SWORT-Aerospace/sem-motor-controller/hardware/interfaces/README.md

# Interfaces

* `pin_allocation_STM32G474VBCETx.csv` (LQFP100, proposed), `..._MBCETx.csv` (LQFP80), `..._RBCETx.csv` (LQFP64): candidate pin maps produced by `tools/pin_allocation.py` from ST's open pin database (BSD-3, commit 7d1f151). Status: CANDIDATE — AF numbers and timing not verified.
* Electrical I/O list: `docs/INTERFACE_CONTROL.md` §3.
* CAN: `docs/generated/can_messages.md`.
