SWORT-Aerospace/sem-motor-controller/hardware/timing/timing_budget.md

# MCU timing allocation and current-sampling budget (generated)

> Generated by `tools/timing_budget.py`. Tags: [C] project config (synthetic), [R] recalled from ST/TI documentation and **not verified** here, [A] assumption to be measured at bench stage 3/4, [D] design value in the schematic draft. Nothing here is a hardware measurement.

## Inputs

| constant | value | tag | note |
|---|---|---|---|
| f_sysclk_Hz | 170000000.0 | [R] | STM32G474 max SYSCLK (boost mode) |
| f_pwm_Hz | 20000.0 | [C] | inverter.pwm_frequency_Hz |
| t_dead_s | 2e-07 | [C] | inverter.deadtime_s |
| duty_max | 0.98 | [C] | inverter.duty_max |
| f_adc_Hz | 42500000.0 | [R] | ADC clock = HCLK/4 synchronous (one legal choice; max ADC clock to verify) |
| adc_sample_cycles | 6.5 | [D] | sampling time setting for the CSA channels (2.5..640.5 selectable [R]) |
| adc_conv_cycles | 12.5 | [R] | 12-bit successive-approximation conversion |
| c_sh_F | 5e-12 | [R] | ADC sample-and-hold capacitance (order of magnitude) |
| r_filter_ohm | 100.0 | [D] | CSA output series R (current_sense sheet) |
| c_filter_F | 4.7e-10 | [D] | CSA output shunt C (current_sense sheet) |
| t_ring_s | 5e-07 | [A] | switch-node ringing settle after the low-side turns on |
| t_csa_settle_s | 1e-06 | [A] | CSA output settling to 0.1 % after the step (SLVSDY6x value NOT read) |
| voltage_limit_fraction | 0.95 | [C] | inverter.voltage_limit_fraction (FOC uses this x Vbus/sqrt(3)) |
| t_dts_div | 1 | [D] | TIM1 CKD = 1 -> t_DTS = 1/f_tim |
| brk_filter_samples | 4 | [D] | TIM1 BKF digital filter length (N samples at f_DTS) |
| fast_isr_cycles_est | TBD | [A] | FOC fast-step cycles: MEASURE with DWT->CYCCNT at stage 2 |

## PWM (TIM1, centre-aligned, complementary, 6-PWM to the gate driver)

* Period 50.0 us; ARR = f_tim / (2 f_pwm) = 4250 (duty resolution 0.024 %).
* Dead time 200 ns -> BDTR.DTG = 0x22 -> 200.0 ns achieved (t_DTS = 5.88 ns). The gate driver may add its own dead time; the effective dead time is the larger of the two and must be measured at the gate (stage 3).

## Phase-current sampling on three ADCs (PROPOSED, not substantiated)

* **Proposed, not yet substantiated:** it holds only once the trigger configuration, the ADC synchronisation, the acquisition windows and a bench measurement (stage 4) confirm it.
* Phase A on ADC1, phase B on ADC2 (dual simultaneous injected mode), phase C on ADC3, injected, with the same external trigger TIM1_TRGO2 [R]. The three sample-and-hold instants would coincide to within ADC clock synchronisation (< 1 ADC clock); in v0.1 phase C sat behind phase A in ADC1 by 447 ns.
* Pins (generated, `hardware/interfaces/pin_allocation_STM32G474VBCETx.csv`): PA0 ADC1_IN1, PA1 ADC2_IN2, PE7 ADC3_IN4, all IN1..IN5 "fast" channels [R].
* Sampling time 6.5 cycles = 153 ns; with conversion 447 ns. External RC tau = 47 ns; settling to 1 LSB (12 bit) = 391 ns. Charge kick-back from C_SH: 1.05 % of the step between successive samples on the same input, absorbed by the 470 pF reservoir (re-check with the real C_SH).

## Sampling window (low-side shunts, sample at the PWM valley)

* Time needed between low-side turn-on and the sample: dead time + ringing + max(CSA settle, RC settle) = 1.70 us ([A] ringing 500 ns, [A] CSA settle 1.0 us).
* Largest sampleable duty: **0.932** (configured duty_max 0.98).
* Over all SVPWM angles at the configured voltage limit (0.95 x Vbus/sqrt(3)), the minimum number of phases with a valid window is **2**. Firmware rule: a phase is valid only when its duty is <= 0.932. With one invalid phase, the controller reconstructs it from the other two (`mc_currents_resolve`; reconstructed phase flagged, KCL residual unavailable). With two or more invalid phases, it would need to reduce duty_max; not reached at these values.

### Largest safe voltage-limit fraction (validator rule 39)

Rule 39: 0.5 + (sqrt(3)/4) m <= 1 - 2 (t_dead + t_settle) f_pwm, where t_settle = `inverter.current_sample_settle_s` is measured at stage 4. The second-highest min-max SVPWM duty peaks at 60 deg; satisfying the rule leaves two sampleable phases at every angle.

| f_pwm kHz | settle 0.5us | settle 1.0us | settle 1.5us | settle 2.0us | settle 3.0us |
|---|---|---|---|---|---|
| 10 | 1.000 | 1.000 | 1.000 | 1.000 | 1.000 |
| 16 | 1.000 | 1.000 | 1.000 | 0.992 | 0.918 |
| 20 | 1.000 | 1.000 | 0.998 | 0.951 | 0.859 |
| 25 | 1.000 | 1.000 | 0.958 | 0.901 | 0.785 |

With the configured limit 0.95 at 20 kHz, the rule holds while the measured settle stays at or below 2.02 us. Above that, the validator rejects the calibration until the limit or the PWM frequency is lowered (synthetic value 1.5 us).

## Break (hardware shutdown) routing

| source | path | polarity | action |
|---|---|---|---|
| Gate-driver nFAULT (VDS over-current, UVLO, thermal, ...) [R] | PE15 TIM1_BKIN | active low, open drain + 10 k pull-up | MOE cleared asynchronously; outputs to idle state |
| Bus over-voltage comparator (TLV7041) | PC3 TIM1_BKIN2 | active low, open drain | as above |
| (option) MCU COMPx on CSA outputs | internal to TIM1_BKIN2 [R] | configurable | phase over-current without a pin; not used in the draft |

* Idle state: OSSI = 1, OISx = OISxN = 0, so every INHx/INLx is driven low and the driver holds all gates off. AOE = 0: MOE is never re-set automatically; only firmware does it, after a fault reset.
* BKF digital filter: 4 samples -> 24 ns added latency [D]. Measure the total input-to-gate-off latency at stage 3.

## Startup pin states (reset until firmware configures the pins)

| signal | state during/after reset | why it is safe |
|---|---|---|
| MCU GPIOs | analog / high impedance [R] (debug pins PA13/PA14/PB3 excepted) | nothing below depends on an MCU pin being driven |
| DRV ENABLE | low: MCU_DRV_EN pulled down 100 k and ANDed with HW_PERMIT (74LVC1G08); output pulled down 100 k | gate driver disabled, all gates off [R] |
| INHx / INLx | low: driver internal pull-downs [R]; DNP 100 k pads | no switching command |
| Precharge bypass | off: PRECHG_EN pulled down 100 k | DC link charges only through the precharge resistor |
| CAN TXD | recessive: transceiver TXD pull-up [R] | no bus disturbance during reset |
| BOOT0 (PB8) | low: 10 k pull-down | boots from flash |

## Interrupt and task timing allocation

| priority | source | rate | budget | content |
|---|---|---|---|---|
| 0 (highest) | TIM1 BRK / BRK2 | event | < 2 us | latch fault flag; hardware has already stopped the outputs |
| 1 | ADC JEOC (injected end of conversion) | 20 kHz | <= 40 % of 50 us = 20 us | `mc_core_fast_step`: hall, currents, FOC, duty update (preloaded) |
| 2 | FDCAN RX FIFO | <= 2 kHz | <= 5 us | copy the frame to a queue; decoding runs in the slow task |
| 3 | SysTick / slow task | 1 kHz | <= 300 us | `mc_core_slow_step`, CAN RX decoding, TX polling, watchdog kick |
| background | idle | - | - | logging over UART (bench only) |

The fast-step cycle count is **not measured**. The host build shows no double-precision calls in `mc_core_fast_step` (objdump, MinSizeRel). It uses `sinf`/`cosf` from newlib. Measure DWT->CYCCNT around the ISR at stage 2 and replace `fast_isr_cycles_est`. If it exceeds the budget, use a table-based sin/cos, or run the FOC every second PWM period with ADC sampling every period.
