SWORT-Aerospace/sem-motor-controller/hardware/kicad/CONNECTIVITY_CHECK.md

# Schematic connectivity check (generated)

kicad-cli 7.0.11 exported the netlist of the draft; every intended net was compared with KiCad's computed connectivity (same node set).

* intended nets: 135
* KiCad nets: 173 (of which no-connect singletons: 38)
* problems: 0

No mismatches: KiCad connectivity equals the intended connectivity.

This checks connectivity only. It is not an electrical rules check (KiCad 7 has no CLI ERC) and not a design review.
