SWORT-Aerospace/sem-motor-controller/docs/BUDGET.md

# Budget decision: priced draft design (provisional)

> Generated by `tools/price_bom.py` from the schematic-derived BOM (`hardware/bom/BOM_draft.csv`) and the pricing evidence in `hardware/bom/pricing.yaml`. **Nothing has been purchased.**

> **Price quality.** Distributor sites could not be opened from this environment. Prices come from web-search snapshots of distributor pages (undated caches, retrieved 2026-10-15), from **representative** candidates for the rating-dependent parts (not selections), or from stated **allowances**. Every number is a range. Re-quote on live pages before deciding anything.

## 1. One board's parts by evidence class

| evidence | BOM lines | parts cost per board |
|---|---|---|
| allowance | 84 | $24.07 – $123.80 |
| representative | 11 | $40.91 – $77.56 |
| snippet | 5 | $24.20 – $29.66 |
| **total** | 100 | **$89.18 – $231.02** |

The rating-dependent lines (MOSFETs, shunts, bulk capacitors, fuse, TVS, P-FET, connectors) are priced as representatives. Their real cost moves with the motor and battery ratings.

## 2. Scenarios (low – high)

| scenario | A. controller only | B. A + vehicle integration | C. B + bring-up equipment if not owned | $500 − B (low / high end) | $1,000 − C (low / high end) |
|---|---|---|---|---|---|
| S1 one functional prototype | $246 – $650 | $311 – $825 | $415 – $1,189 | $189 / −$325 | $585 / −$189 |
| S1R one prototype + one revision | $337 – $898 | $402 – $1,073 | $506 – $1,437 | $98 / −$573 | $494 / −$437 |
| S2 two assembled boards | $353 – $953 | $428 – $1,158 | $532 – $1,522 | $72 / −$658 | $468 / −$522 |
| S2R two boards + one revision | $443 – $1,201 | $518 – $1,406 | $622 – $1,770 | −$18 / −$906 | $378 / −$770 |

A = board parts, spares, PCB, shipping, stencil, consumables, heatsink, tax/shipping on parts, and the revision allowance where named. B adds connectors, harness, enclosure and bench load. C adds the bring-up tools the team may not own; an oscilloscope and a differential probe are NOT included and must be borrowed. A negative remainder means over budget at that end of the range.

Contingency = budget minus the HIGH end of the range. The vs-$500 column assumes the team already owns the bring-up equipment; the vs-$1,000 column assumes it buys the listed items (an oscilloscope and a differential probe are NOT included: they must be borrowed).

## 3. Line items of scenario S1 (one prototype)

* Parts for one board: $89 – $231; spares (6 MOSFETs, gate driver, 2 shunts, TVS, 2 fuses, CAN transceiver, MCU): $58 – $93; tax and shipping on parts: $12 – $77.
* PCB fabrication, 5 boards, 4-layer, 2 oz outer copper, ~100x120 mm: $40 – $120 (allowance)
* PCB shipping (express): $20 – $45 (allowance)
* Stencil (frameless) for hand assembly: $8 – $25 (allowance)
* Assembly consumables (paste, flux, wick): $10 – $25 (allowance)
* Thermal interface + heatsink plate + fasteners: $10 – $35 (allowance)
* [integration] Battery and motor mating connectors (XT90 pair, MR60/bullets): $5 – $15 (snippet)
* [integration] Signal connectors + crimp terminals (driver controls, hall, CAN, temp): $10 – $30 (allowance)
* [integration] Wire (10-12 AWG silicone, signal multicore, CAN twisted pair), heat-shrink, sleeving: $25 – $60 (allowance)
* [integration] Enclosure / mounting (printed or folded aluminium): $10 – $30 (allowance)
* [integration] Bench dummy load / power resistors + bench harness: $15 – $40 (allowance)
* [equipment, only if not owned] SWD programmer (STLINK-V3MINIE): $14 – $44 (snippet: Cytech ref $14.04; Farnell IE EUR 12.51 incl. VAT; Waveshare GBP 37.58 (snapshots))
* [equipment, only if not owned] USB-CAN adapter (CANable-class, candleLight firmware): $30 – $60 (allowance: not quoted)
* [equipment, only if not owned] Current-limited bench supply (>= 60 V or series-able, CC mode): $60 – $200 (allowance: not quoted)
* [equipment, only if not owned] Oscilloscope >= 100 MHz, 4 ch (+ differential probe for the switch node): $0 – $0 (allowance: assumed borrowed from the lab: NOT in the budget; a differential probe can cost more than this whole budget)
* [equipment, only if not owned] Bench DMM x2, clamp/current probe: $0 – $60 (allowance: assumed owned; clamp meter if not)

## 4. Decision statement (computed, not asserted)

* One prototype, controller only (A): STRADDLES $500 ($246 – $650): within only if prices land in the lower part of the range.
* One prototype with vehicle integration, equipment owned (B): STRADDLES $500 ($311 – $825): within only if prices land in the lower part of the range.
* One prototype + one revision + integration, equipment owned (B): STRADDLES $500 ($402 – $1,073): within only if prices land in the lower part of the range.
* Two boards + integration, equipment owned (B): STRADDLES $1,000 ($428 – $1,158): within only if prices land in the lower part of the range.
* Two boards + one revision + integration + equipment (C): STRADDLES $1,000 ($622 – $1,770): within only if prices land in the lower part of the range.

Largest contributors to the low–high spread (scenario S1): board parts (allowance + representative + snippet) ($142); PCB fabrication, 5 boards, 4-layer, 2 oz outer copper, ~100x120 mm ($80); tax and shipping on parts ($65); Wire (10-12 AWG silicone, signal multicore, CAN twisted pair), heat-shrink, sleeving ($35); spares ($35).

**Conclusion: the budget is not shown to be feasible.** At least one range reaches past its limit, so feasibility cannot be claimed until the spread is closed. Closing the spread takes: a live PCB quote for the actual board size and copper weight; live distributor quotes for the snippet lines; the motor and battery ratings (they fix the representative power-stage lines and the heatsink); and an inventory check of the passives and equipment the team already owns. Each of these narrows the range, and `tools/price_bom.py` recomputes the statement.

Conditions behind all the ranges:
  1. rating-dependent parts stay in the representative class (100 V D2PAK MOSFETs, 2512 shunts, ~220 µF bulk); ≥ 80 A peak or a battery above ~60 V changes the power stage, heatsink and copper weight;
  2. stock gaps seen in the snapshots are resolved (INA228 in the US, DRV8353SRTAR at Digi-Key, the 1 mΩ Kelvin shunt at 38 weeks);
  3. hand assembly by the vehicle team with the stencil (no PCBA service);
  4. an oscilloscope, a differential probe, a rework station and a reflow method are available.
