SWORT-Aerospace/sem-motor-controller/docs/generated/control_contract_before_after.md

# Control contract: before / after (SYNTHETIC)

> **What is checked, and what is not.** These rows check **command-ceiling compliance** (the accepted torque command against the hard ceiling) and **supervisory envelope ramp compliance** (against the permitted ramp: output above the envelope must fall at no less than slew_down_fast = 100 N*m/s, i.e. by slew_down_fast x dt on every update, so the worst-case deadline is max_motor_torque / slew_down_fast = 2 / 100 = 20 ms, which validator rule 38 bounds by supervision.timeout_s = 100 ms; SYNTHETIC values). They do **not** show the physical phase-current response (current-loop tracking on a real motor) or the battery-input current; those need bench measurements (`hardware/bringup/`).

> Host harness `firmware/platform/host/contract_report_main.c` on the synthetic configuration. Before = arbiter/core of commit `c0df363`; after = this tree. The hard ceiling and envelope columns are computed by an **independent oracle in the harness** from the contract (not read back from the arbiter). Every update is checked, not only the rows shown. Not hardware evidence. Generated by `tools/control_contract_report.py`.

## Contract checks over every update

| scenario | updates | hard-ceiling (command) violations before -> after (max excess N*m) | envelope-ramp violations before -> after (max excess N*m; permitted ramp >= 100 N*m/s, deadline 20 ms) | envelope settle ms before -> after |
|---|---|---|---|---|
| A1_hard_ceiling_thermal_step | 1107 | 9 (0.900) -> **0** (0.000) | 0 (0.000) -> **0** (0.000) | - -> - |
| A2_hard_ceiling_independent_of_slew | 1507 | 500 (0.999) -> **0** (0.000) | 0 (0.000) -> **0** (0.000) | - -> - |
| A3_battery_ceiling_rising_speed | 908 | 0 (0.000) -> **0** (0.000) | 0 (0.000) -> **0** (0.000) | - -> - |
| A4_envelope_torque_reduction | 1159 | 0 (0.000) -> **0** (0.000) | 149 (1.490) -> **0** (0.000) | 150 -> 15 |
| A5_envelope_power_speed_step | 1109 | 0 (0.000) -> **0** (0.000) | 87 (0.865) -> **0** (0.000) | 88 -> 9 |
| A6_brake_deadman_reengage | 934 | 0 (0.000) -> **0** (0.000) | 0 (0.000) -> **0** (0.000) | - -> - |
| B1_lower_limits_before_matching_request | 1470 | 0 (0.000) -> **0** (0.000) | 189 (1.300) -> **0** (0.000) | 190 -> 13 |
| B2_delayed_request_old_limits_ref | 1630 | 0 (0.000) -> **0** (0.000) | 349 (1.290) -> **0** (0.000) | 130 -> 13 |
| B3_reordered_request_ignored | 1221 | 0 (0.000) -> **0** (0.000) | 0 (0.000) -> **0** (0.000) | - -> - |
| B4_busoff_stale_reengage | 2007 | 0 (0.000) -> **0** (0.000) | 0 (0.000) -> **0** (0.000) | - -> - |

Envelope violation = output above the envelope and not falling by at least `slew_down_fast*dt` (the bounded ramp the contract permits). Settle = time from the first update with the output above the envelope until it is at or below it.

## A1_hard_ceiling_thermal_step

Manual, 2.0 N*m; FET temperature step puts the thermal-derate ceiling at 1.0 N*m.

| t ms | event | state | requested | accepted before | accepted after | iq_ref A before | iq_ref A after | hard ceiling (after) | envelope (after) | reasons before | reasons after |
|---|---|---|---|---|---|---|---|---|---|---|---|
| 1007.0 | steady_full_torque | MANUAL | 2.0000 | 2.0000 | **2.0000** | 33.333 | 33.333 | 2.0000 | - | `-` | `-` |
| 1008.0 | +1ms_after_ceiling_drop | DERATED | 2.0000 | 1.9000 | **1.0000** | 31.667 | 16.667 | 1.0000 | - | `CLAMP_DERATE|SLEW` | `CLAMP_DERATE` |
| 1012.0 | +5ms | DERATED | 2.0000 | 1.5000 | **1.0000** | 25.000 | 16.667 | 1.0000 | - | `CLAMP_DERATE|SLEW` | `CLAMP_DERATE` |
| 1017.0 | +10ms | DERATED | 2.0000 | 1.0000 | **1.0000** | 16.667 | 16.667 | 1.0000 | - | `CLAMP_DERATE` | `CLAMP_DERATE` |
| 1107.0 | +100ms | DERATED | 2.0000 | 1.0000 | **1.0000** | 16.667 | 16.667 | 1.0000 | - | `CLAMP_DERATE` | `CLAMP_DERATE` |

## A2_hard_ceiling_independent_of_slew

As A1 with both down-slews set to 1 N*m/s: the clamp must not depend on slew settings.

| t ms | event | state | requested | accepted before | accepted after | iq_ref A before | iq_ref A after | hard ceiling (after) | envelope (after) | reasons before | reasons after |
|---|---|---|---|---|---|---|---|---|---|---|---|
| 1007.0 | steady_full_torque | MANUAL | 2.0000 | 2.0000 | **2.0000** | 33.333 | 33.333 | 2.0000 | - | `-` | `-` |
| 1008.0 | +1ms_after_ceiling_drop | DERATED | 2.0000 | 1.9990 | **1.0000** | 33.317 | 16.667 | 1.0000 | - | `CLAMP_DERATE|SLEW` | `CLAMP_DERATE` |
| 1107.0 | +100ms | DERATED | 2.0000 | 1.9000 | **1.0000** | 31.667 | 16.667 | 1.0000 | - | `CLAMP_DERATE|SLEW` | `CLAMP_DERATE` |
| 1507.0 | +500ms | DERATED | 2.0000 | 1.5000 | **1.0000** | 25.000 | 16.667 | 1.0000 | - | `CLAMP_DERATE|SLEW` | `CLAMP_DERATE` |

## A3_battery_ceiling_rising_speed

Manual, full throttle; speed rises 150->449 rad/s, then a 1000 rad/s estimate step.

| t ms | event | state | requested | accepted before | accepted after | iq_ref A before | iq_ref A after | hard ceiling (after) | envelope (after) | reasons before | reasons after |
|---|---|---|---|---|---|---|---|---|---|---|---|
| 607.0 | w=150rad/s | MANUAL | 2.0000 | 2.0000 | **2.0000** | 33.333 | 33.333 | 2.0000 | - | `-` | `-` |
| 758.0 | w=300rad/s | MANUAL | 2.0000 | 2.0000 | **2.0000** | 33.333 | 33.333 | 2.0000 | - | `-` | `-` |
| 907.0 | w=449rad/s | MANUAL | 2.0000 | 0.0400 | **0.0400** | 0.667 | 0.667 | 0.0400 | - | `CLAMP_SPEED` | `CLAMP_SPEED` |
| 908.0 | speed_step_to_1000rad/s | MANUAL | 2.0000 | 0.0000 | **0.0000** | 0.000 | 0.000 | 0.0000 | - | `CLAMP_BATTERY|CLAMP_SPEED` | `CLAMP_BATTERY|CLAMP_SPEED` |

## A4_envelope_torque_reduction

ECO at 2.0 N*m; supervisor torque envelope drops to 0.5 N*m.

| t ms | event | state | requested | accepted before | accepted after | iq_ref A before | iq_ref A after | hard ceiling (after) | envelope (after) | reasons before | reasons after |
|---|---|---|---|---|---|---|---|---|---|---|---|
| 1009.0 | steady_2Nm | ECO_ASSIST | 2.0000 | 2.0000 | **2.0000** | 33.333 | 33.333 | 2.0000 | 2.0000 | `-` | `-` |
| 1010.0 | +1ms_after_envelope_drop | ECO_ASSIST | 2.0000 | 1.9900 | **1.9000** | 33.167 | 31.667 | 2.0000 | 0.5000 | `SLEW|SUP_BOUND` | `SLEW|SUP_BOUND` |
| 1019.0 | +10ms | ECO_ASSIST | 2.0000 | 1.9000 | **1.0000** | 31.667 | 16.667 | 2.0000 | 0.5000 | `SLEW|SUP_BOUND` | `SLEW|SUP_BOUND` |
| 1029.0 | +20ms | ECO_ASSIST | 2.0000 | 1.8000 | **0.5000** | 30.000 | 8.333 | 2.0000 | 0.5000 | `SLEW|SUP_BOUND` | `SUP_BOUND` |
| 1159.0 | +150ms | ECO_ASSIST | 2.0000 | 0.5000 | **0.5000** | 8.333 | 8.333 | 2.0000 | 0.5000 | `SLEW|SUP_BOUND` | `SUP_BOUND` |

## A5_envelope_power_speed_step

ECO with a 150 W power envelope; speed estimate steps 60->120 rad/s (envelope halves).

| t ms | event | state | requested | accepted before | accepted after | iq_ref A before | iq_ref A after | hard ceiling (after) | envelope (after) | reasons before | reasons after |
|---|---|---|---|---|---|---|---|---|---|---|---|
| 1009.0 | w=60rad/s | ECO_ASSIST | 2.0000 | 1.7500 | **1.7500** | 29.167 | 29.167 | 2.0000 | 1.7500 | `SUP_BOUND` | `SUP_BOUND` |
| 1010.0 | +1ms_w=120rad/s | ECO_ASSIST | 2.0000 | 1.7400 | **1.6500** | 29.000 | 27.500 | 2.0000 | 0.8750 | `SLEW|SUP_BOUND` | `SLEW|SUP_BOUND` |
| 1019.0 | +10ms | ECO_ASSIST | 2.0000 | 1.6500 | **0.8750** | 27.500 | 14.583 | 2.0000 | 0.8750 | `SLEW|SUP_BOUND` | `SUP_BOUND` |
| 1109.0 | +100ms | ECO_ASSIST | 2.0000 | 0.8750 | **0.8750** | 14.583 | 14.583 | 2.0000 | 0.8750 | `SUP_BOUND` | `SUP_BOUND` |

## A6_brake_deadman_reengage

ECO 1.5 N*m; brake; release (no new edge); new eco edge; dead-man released.

| t ms | event | state | requested | accepted before | accepted after | iq_ref A before | iq_ref A after | hard ceiling (after) | envelope (after) | reasons before | reasons after |
|---|---|---|---|---|---|---|---|---|---|---|---|
| 609.0 | eco_1.5Nm | ECO_ASSIST | 1.5000 | 1.5000 | **1.5000** | 25.000 | 25.000 | 2.0000 | 2.0000 | `-` | `-` |
| 610.0 | +1ms_brake | READY | 0.0000 | 0.0000 | **0.0000** | 0.000 | 0.000 | 2.0000 | - | `THROTTLE_LATCH` | `THROTTLE_LATCH` |
| 630.0 | brake_released_no_new_edge | READY | 0.0000 | 0.0000 | **0.0000** | 0.000 | 0.000 | 2.0000 | - | `-` | `-` |
| 634.0 | eco_reengaged_+1ms | ECO_ASSIST | 1.5000 | 0.0150 | **0.0150** | 0.250 | 0.250 | 2.0000 | 2.0000 | `SLEW` | `SLEW` |
| 933.0 | eco_reengaged_+300ms | ECO_ASSIST | 1.5000 | 1.5000 | **1.5000** | 25.000 | 25.000 | 2.0000 | 2.0000 | `-` | `-` |
| 934.0 | +1ms_deadman_released | READY | 0.0000 | 0.0000 | **0.0000** | 0.000 | 0.000 | 2.0000 | - | `THROTTLE_LATCH` | `THROTTLE_LATCH` |

## B1_lower_limits_before_matching_request

CAN: set 7 (2.0 N*m) in force at 1.8 N*m; set 8 (0.5 N*m) committed; requests keep referencing 7 for 60 ms.

| t ms | event | state | requested | accepted before | accepted after | iq_ref A before | iq_ref A after | hard ceiling (after) | envelope (after) | reasons before | reasons after |
|---|---|---|---|---|---|---|---|---|---|---|---|
| 1210.0 | eco_ref7_bound2.0 | ECO_ASSIST | 1.8000 | 1.8000 | **1.8000** | 30.000 | 30.000 | 2.0000 | 2.0000 | `-` | `-` |
| 1211.0 | +1ms_limits8_0.5_committed | ECO_ASSIST | 1.8000 | 1.8000 | **1.7000** | 30.000 | 28.333 | 2.0000 | 0.5000 | `-` | `SLEW|SUP_BOUND` |
| 1230.0 | +20ms_requests_still_ref7 | ECO_ASSIST | 1.8000 | 1.8000 | **0.5000** | 30.000 | 8.333 | 2.0000 | 0.5000 | `-` | `SUP_BOUND` |
| 1270.0 | +60ms_requests_still_ref7 | ECO_ASSIST | 1.8000 | 1.8000 | **0.5000** | 30.000 | 8.333 | 2.0000 | 0.5000 | `-` | `SUP_BOUND` |
| 1470.0 | requests_ref8 | ECO_ASSIST | 1.8000 | 0.5000 | **0.5000** | 8.333 | 8.333 | 2.0000 | 0.5000 | `SUP_BOUND` | `SUP_BOUND` |

## B2_delayed_request_old_limits_ref

CAN: set 8 (0.5) in force; a delayed request (new seq) referencing set 7 (2.0) arrives, then a stream of them.

| t ms | event | state | requested | accepted before | accepted after | iq_ref A before | iq_ref A after | hard ceiling (after) | envelope (after) | reasons before | reasons after |
|---|---|---|---|---|---|---|---|---|---|---|---|
| 1410.0 | eco_ref8_bound0.5 | ECO_ASSIST | 1.8000 | 0.5000 | **0.5000** | 8.333 | 8.333 | 2.0000 | 0.5000 | `SUP_BOUND` | `SUP_BOUND` |
| 1411.0 | +1ms_delayed_req_ref7 | ECO_ASSIST | 1.8000 | 0.5050 | **0.5000** | 8.417 | 8.333 | 2.0000 | 0.5000 | `SLEW` | `SUP_BOUND` |
| 1430.0 | +20ms | ECO_ASSIST | 1.8000 | 0.6000 | **0.5000** | 10.000 | 8.333 | 2.0000 | 0.5000 | `SLEW` | `SUP_BOUND` |
| 1630.0 | +220ms_stream_ref7 | ECO_ASSIST | 1.8000 | 1.6000 | **0.5000** | 26.667 | 8.333 | 2.0000 | 0.5000 | `SLEW` | `SUP_BOUND` |

## B3_reordered_request_ignored

CAN: a reordered request (old sequence number, 2.0 N*m) arrives during 0.8 N*m.

| t ms | event | state | requested | accepted before | accepted after | iq_ref A before | iq_ref A after | hard ceiling (after) | envelope (after) | reasons before | reasons after |
|---|---|---|---|---|---|---|---|---|---|---|---|
| 1210.0 | eco_0.8Nm | ECO_ASSIST | 0.8000 | 0.8000 | **0.8000** | 13.333 | 13.333 | 2.0000 | 2.0000 | `-` | `-` |
| 1211.0 | +1ms_reordered_frame | ECO_ASSIST | 0.8000 | 0.8000 | **0.8000** | 13.333 | 13.333 | 2.0000 | 2.0000 | `-` | `-` |
| 1221.0 | +11ms | ECO_ASSIST | 0.8000 | 0.8000 | **0.8000** | 13.333 | 13.333 | 2.0000 | 2.0000 | `-` | `-` |

## B4_busoff_stale_reengage

CAN: bus-off at 1.2 N*m; re-handshake with set 9 (0.6); driver edge; then the supervisor stops sending.

| t ms | event | state | requested | accepted before | accepted after | iq_ref A before | iq_ref A after | hard ceiling (after) | envelope (after) | reasons before | reasons after |
|---|---|---|---|---|---|---|---|---|---|---|---|
| 1210.0 | eco_bound1.2 | ECO_ASSIST | 1.5000 | 1.2000 | **1.2000** | 20.000 | 20.000 | 2.0000 | 1.2000 | `SUP_BOUND` | `SUP_BOUND` |
| 1211.0 | +1ms_bus_off | READY | 0.0000 | 0.0000 | **0.0000** | 0.000 | 0.000 | 2.0000 | - | `SUP_INVALID|THROTTLE_LATCH` | `SUP_INVALID|THROTTLE_LATCH` |
| 1466.0 | session_restored_no_driver_edge | READY | 0.0000 | 0.0000 | **0.0000** | 0.000 | 0.000 | 2.0000 | - | `-` | `-` |
| 1506.0 | driver_edge_+20ms | ECO_ASSIST | 1.5000 | 0.1000 | **0.1000** | 1.667 | 1.667 | 2.0000 | 0.6000 | `SLEW|SUP_BOUND` | `SLEW|SUP_BOUND` |
| 1906.0 | driver_edge_+420ms | ECO_ASSIST | 1.5000 | 0.6000 | **0.6000** | 10.000 | 10.000 | 2.0000 | 0.6000 | `SUP_BOUND` | `SUP_BOUND` |
| 2005.0 | 99ms_after_last_new_request | ECO_ASSIST | 1.5000 | 0.6000 | **0.6000** | 10.000 | 10.000 | 2.0000 | 0.6000 | `SUP_BOUND` | `SUP_BOUND` |
| 2007.0 | 101ms_after_last_new_request | READY | 0.0000 | 0.0000 | **0.0000** | 0.000 | 0.000 | 2.0000 | - | `SUP_INVALID|THROTTLE_LATCH` | `SUP_INVALID|THROTTLE_LATCH` |
