SWORT-Aerospace/sem-motor-controller/docs/generated/csia_comparison_synthetic.md

# CSIA vehicle adapter vs baselines - SYNTHETIC

> Synthetic sensors and faults (`host/csia_adapter/synthetic.py`). Shadow mode only. Generated by `tools/run_csia_study.py`. Not evidence about real sensors.

> **DEVELOPMENT SET (tuning data).** The adapter was designed and tuned on exactly these scenarios, so these numbers say nothing about generalisation. For held-out results, see `docs/csia/EVALUATION_RESULTS.md`.

## Nominal run (normal events only)

Normal events: standing-start traction slip, freewheel decoupling while coasting, three corners, +/-1 % grade, GNSS degradation 60-80 s, low-speed wheel-pulse quantisation, slow current-offset drift.

| monitor | ticks with any alarm (of 1199) |
|---|---|
| CSIA adapter (suspect or ambiguous) | 0 |
| B1 simple freshness/range checks | 0 |
| B2 fixed-threshold residuals (no regime gating) | 935 |

B2 nuisance alarms by residual: {'power': 2, 'rotor_vs_wheel_drive': 933, 'gnss_vs_wheel_l': 62, 'gnss_vs_wheel_drive': 66}

## Injected faults: first CORRECT attribution (s after injection)

| fault | true node | CSIA first | CSIA wrong attributions | CSIA ambiguous ticks in window | B1 first | B2 first (cannot attribute) |
|---|---|---|---|---|---|---|
| wheel_l_dropout (40-60 s) | wheel_l | 0.1 | none | 0 | not detected | 0.3 |
| rotor_stuck (40-70 s) | rotor | 8.7 | none | 37 | not detected | 0.0 |
| gnss_offset (30-50 s) | gnss | 0.1 | none | 0 | not detected | 0.3 |
| imu_bias (30-50 s) | imu | 3.9 | none | 25 | not detected | not detected |
| current_bias (30-50 s) | phase_current | 0.1 | none | 0 | not detected | 0.3 |
| dc_gain (40-70 s) | dc_meter | 11.2 | none | 30 | not detected | 8.4 |

Notes:
- Rotor-speed and power-balance relationships exist only while the motor drives through the freewheel; in this scenario the car coasts ~18 s between pulses, so detection of those faults waits for the next pulse (latency is regime-bound, reported, not hidden).
- B2 'first' times are NOT meaningful where B2 was already alarming on the fault-free run (e.g. rotor_vs_wheel_drive alarms during freewheel coasting): its detection is confounded by its nuisance rate.
- B2 raises an alarm on a residual but cannot say which sensor is wrong; B1 only sees stale/NaN/out-of-range values, so stuck-in-range, bias and gain faults pass it.
- Ambiguous ticks are periods where the evidence supports disagreement only; the adapter reports them instead of guessing.

Adapter + CSIA TrustCore tick time on this host (x86-64, CPython, HOST BENCHMARK - not a target measurement): mean 0.19 ms, max 1.40 ms at 10 Hz.
