SWORT-Aerospace/sem-motor-controller/docs/generated/optimization_synthetic.md

# Optimisation study v0.2 - SYNTHETIC

> **SYNTHETIC.** Vehicle, motor, inverter, battery and track are invented placeholders. These numbers demonstrate the method; they say nothing about the real vehicle. Generated by `tools/run_optimization.py`. **All v0.1 savings figures are superseded** (section 7).

Actuators are separate: **coast** (gates off), **propulsion** (controller torque) and **driver braking** (friction brake; issued as guidance, never a controller command). Every strategy below runs on one forward simulator. The route, start (rest at 0 m) and terminal condition (finish line; final speed free, no credit for remaining kinetic energy) are identical for all of them, and so are the finish target (1000 s limit − 30 s reserve), the torque limit, slews, the acceleration bound, the auxiliary load and the driver model (reaction 1.0 s, release 0.7 s). Nothing brakes automatically. Overspeed above a corner limit, or a missed stop, makes a run INVALID.

## 1. Battery-terminal energy accounting (see `docs/ENERGY_ACCOUNTING.md`)

| v m/s | T N*m | shaft W | motor friction W | Cu+Fe W | inverter W | aux W | battery W | wheel W | drivetrain loss W |
|---|---|---|---|---|---|---|---|---|---|
| 4.0 | 0.5 | 83.78 | 0.84 | 14.96 | 1.19 | 3.00 | 103.77 | 79.59 | 4.19 |
| 6.0 | 1.0 | 251.33 | 1.26 | 50.05 | 3.13 | 3.00 | 308.77 | 238.76 | 12.57 |
| 8.0 | 2.0 | 670.21 | 1.68 | 179.77 | 10.03 | 3.00 | 864.68 | 636.70 | 33.51 |

v0.1 charged `T·ω` and omitted the motor's own friction power `T_f·ω` (the 'motor friction' column) while driving. v0.2 charges the electromagnetic power `(T+T_f)·ω`.

## 2. Acceleration-clipping audit

v0.1 clipped the *acceleration* (`a = min(a, a_max)`) but charged the energy of the *full* torque. The fix limits the torque itself, so the force, torque, power and energy belong to the same operating point. Test: constant 2 N·m launch, 20 s.

| a_max | method | steps limited | battery J | tractive work J | ΔKE J | resistive J | residual J |
|---|---|---|---|---|---|---|---|
| synthetic_a_max_1.5 | v0.1_clip | 0 | 16461.6 | 11939.5 | 11177.0 | 762.5 | **-0.0** |
| synthetic_a_max_1.5 | v0.2_torque_limit | 0 | 16461.6 | 11939.5 | 11177.0 | 762.5 | **-0.0** |
| tight_a_max_0.3 | v0.1_clip | 400 | 8713.5 | 4775.2 | 1825.3 | 187.7 | **2762.3** |
| tight_a_max_0.3 | v0.2_torque_limit | 400 | 2897.9 | 2013.0 | 1825.3 | 187.7 | **0.0** |

With the synthetic `a_max` = 1.5 m/s² the limit never binds (2 N·m produces < 0.8 m/s²), so the v0.1 numbers were **not** distorted by clipping. With a binding limit, the v0.1 clip creates work that appears in neither kinetic energy nor losses (non-zero residual). The v0.2 limit has none.

## 3. DP grid convergence (track A, propulsion + coast + driver braking)

| ds m | dv m/s | DP battery J | DP brake J | DP time s | executed battery J | executed time s | valid | solve s |
|---|---|---|---|---|---|---|---|---|
| 20 | 0.40 | 44227 | 8084 | 964.5 | 44172 | 967.7 | True | 6.3 |
| 10 | 0.20 | 43742 | 8084 | 968.5 | 43733 | 976.4 | True | 14.0 |
| 5 | 0.10 | 41181 | 6063 | 969.2 | 41199 | 978.3 | True | 29.7 |
| 2.5 | 0.05 | 41125 | 6063 | 969.9 | 41169 | 980.7 | True | 67.4 |

Relative change in DP energy between the two finest grids: 0.13 %. Comparisons below use the second-finest grid; read their differences against this discretisation error, and treat optimality as holding only within the discretised model.

## 4a. Matched-time comparison, track A_synthetic (grid 5.0 m / 0.1 m/s)

| strategy | battery J | time s | friction-brake J | aux J | final v m/s | overspeed events (max m/s) | brake applications | accel events | energy residual J | parameters |
|---|---|---|---|---|---|---|---|---|---|---|
| dp_propulsion_coast_brake | 42684 | 967.7 | 7324 | 2903 | 3.90 | 0 (0.00) | 8 | 30 | 0.00 | `{"ds_m": 5.0, "dv_mps": 0.1, "policy": "propulsion_coast_brake", "plan_margin_mps": 0.3, "plan_internal_target_s": 961.5}` |
| constant_speed_driver_brake | 54541 | 970.0 | 12484 | 2910 | 6.06 | 0 (0.00) | 12 | 13 | -0.00 | `{"v_set_mps": 6.057}` |
| pulse_and_coast_driver_brake | 52473 | 969.5 | 12356 | 2909 | 6.15 | 0 (0.00) | 15 | 104 | 0.00 | `{"band_center_mps": 6.063, "band_width_mps": 0.5, "pulse_torque_Nm": 1.0}` |
| dp_torque_only | — | **infeasible** | | | | | | | | no feasible path for this actuator set; coasting alone cannot meet the downstream corner limit from s = 700 m (gravity/descent accelerates the vehicle above the limit even from rest) |
| constant_speed_torque_only | — | **infeasible** | | | | | | | | no coast envelope exists (see DP torque-only) |
| pulse_and_coast_torque_only | — | **infeasible** | | | | | | | | no coast envelope exists (see DP torque-only) |

**Torque-only on track A is physically infeasible.** Coasting from rest at 700 m (top of the 1 % descent) reaches 5.99 m/s at the R = 20 m corner, where the limit is 5.48 m/s. No torque schedule can fix that. Meeting that corner needs braking: the driver's friction brake in the first vehicle version, or regeneration later (deferred, ADR-0007). The DP reports this; it does not brake silently.

## 4b. Matched-time comparison, track B_synthetic_flat (grid 5.0 m / 0.1 m/s)

| strategy | battery J | time s | friction-brake J | aux J | final v m/s | overspeed events (max m/s) | brake applications | accel events | energy residual J | parameters |
|---|---|---|---|---|---|---|---|---|---|---|
| dp_propulsion_coast_brake | 33876 | 968.4 | 0 | 2905 | 3.79 | 0 (0.00) | 0 | 40 | 0.00 | `{"ds_m": 5.0, "dv_mps": 0.1, "policy": "propulsion_coast_brake", "plan_margin_mps": 0.3, "plan_internal_target_s": 966.4}` |
| dp_torque_only | 33872 | 970.5 | 0 | 2912 | 3.83 | 0 (0.00) | 0 | 45 | 0.00 | `{"ds_m": 5.0, "dv_mps": 0.1, "policy": "propulsion_coast", "plan_margin_mps": 0.3, "plan_internal_target_s": 968.4}` |
| constant_speed_driver_brake | 50398 | 970.0 | 6724 | 2910 | 6.30 | 0 (0.00) | 8 | 9 | -0.00 | `{"v_set_mps": 6.296}` |
| constant_speed_torque_only | 42905 | 970.0 | 0 | 2910 | 6.35 | 0 (0.00) | 0 | 1 | 0.00 | `{"v_set_mps": 6.348}` |
| pulse_and_coast_driver_brake | 44985 | 970.0 | 6344 | 2910 | 6.44 | 0 (0.00) | 14 | 93 | -0.00 | `{"band_center_mps": 6.309, "band_width_mps": 0.5, "pulse_torque_Nm": 1.0}` |
| pulse_and_coast_torque_only | 37132 | 970.0 | 0 | 2910 | 6.50 | 0 (0.00) | 0 | 100 | -0.00 | `{"band_center_mps": 6.382, "band_width_mps": 0.5, "pulse_torque_Nm": 1.0}` |

## 5. Driver-guidance robustness (track A braking plan)

The plan is issued with an assumed 1.0 s reaction. The rows vary the driver's actual reaction and achieved deceleration, with and without a planning margin below the corner limits.

| case | battery J | time s | friction-brake J | aux J | final v | overspeed events (max m/s) | brake applications | accel events | residual J |
|---|---|---|---|---|---|---|---|---|---|
| margin 0.0 m/s, reaction 0.5 s, decel x0.8 | 39902 | 930.3 **INVALID** | 3626 | 2791 | 4.36 | 7 (0.74) | 7 | 23 | -0.00 |
| margin 0.0 m/s, reaction 0.5 s, decel x1.0 | 39924 | 940.0 **INVALID** | 3998 | 2820 | 4.19 | 9 (0.59) | 7 | 23 | 0.00 |
| margin 0.0 m/s, reaction 0.5 s, decel x1.2 | 39984 | 947.0 **INVALID** | 4292 | 2841 | 4.09 | 10 (0.45) | 7 | 23 | 0.00 |
| margin 0.0 m/s, reaction 1.0 s, decel x0.8 | 40028 | 959.5 **INVALID** | 4708 | 2879 | 3.95 | 7 (0.14) | 7 | 23 | -0.00 |
| margin 0.0 m/s, reaction 1.0 s, decel x1.0 | 40121 | 977.4 | 5280 | 2932 | 3.68 | 0 (0.00) | 7 | 23 | -0.00 |
| margin 0.0 m/s, reaction 1.0 s, decel x1.2 | 40222 | 993.6 | 5744 | 2981 | 3.45 | 0 (0.00) | 4 | 23 | -0.00 |
| margin 0.0 m/s, reaction 1.5 s, decel x0.8 | 40175 | 981.6 | 5417 | 2945 | 3.71 | 0 (0.00) | 5 | 23 | -0.00 |
| margin 0.0 m/s, reaction 1.5 s, decel x1.0 | 40293 | 1011.7 **OVER LIMIT** | 6165 | 3035 | 3.23 | 0 (0.00) | 4 | 23 | 0.00 |
| margin 0.0 m/s, reaction 1.5 s, decel x1.2 | 40528 | 1049.4 **OVER LIMIT** | 6964 | 3148 | 2.63 | 0 (0.00) | 4 | 23 | -0.00 |
| margin 0.3 m/s, reaction 0.5 s, decel x0.8 | 40999 | 945.5 **INVALID** | 5212 | 2837 | 4.32 | 5 (0.16) | 7 | 29 | -0.00 |
| margin 0.3 m/s, reaction 0.5 s, decel x1.0 | 41047 | 952.2 **INVALID** | 5452 | 2857 | 4.22 | 1 (0.07) | 7 | 29 | 0.00 |
| margin 0.3 m/s, reaction 0.5 s, decel x1.2 | 41096 | 960.3 | 5714 | 2881 | 4.10 | 0 (0.00) | 7 | 29 | -0.00 |
| margin 0.3 m/s, reaction 1.0 s, decel x0.8 | 41120 | 965.0 | 5874 | 2895 | 4.03 | 0 (0.00) | 6 | 29 | -0.00 |
| margin 0.3 m/s, reaction 1.0 s, decel x1.0 | 41199 | 978.3 | 6270 | 2935 | 3.85 | 0 (0.00) | 6 | 29 | -0.00 |
| margin 0.3 m/s, reaction 1.0 s, decel x1.2 | 41276 | 991.7 | 6612 | 2975 | 3.67 | 0 (0.00) | 5 | 29 | -0.00 |
| margin 0.3 m/s, reaction 1.5 s, decel x0.8 | 41242 | 986.6 | 6509 | 2960 | 3.69 | 0 (0.00) | 4 | 29 | -0.00 |
| margin 0.3 m/s, reaction 1.5 s, decel x1.0 | 41368 | 1004.2 **OVER LIMIT** | 6952 | 3013 | 3.45 | 0 (0.00) | 5 | 29 | 0.00 |
| margin 0.3 m/s, reaction 1.5 s, decel x1.2 | 41460 | 1027.0 **OVER LIMIT** | 7388 | 3081 | 3.20 | 0 (0.00) | 5 | 29 | -0.00 |

## 6. Robustness of the fixed braking plan to model error

| case | DP no pace E / T / valid | DP + bounded pace E / T / valid |
|---|---|---|
| nominal | 42684 J / 967.7 s / valid | 47061 J / 958.5 s / valid |
| crr+20% | 42978 J / 1034.3 s / **OVER LIMIT** | 52192 J / 958.6 s / valid |
| cda+20% | 42744 J / 989.8 s / valid | 48335 J / 958.5 s / valid |
| mass+5% | 42805 J / 1003.1 s / **OVER LIMIT** | 49391 J / 958.4 s / valid |
| crr-20% | 42440 J / 919.4 s / valid | 41999 J / 957.5 s / valid |
| headwind 2 m/s | 43017 J / 1052.5 s / **OVER LIMIT** | 53116 J / 958.8 s / valid |

## 7. Superseded v0.1 figures

The v0.1 study (39.7 kJ DP, 46.2 kJ pulse-and-coast, 55.1 kJ constant speed, i.e. 28 % and 14 % 'savings') is **withdrawn**. Its DP exported braking segments as coast. Its simulator braked every strategy automatically to an envelope. Its power map omitted the motor friction power. Use only the v0.2 tables above, and only as a demonstration of method on synthetic models.
