SWORT-Aerospace/sem-motor-controller/docs/generated/electrical_calcs_synthetic.md

# Electrical calculations and sensitivity - SYNTHETIC

> **SYNTHETIC operating points; MOSFET data are UNVERIFIED search-snippet values** (ti.com / infineon.com unreachable). `qgs2`, plateau voltage, Qrr and gate-drive settings are assumptions for the method. Nothing here selects or approves a component. Generated by `tools/run_electrical_calcs.py`.

## 1. Design bus voltage

V_design = V_max_charged x (1 + margin) + measured ringing. With the synthetic 12S pack (50.4 V) and a 25 % placeholder margin: **63.0 V** before ringing. The margin must be replaced by measured switching overshoot (double-pulse test) and any back-EMF/regen pumping. A device's absolute-maximum rating is not a continuous operating rating, and a 100 V-rated driver pin does not make a 100 V bus safe (the DRV8353 snippet data show VM 9-75 V operating, 80 V abs. max, VDRAIN 102 V abs. max - UNVERIFIED).

## 2. Inverter loss by operating point (W, whole bridge, Tj solved iteratively, 20 kHz, 200 ns dead time)

| candidate | cruise 6 m/s (light load) | pulse/accel 6 m/s | standing start peak | coast, zero-current control | run-weighted W |
|---|---|---|---|---|---|
| CSD19536KTT (D2PAK) [snippet] | 0.84 (Tj 51) | 3.70 (Tj 55) | 10.46 (Tj 65) | 0.69 (Tj 51) | 1.65 |
| CSD19535KTT (D2PAK) [snippet] | 0.57 (Tj 51) | 3.82 (Tj 56) | 12.67 (Tj 69) | 0.45 (Tj 51) | 1.48 |
| CSD19532Q5B (SON5x6) [snippet] | 0.40 (Tj 51) | 4.56 (Tj 57) | 17.22 (Tj 77) | 0.29 (Tj 50) | 1.49 |
| BSC040N10NS5 (SuperSO8) [snippet] | 0.34 (Tj 50) | 4.02 (Tj 56) | 14.47 (Tj 73) | 0.22 (Tj 50) | 1.33 |

Time weights per operating point are synthetic (from the shape of the DP plan: mostly coasting, short pulses). **Finding:** at the light-load points that dominate an eco-marathon run, gate-charge, Coss and switching terms dominate and the lowest-RDS(on) device is not the most efficient; at the standing-start peak, conduction dominates. The ranking therefore depends on the real drive-cycle current distribution, which is unmeasured.

## 3. Parallel devices per switch (BSC040N10NS5 snippet values)

| devices per switch | run-weighted W | peak-point W |
|---|---|---|
| 1 | 1.33 | 14.90 |
| 2 | 1.43 | 10.40 |
| 3 | 1.72 | 10.16 |

More parallel devices lower peak-current conduction loss but raise gate-drive and Coss losses at light load; with these synthetic weights they do not improve run energy.

## 4. Switching frequency (hypothesis H1)

| f_sw kHz | run-weighted inverter + ripple-copper W | ripple copper W |
|---|---|---|
| 5 | 6.54 | 5.88 |
| 8 | 3.02 | 2.30 |
| 10 | 2.23 | 1.47 |
| 15 | 1.51 | 0.65 |
| 20 | 1.33 | 0.37 |
| 30 | 1.33 | 0.16 |
| 40 | 1.46 | 0.09 |

With L = 150 uH (synthetic) the minimum is near **30 kHz**. Ripple-induced iron loss is not modelled. The optimum moves with the real motor inductance and the light-load fraction - both unknown. Coasting with gates off removes the switching term entirely when back-EMF < Vbus.

## 5. Dead time (hypothesis H2)

| dead time ns | run-weighted W |
|---|---|
| 50 | 1.312 |
| 100 | 1.318 |
| 200 | 1.330 |
| 400 | 1.354 |

Body-diode conduction grows linearly with dead time; the lower bound is set by measured switching transitions (shoot-through margin), not by this model. Voltage distortion is not modelled.

## 6. Phase-current shunt: dissipation vs resolution vs offset

Amplifier gains 5/10/20/40 V/V and ~+/-3 mV input offset are DRV8353 CSA snippet values (UNVERIFIED). 12-bit ADC, 3.3 V reference, 40 A peak.

| shunt mOhm | gain | full scale A | LSB mA | shunt W @40 A pk | offset A @3 mV | offset vs 2 A cruise |
|---|---|---|---|---|---|---|
| 0.5 | 10 | 330 | 161 | 0.20 | 6.00 | 300 % |
| 0.5 | 20 | 165 | 81 | 0.20 | 6.00 | 300 % |
| 0.5 | 40 | 82 | 40 | 0.20 | 6.00 | 300 % |
| 1.0 | 5 | 330 | 161 | 0.40 | 3.00 | 150 % |
| 1.0 | 10 | 165 | 81 | 0.40 | 3.00 | 150 % |
| 1.0 | 20 | 82 | 40 | 0.40 | 3.00 | 150 % |
| 2.0 | 5 | 165 | 81 | 0.80 | 1.50 | 75 % |
| 2.0 | 10 | 82 | 40 | 0.80 | 1.50 | 75 % |
| 5.0 | 5 | 66 | 32 | 2.00 | 0.60 | 30 % |

**Finding:** an uncalibrated 3 mV offset on a 1 mOhm shunt is a 3 A error, larger than the ~2 A cruise current. Per-board zero-current offset calibration (stored in the calibration blob, `inverter.current_offset_counts`), temperature-drift measurement and a separate high-resolution DC-bus energy monitor (INA228-class: ~1 uV offset snippet value) are required; phase-shunt data must not be used for energy accounting.

## 7. DC-link capacitor ripple and precharge

Ripple RMS (Kolar-Round form, verified numerically in tests/simulation/test_models.py) at 40 A peak phase current: worst case **17.3 A rms** at M ~ 0.65. Continuous ripple rating should use the real drive-cycle RMS (unknown); peak events are short.

- C = 470 uF, R_pre = 47 Ohm: tau 22 ms, 95 % in 66 ms, resistor pulse energy 0.60 J, initial peak 54 W; switching ripple bound 1.06 V pp at 40 A.
- C = 1000 uF, R_pre = 47 Ohm: tau 47 ms, 95 % in 141 ms, resistor pulse energy 1.27 J, initial peak 54 W; switching ripple bound 0.50 V pp at 40 A.
- C = 2200 uF, R_pre = 22 Ohm: tau 48 ms, 95 % in 145 ms, resistor pulse energy 2.79 J, initial peak 115 W; switching ripple bound 0.23 V pp at 40 A.

Under the (unverified) SEM rule that the e-stop physically isolates the battery with normally-open contacts, the controller sees a hard connect on every enable: precharge sizing and contactor/relay inrush rating are mandatory review items. Discharge of the DC link after isolation must be provided (bleeder or active) and its time constant documented.

## 8. Thermal, conductors, fuse, auxiliary energy

- Hottest device at standing-start peak (continuous assumption), 50 degC enclosure, Rth_cs 0.5 + Rth_sa 4 K/W: **Tj 62 degC**. Real peaks are short: transient thermal impedance must be used with measured profiles.
- Battery cable 2 x 1 m, 4 mm2, at 15 A rms: 1.93 W; at the 2 A cruise current 34.4 mW.
- Fuse example (rating 40 A, 4 mm2 ampacity assumed 32 A): {'carries_continuous': True, 'protects_wire': False, 'breaking_capacity_ok': False, 'peak_note': 'peak 60.0 A for 10.0 s must lie below the fuse curve (not checked)'} - the example deliberately fails two checks: wire and breaking capacity must be chosen together with the battery short-circuit current (unknown).

- Auxiliary energy per 1000 s run (SYNTHETIC power figures): controller logic + gate driver 0.80 kJ, INA228 + CAN transceiver 0.10 kJ, companion computer (Pi-class) 4.00 kJ, cellular modem (average) 1.50 kJ, GNSS 0.15 kJ; **total 6.5 kJ** versus ~40 kJ synthetic propulsion energy. If, as the (unverified) rules indicate, a battery-electric car has no accessory battery and the joulemeter measures everything after the battery, telemetry/compute power is a first-order efficiency term (hypothesis H6).

## 9. Sensitivity of run-weighted inverter loss (tornado)

Baseline 1.33 W (BSC040N10NS5 snippet values, synthetic weights).

| input varied | low W | high W | swing W |
|---|---|---|---|
| drive-cycle phase current x0.5 / x2 (UNMEASURED) | 0.82 | 3.19 | 2.38 |
| RDS(on) x0.5 / x2 | 1.05 | 1.89 | 0.84 |
| f_sw 10 / 40 kHz | 2.23 | 1.46 | 0.77 |
| Qgd+Qgs2 x0.5 / x2 | 1.25 | 1.49 | 0.24 |
| Tj 40 / 120 degC | 1.27 | 1.50 | 0.22 |
| Qoss x0.5 / x2 | 1.28 | 1.43 | 0.16 |
| Qg x0.5 / x2 | 1.30 | 1.40 | 0.10 |
| dead time 100 / 400 ns | 1.32 | 1.35 | 0.04 |

### Which missing measurements dominate component selection

| selection decision | dominated by (missing measurement) | why |
|---|---|---|
| MOSFET V_DS rating | max charged pack voltage; measured switching overshoot; back-EMF at max speed | sets V_design (section 1) |
| MOSFET RDS(on) vs Qg trade | drive-cycle phase-current distribution (time at light load vs peak) | ranking flips between light load and peak (section 2) |
| parallel count | peak phase current and its duration; thermal path | conduction vs gate/Coss trade (section 3) |
| PWM frequency | motor phase inductance; light-load fraction | ripple copper vs switching (section 4) |
| shunt value / CSA gain | peak phase current; amplifier offset & drift; cruise current | full scale vs offset error (section 6) |
| DC-link C and ripple rating | drive-cycle RMS phase current; modulation index range; battery/cable inductance | section 7 |
| precharge resistor | DC-link C; isolation-relay topology (rule-dependent) | pulse energy, inrush |
| fuse / conductors | BMS limits; battery short-circuit current; harness length | section 8 |
| heatsink / enclosure | loss profile over a run; enclosure ambient; airflow | section 8 |
