SWORT-Aerospace/sem-motor-controller/docs/figures/dp_plan_synthetic.png

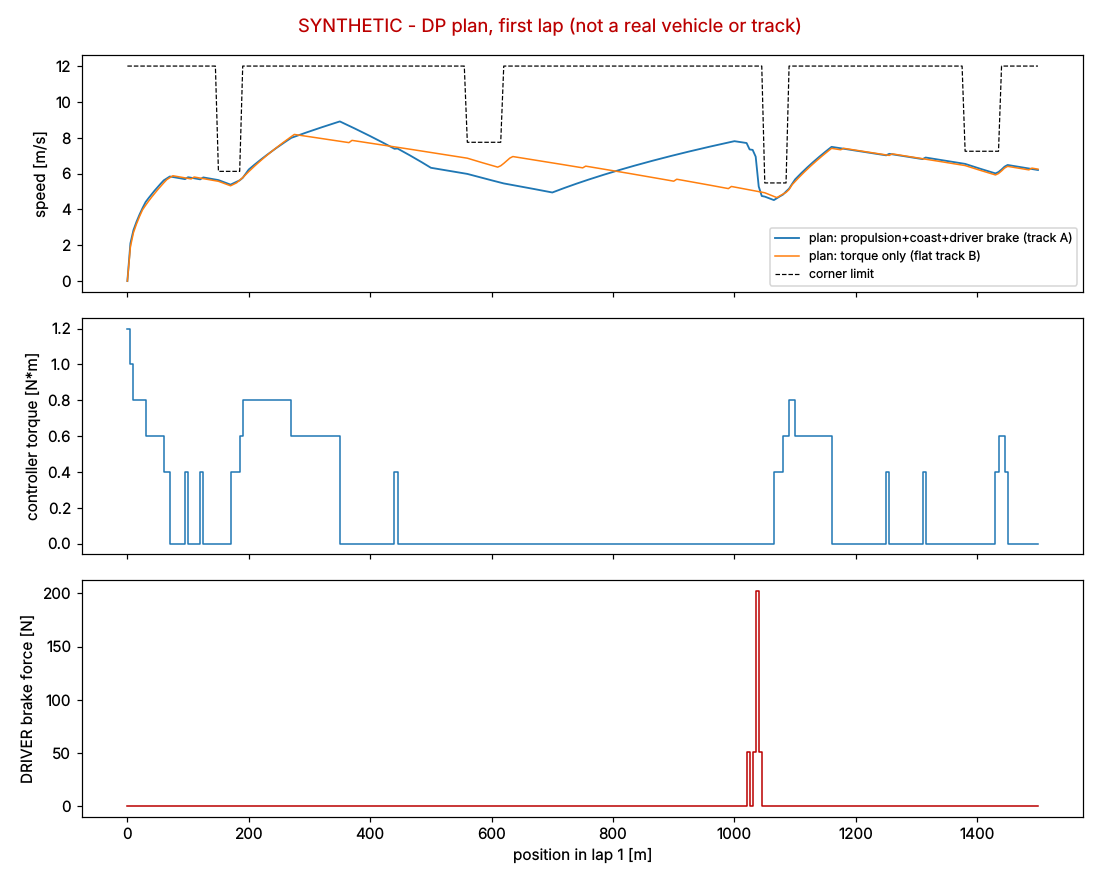
docs/figures/dp_plan_synthetic.png
