SWORT-Aerospace/sem-motor-controller/docs/figures/electrical_sensitivity_synthetic.png

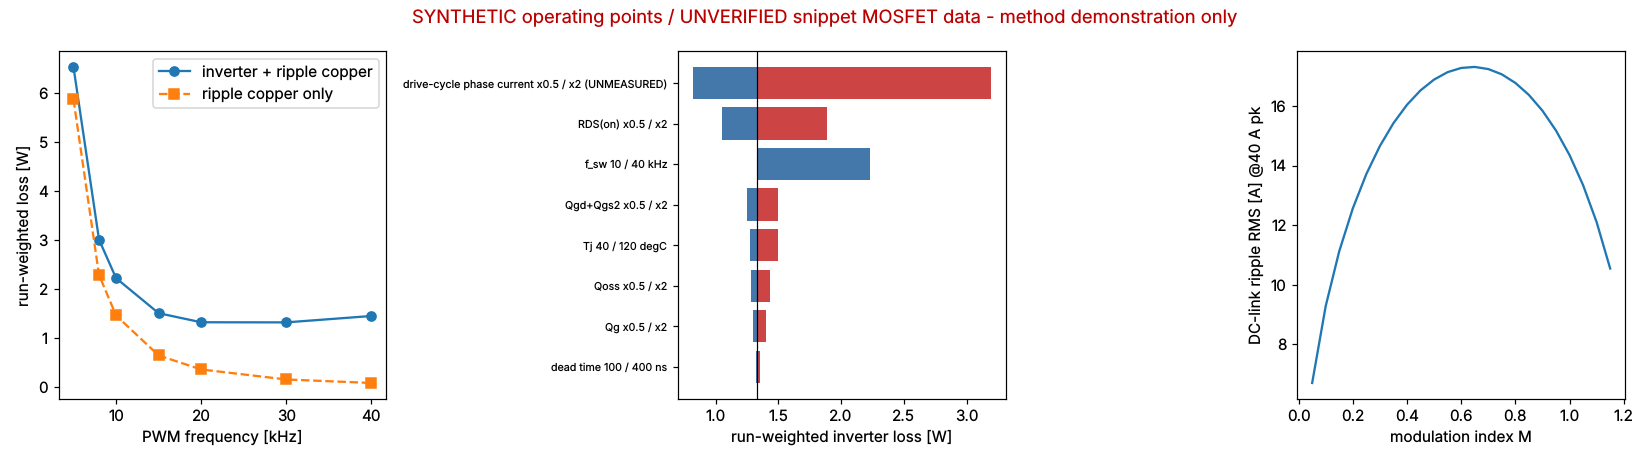
docs/figures/electrical_sensitivity_synthetic.png
