SWORT-Aerospace/sem-motor-controller/hardware/bom/BOM_priced.csv

line | refs | qty_per_board | mpn | value | package | footprint | rating_basis | supplier | unit_low | unit_high | price_date | ext_low | ext_high | availability | alternate | selection_status | evidence | source | pin_check
1 | C101 | 1 | UNRESOLVED >=100 V X7R MLCC (1206/1210) | UNRESOLVED 100V MLCC | 1206/1210 | UNASSIGNED (draft) | >= 1.25 x V_bat,max | - | 0.2 | 0.8 | - | 0.2 | 0.8 | unknown |  | UNRESOLVED | allowance | not quoted
2 | C1103 | 1 | generic 0603 (1 % R / X7R C) | 4.7nF | 0603 | UNASSIGNED (draft) | split termination | - | 0.01 | 0.1 | - | 0.1 | 1.0 | n/a |  | design value | allowance | not quoted (cut-tape strips of 10-25)
3 | C1201 C1202 | 2 | UNRESOLVED >=100 V X7R MLCC (1206/1210) | UNRESOLVED 2.2uF 100V | 1206/1210 | UNASSIGNED (draft) | >= 1.25 x V_bat,max | - | 0.2 | 0.8 | - | 0.4 | 1.6 | unknown |  | UNRESOLVED | allowance | not quoted
4 | C1203 | 1 | generic 0603 (1 % R / X7R C) | 2.2nF (verify) | 0603 | UNASSIGNED (draft) |  | - | 0.01 | 0.1 | - | 0.1 | 1.0 | n/a |  | TYPICAL - verify vs DS | allowance | not quoted (cut-tape strips of 10-25)
5 | C1204 C1205 | 2 | generic 0603 (1 % R / X7R C) | 22uF | 0603 | UNASSIGNED (draft) |  | - | 0.01 | 0.1 | - | 0.1 | 1.0 | n/a |  | design value | allowance | not quoted (cut-tape strips of 10-25)
6 | C201 C202 C203 | 3 | UNRESOLVED (representative: 220 uF 100 V low-ESR radial) | UNRESOLVED bulk | radial (UNRESOLVED) | UNASSIGNED (draft) | ripple current (Kolar-Round at I_ph,max), V_rated >= 1.25 x V_bat,max, ESR, temperature | various | 0.83 | 4.82 | 2026-10-15 | 2.49 | 14.46 | listed |  | UNRESOLVED | representative | Panasonic EEU-FS2A221B ~$0.83 (third party); Mouser 220 uF/100 V low-ESR ~$4.82@1 (snapshot)
7 | C204 C205 C206 | 3 | UNRESOLVED >=100 V X7R MLCC (1206/1210) | UNRESOLVED MLCC (per half-bridge) | 1206/1210 | UNASSIGNED (draft) | >= 100 V X7R, DC-bias derated | - | 0.2 | 0.8 | - | 0.6 | 2.4 | unknown |  | UNRESOLVED | allowance | not quoted
8 | C1003 C1004 C1005 C1006 C1007 C1008 C207 C808 | 8 | generic 0603 (1 % R / X7R C) | 10nF | 0603 | UNASSIGNED (draft) |  | - | 0.01 | 0.1 | - | 0.1 | 1.0 | n/a |  | design value | allowance | not quoted (cut-tape strips of 10-25)
9 | C401 | 1 | generic 0603 (1 % R / X7R C) | 47nF (verify) | 0603 | UNASSIGNED (draft) | >= V_bat,max + 16 V | - | 0.01 | 0.1 | - | 0.1 | 1.0 | n/a |  | TYPICAL - verify vs DS | allowance | not quoted (cut-tape strips of 10-25)
10 | C402 C403 C404 | 3 | generic 0603 (1 % R / X7R C) | 1uF (verify) | 0603 | UNASSIGNED (draft) |  | - | 0.01 | 0.1 | - | 0.1 | 1.0 | n/a |  | TYPICAL - verify vs DS | allowance | not quoted (cut-tape strips of 10-25)
11 | C405 | 1 | UNRESOLVED >=100 V X7R MLCC (1206/1210) | UNRESOLVED 100nF 100V | 1206/1210 | UNASSIGNED (draft) | VM decoupling at the driver | - | 0.2 | 0.8 | - | 0.2 | 0.8 | unknown |  | UNRESOLVED | allowance | not quoted
12 | C501 C503 C505 | 0 | generic 0603 (1 % R / X7R C) | DNP (diff. filter option) | 0603 | UNASSIGNED (draft) |  | - | 0.01 | 0.1 | - | 0.0 | 0.0 | n/a |  | DNP option | allowance | not quoted (cut-tape strips of 10-25)
13 | C502 C504 C506 | 3 | generic 0603 (1 % R / X7R C) | 470pF | 0603 | UNASSIGNED (draft) | >> ADC S/H capacitance (charge kick-back) | - | 0.01 | 0.1 | - | 0.1 | 1.0 | n/a |  | design value | allowance | not quoted (cut-tape strips of 10-25)
14 | C1001 C1002 C1101 C1102 C601 C602 C701 C702 C801 C802 C803 C804 C805 C810 | 14 | generic 0603 (1 % R / X7R C) | 100nF | 0603 | UNASSIGNED (draft) |  | - | 0.01 | 0.1 | - | 0.14 | 1.4 | n/a |  | TYPICAL - verify | allowance | not quoted (cut-tape strips of 10-25)
15 | C806 | 1 | generic 0603 (1 % R / X7R C) | 4.7uF | 0603 | UNASSIGNED (draft) |  | - | 0.01 | 0.1 | - | 0.1 | 1.0 | n/a |  | design value | allowance | not quoted (cut-tape strips of 10-25)
16 | C1206 C1207 C807 C809 | 4 | generic 0603 (1 % R / X7R C) | 1uF | 0603 | UNASSIGNED (draft) |  | - | 0.01 | 0.1 | - | 0.1 | 1.0 | n/a |  | design value | allowance | not quoted (cut-tape strips of 10-25)
17 | C811 C812 | 2 | UNRESOLVED >=100 V X7R MLCC (1206/1210) | UNRESOLVED load | 1206/1210 | UNASSIGNED (draft) | from the selected crystal's C_L and stray | - | 0.2 | 0.8 | - | 0.4 | 1.6 | unknown |  | UNRESOLVED | allowance | not quoted
18 | C1009 C1104 C901 C902 C903 | 5 | generic 0603 (1 % R / X7R C) | 1nF | 0603 | UNASSIGNED (draft) | tau = 1 us | - | 0.01 | 0.1 | - | 0.1 | 1.0 | n/a |  | design value | allowance | not quoted (cut-tape strips of 10-25)
19 | D101 | 1 | UNRESOLVED (V_standoff >= V_bat,max) | UNRESOLVED TVS | SMC class | UNASSIGNED (draft) | V_standoff >= V_bat,max; V_clamp at surge current < V_DS(abs max) of the bridge MOSFETs | - | 0.5 | 2.0 | - | 0.5 | 2.0 | unknown |  | UNRESOLVED | allowance | not quoted
20 | D102 | 1 | generic (0603 LED / 0603 bead / SOD-123 zener / SMD tact) | 12V zener | 0603/SOD-123/SMD | UNASSIGNED (draft) | clamps V_GS of the bypass FET (check V_GS abs max of selected FET) | - | 0.05 | 0.5 | - | 0.05 | 0.5 | unknown |  | design value | allowance | not quoted
21 | D1101 | 1 | NUP2105LT1G | NUP2105L | SOT-23 | UNASSIGNED (draft) |  | - | 0.2 | 0.6 | - | 0.2 | 0.6 | unknown | PESD2CAN | CANDIDATE | allowance | not quoted
22 | D701 | 1 | ESD9B5.0ST5G / ESD9B3.3ST5G | ESD9B3.3ST5G | SOD-923 | UNASSIGNED (draft) |  | - | 0.05 | 0.3 | - | 0.05 | 0.3 | unknown | TPD1E10B06 | CANDIDATE | allowance | not quoted
23 | D801 | 1 | UNRESOLVED buck inductor | green | SMD power inductor | UNASSIGNED (draft) |  | - | 0.3 | 1.5 | - | 0.3 | 1.5 | unknown |  | design value | allowance | not quoted
24 | D802 | 1 | UNRESOLVED buck inductor | red | SMD power inductor | UNASSIGNED (draft) |  | - | 0.3 | 1.5 | - | 0.3 | 1.5 | unknown |  | design value | allowance | not quoted
25 | D803 | 1 | BAT54 | BAT54 | SOT-23 | UNASSIGNED (draft) | watchdog timeout pulls HW_PERMIT low (driver disabled in hardware) | - | 0.05 | 0.3 | - | 0.05 | 0.3 | unknown |  | CANDIDATE | allowance | not quoted
26 | D1001 D1002 D1003 D1004 D1005 D1006 D901 D902 D903 | 9 | ESD9B5.0ST5G / ESD9B3.3ST5G | ESD9B5.0ST5G | SOD-923 | UNASSIGNED (draft) |  | - | 0.05 | 0.3 | - | 0.45 | 2.7 | unknown | TPD1E10B06 | CANDIDATE | allowance | not quoted
27 | F1001 | 1 | PTC resettable fuse (hold current to select) | polyfuse (sensor supply) | 1206/1812 | UNASSIGNED (draft) |  | - | 0.1 | 0.6 | - | 0.1 | 0.6 | unknown |  | CANDIDATE | allowance | not quoted
28 | F101 | 1 | UNRESOLVED (rating from BMS/harness) | UNRESOLVED fuse | UNRESOLVED | UNASSIGNED (draft) | I_batt,max, V_bat,max, breaking capacity >= BMS short-circuit current | - | 2.0 | 8.0 | - | 2.0 | 8.0 | unknown |  | UNRESOLVED | allowance | not quoted (fuse + holder)
29 | F901 | 1 | PTC resettable fuse (hold current to select) | UNRESOLVED polyfuse | 1206/1812 | UNASSIGNED (draft) | hall supply current unknown | - | 0.1 | 0.6 | - | 0.1 | 0.6 | unknown |  | UNRESOLVED | allowance | not quoted
30 | FB801 | 1 | generic (0603 LED / 0603 bead / SOD-123 zener / SMD tact) | 600R@100MHz | 0603/SOD-123/SMD | UNASSIGNED (draft) |  | - | 0.05 | 0.5 | - | 0.05 | 0.5 | unknown |  | design value | allowance | not quoted
31 | J1001 | 1 | UNRESOLVED (harness family: JST-XH / Molex Micro-Fit, to agree with vehicle team) | DRIVER_CONTROLS | UNRESOLVED | UNASSIGNED (draft) | vehicle harness connector unknown | - | 0.5 | 3.0 | - | 0.5 | 3.0 | unknown |  | UNRESOLVED | allowance | not quoted
32 | J101 | 1 | UNRESOLVED (e.g. Amass XT90 PCB or screw terminal; rating pending) | BATTERY_IN | UNRESOLVED | UNASSIGNED (draft) | connector/cable from I_batt,max and V_bat,max (battery/BMS unknown) | hobby/distributor | 2.5 | 6.0 | - | 2.5 | 6.0 | unknown |  | UNRESOLVED | allowance | XT90 2 pairs $4.95 (BuddyRC, valid to 2026-09-10, snapshot)
33 | J1101 | 1 | UNRESOLVED (harness family: JST-XH / Molex Micro-Fit, to agree with vehicle team) | CAN | UNRESOLVED | UNASSIGNED (draft) | vehicle CAN harness connector, pinout and termination UNKNOWN (telematics proposal: CANH, CANL, GND) | - | 0.5 | 3.0 | - | 0.5 | 3.0 | unknown |  | UNRESOLVED | allowance | not quoted
34 | J301 | 1 | UNRESOLVED (e.g. Amass MR60 or 3x 4 mm bullet; rating pending) | MOTOR_PHASES | UNRESOLVED | UNASSIGNED (draft) | I_ph,max; motor connector unknown | hobby/distributor | 3.0 | 8.0 | - | 3.0 | 8.0 | unknown |  | UNRESOLVED | allowance | MR60 set $2.99 (RaceDayQuads snapshot)
35 | J701 | 1 | UNRESOLVED (harness family: JST-XH / Molex Micro-Fit, to agree with vehicle team) | MOTOR_TEMP | UNRESOLVED | UNASSIGNED (draft) | sensor type unknown (NTC/PTC/KTY/PT1000) | - | 0.5 | 3.0 | - | 0.5 | 3.0 | unknown |  | UNRESOLVED | allowance | not quoted
36 | J801 | 1 | 2x5 1.27 mm SMD header (e.g. FTSH-105-01) | SWD | 2x05 1.27mm | UNASSIGNED (draft) |  | - | 1.0 | 4.0 | - | 1.0 | 4.0 | unknown |  | bench only | allowance | not quoted
37 | J802 | 1 | UNRESOLVED (harness family: JST-XH / Molex Micro-Fit, to agree with vehicle team) | UART (bench) | UNRESOLVED | UNASSIGNED (draft) |  | - | 0.5 | 3.0 | - | 0.5 | 3.0 | unknown |  | bench only; not populated for competition | allowance | not quoted
38 | J901 | 1 | UNRESOLVED (harness family: JST-XH / Molex Micro-Fit, to agree with vehicle team) | HALL | UNRESOLVED | UNASSIGNED (draft) | motor hall connector unknown | - | 0.5 | 3.0 | - | 0.5 | 3.0 | unknown |  | UNRESOLVED | allowance | not quoted
39 | JP1101 JP1102 | 2 | solder jumper (copper) | TERM | pad | UNASSIGNED (draft) | close only if this node is a bus end (harness unknown) | n/a | 0.0 | 0.0 | - | 0.0 | 0.0 | n/a |  | UNRESOLVED | allowance | PCB copper
40 | JP901 | 1 | solder jumper (copper) | HALL SUPPLY 5V/3V3 | pad | UNASSIGNED (draft) | hall sensor supply voltage unknown | n/a | 0.0 | 0.0 | - | 0.0 | 0.0 | n/a |  | UNRESOLVED | allowance | PCB copper
41 | L1201 | 1 | UNRESOLVED buck inductor | UNRESOLVED inductor | SMD power inductor | UNASSIGNED (draft) | per DS design procedure for the V_IN range and 5 V load | - | 0.3 | 1.5 | - | 0.3 | 1.5 | unknown |  | UNRESOLVED | allowance | not quoted
42 | NT1201 | 1 | net tie (copper) | PGND-GND star | pad | UNASSIGNED (draft) |  | n/a | 0.0 | 0.0 | - | 0.0 | 0.0 | n/a |  | layout: single point at the shunt ground | allowance | PCB copper
43 | Q101 | 1 | UNRESOLVED P-FET (V_DS >= 1.25 V_bat,max, I_batt,max) | UNRESOLVED bypass P-FET | UNRESOLVED | UNASSIGNED (draft) | V_DS >= 1.25 x V_bat,max; continuous I_batt,max; SOA for closing after precharge | - | 2.0 | 6.0 | - | 2.0 | 6.0 | unknown |  | UNRESOLVED | allowance | not quoted
44 | Q102 | 1 | UNRESOLVED 100 V small-signal N-FET (e.g. BSS123 class) | UNRESOLVED small-signal N-FET | SOT-23 | UNASSIGNED (draft) | V_DS >= 1.25 x V_bat,max (drain sees the battery when off) | - | 0.1 | 0.5 | - | 0.1 | 0.5 | unknown |  | UNRESOLVED | allowance | not quoted
45 | Q301 | 1 | UNRESOLVED (representative: CSD19536KTT 100 V D2PAK) | UNRESOLVED N-MOSFET HS-A | D2PAK class (UNRESOLVED) | UNASSIGNED (draft) | V_DS >= 1.5 x V_bat,max; I_D, R_DS(on), Q_g, R_thJC from I_ph,max (motor unknown) | Mouser / Digi-Key | 5.27 | 7.85 | 2026-10-15 | 5.27 | 7.85 | stocked in snapshots | CSD19535KTT / BSC040N10NS5 (pending motor current) | UNRESOLVED | representative | CSD19536KTT: Mouser $5.27-5.74@1, Digi-Key $5.59-7.85@1 (snapshots)
46 | Q302 | 1 | UNRESOLVED (representative: CSD19536KTT 100 V D2PAK) | UNRESOLVED N-MOSFET LS-A | D2PAK class (UNRESOLVED) | UNASSIGNED (draft) | as HS | Mouser / Digi-Key | 5.27 | 7.85 | 2026-10-15 | 5.27 | 7.85 | stocked in snapshots | CSD19535KTT / BSC040N10NS5 (pending motor current) | UNRESOLVED | representative | CSD19536KTT: Mouser $5.27-5.74@1, Digi-Key $5.59-7.85@1 (snapshots)
47 | Q303 | 1 | UNRESOLVED (representative: CSD19536KTT 100 V D2PAK) | UNRESOLVED N-MOSFET HS-B | D2PAK class (UNRESOLVED) | UNASSIGNED (draft) | V_DS >= 1.5 x V_bat,max; I_D, R_DS(on), Q_g, R_thJC from I_ph,max (motor unknown) | Mouser / Digi-Key | 5.27 | 7.85 | 2026-10-15 | 5.27 | 7.85 | stocked in snapshots | CSD19535KTT / BSC040N10NS5 (pending motor current) | UNRESOLVED | representative | CSD19536KTT: Mouser $5.27-5.74@1, Digi-Key $5.59-7.85@1 (snapshots)
48 | Q304 | 1 | UNRESOLVED (representative: CSD19536KTT 100 V D2PAK) | UNRESOLVED N-MOSFET LS-B | D2PAK class (UNRESOLVED) | UNASSIGNED (draft) | as HS | Mouser / Digi-Key | 5.27 | 7.85 | 2026-10-15 | 5.27 | 7.85 | stocked in snapshots | CSD19535KTT / BSC040N10NS5 (pending motor current) | UNRESOLVED | representative | CSD19536KTT: Mouser $5.27-5.74@1, Digi-Key $5.59-7.85@1 (snapshots)
49 | Q305 | 1 | UNRESOLVED (representative: CSD19536KTT 100 V D2PAK) | UNRESOLVED N-MOSFET HS-C | D2PAK class (UNRESOLVED) | UNASSIGNED (draft) | V_DS >= 1.5 x V_bat,max; I_D, R_DS(on), Q_g, R_thJC from I_ph,max (motor unknown) | Mouser / Digi-Key | 5.27 | 7.85 | 2026-10-15 | 5.27 | 7.85 | stocked in snapshots | CSD19535KTT / BSC040N10NS5 (pending motor current) | UNRESOLVED | representative | CSD19536KTT: Mouser $5.27-5.74@1, Digi-Key $5.59-7.85@1 (snapshots)
50 | Q306 | 1 | UNRESOLVED (representative: CSD19536KTT 100 V D2PAK) | UNRESOLVED N-MOSFET LS-C | D2PAK class (UNRESOLVED) | UNASSIGNED (draft) | as HS | Mouser / Digi-Key | 5.27 | 7.85 | 2026-10-15 | 5.27 | 7.85 | stocked in snapshots | CSD19535KTT / BSC040N10NS5 (pending motor current) | UNRESOLVED | representative | CSD19536KTT: Mouser $5.27-5.74@1, Digi-Key $5.59-7.85@1 (snapshots)
51 | R1002 R1005 | 2 | generic 0603 (1 % R / X7R C) | 18k | 0603 | UNASSIGNED (draft) | 5 V -> 3.21 V | - | 0.01 | 0.1 | - | 0.1 | 1.0 | n/a |  | design value | allowance | not quoted (cut-tape strips of 10-25)
52 | R101 | 1 | UNRESOLVED (representative: WSK2512 1 mOhm 4-terminal) | UNRESOLVED bus shunt | 2512 4-terminal (UNRESOLVED value) | UNASSIGNED (draft) | I_batt,max into INA228 full-scale range; Kelvin sense pads | Digi-Key | 1.7 | 4.0 | 2026-10-15 | 1.7 | 4.0 | LEAD-TIME RISK: 38 weeks for the 1 mOhm Kelvin part (snapshot) | 2-terminal CSS2H-2512R-1L00F ($1.27@1, stocked) with Kelvin pads - accuracy trade-off | UNRESOLVED | representative | WSK2512R0250FEA 4-terminal $1.70@1 (DK snapshot); 1 mOhm WSK25121L000FEA listed without price, 38-week lead time
53 | R1019 | 1 | generic 0603 (1 % R / X7R C) | UNRESOLVED LED series | 0603 | UNASSIGNED (draft) | safety-loop voltage unknown (I_F ~ 5 mA) | - | 0.01 | 0.1 | - | 0.1 | 1.0 | n/a |  | UNRESOLVED | allowance | not quoted (cut-tape strips of 10-25)
54 | R102 | 1 | generic 0603 (1 % R / X7R C) | UNRESOLVED precharge R | 0603 | UNASSIGNED (draft) | C_link, V_bat,max, precharge time; pulse energy 0.5*C*V^2 per attempt | - | 0.01 | 0.1 | - | 0.1 | 1.0 | n/a |  | UNRESOLVED | allowance | not quoted (cut-tape strips of 10-25)
55 | R1003 R1006 R103 R105 R1206 R402 R403 | 7 | generic 0603 (1 % R / X7R C) | 100k | 0603 | UNASSIGNED (draft) | gate-source hold-off | - | 0.01 | 0.1 | - | 0.1 | 1.0 | n/a |  | design value | allowance | not quoted (cut-tape strips of 10-25)
56 | R104 | 1 | generic 0603 (1 % R / X7R C) | 47k | 0603 | UNASSIGNED (draft) | zener current (V_bat,max-12V)/R; power (V_bat,max-12V)^2/R | - | 0.01 | 0.1 | - | 0.1 | 1.0 | n/a |  | design value - verify | allowance | not quoted (cut-tape strips of 10-25)
57 | R1102 R1103 | 2 | generic 0603 (1 % R / X7R C) | 60.4R | 0603 | UNASSIGNED (draft) |  | - | 0.01 | 0.1 | - | 0.1 | 1.0 | n/a |  | design value | allowance | not quoted (cut-tape strips of 10-25)
58 | R1201 | 1 | generic 0603 (1 % R / X7R C) | UNRESOLVED UVLO top | 0603 | UNASSIGNED (draft) | from V_bat,min | - | 0.01 | 0.1 | - | 0.1 | 1.0 | n/a |  | UNRESOLVED | allowance | not quoted (cut-tape strips of 10-25)
59 | R1202 | 1 | generic 0603 (1 % R / X7R C) | UNRESOLVED UVLO bottom | 0603 | UNASSIGNED (draft) |  | - | 0.01 | 0.1 | - | 0.1 | 1.0 | n/a |  | UNRESOLVED | allowance | not quoted (cut-tape strips of 10-25)
60 | R1203 | 1 | generic 0603 (1 % R / X7R C) | UNRESOLVED RON | 0603 | UNASSIGNED (draft) | on-time vs V_IN range (battery unknown) | - | 0.01 | 0.1 | - | 0.1 | 1.0 | n/a |  | UNRESOLVED | allowance | not quoted (cut-tape strips of 10-25)
61 | R1204 | 1 | generic 0603 (1 % R / X7R C) | 31.6k (verify VFB) | 0603 | UNASSIGNED (draft) |  | - | 0.01 | 0.1 | - | 0.1 | 1.0 | n/a |  | TYPICAL - verify | allowance | not quoted (cut-tape strips of 10-25)
62 | R201 | 1 | generic 0603 (1 % R / X7R C) | UNRESOLVED bleeder | 0603 | UNASSIGNED (draft) | discharge time vs power at V_bat,max | - | 0.01 | 0.1 | - | 0.1 | 1.0 | n/a |  | UNRESOLVED | allowance | not quoted (cut-tape strips of 10-25)
63 | R202 | 1 | generic 0603 (1 % R / X7R C) | UNRESOLVED divider top | 0603 | UNASSIGNED (draft) | ratio = 2.495 V / V_OV,trip (rule 37: FS >= 1.05 OV) | - | 0.01 | 0.1 | - | 0.1 | 1.0 | n/a |  | UNRESOLVED | allowance | not quoted (cut-tape strips of 10-25)
64 | R203 | 1 | generic 0603 (1 % R / X7R C) | UNRESOLVED divider bottom | 0603 | UNASSIGNED (draft) | see top | - | 0.01 | 0.1 | - | 0.1 | 1.0 | n/a |  | UNRESOLVED | allowance | not quoted (cut-tape strips of 10-25)
65 | R1008 R1010 R1012 R1014 R1016 R1018 R204 R207 R702 R704 R802 R803 R902 R904 R906 | 15 | generic 0603 (1 % R / X7R C) | 1k | 0603 | UNASSIGNED (draft) | ADC input isolation | - | 0.01 | 0.1 | - | 0.15 | 1.5 | n/a |  | design value | allowance | not quoted (cut-tape strips of 10-25)
66 | R205 | 1 | generic 0603 (1 % R / X7R C) | UNRESOLVED hysteresis | 0603 | UNASSIGNED (draft) |  | - | 0.01 | 0.1 | - | 0.1 | 1.0 | n/a |  | UNRESOLVED | allowance | not quoted (cut-tape strips of 10-25)
67 | R1001 R1004 R1007 R1009 R1011 R1013 R1015 R1017 R1020 R1101 R1205 R206 R401 R404 R605 R701 R801 R804 | 18 | generic 0603 (1 % R / X7R C) | 10k | 0603 | UNASSIGNED (draft) |  | - | 0.01 | 0.1 | - | 0.18 | 1.8 | n/a |  | design value | allowance | not quoted (cut-tape strips of 10-25)
68 | R301 R302 R304 R305 R307 R308 R805 | 7 | generic 0603 (1 % R / X7R C) | 0R | 0603 | UNASSIGNED (draft) | series gate R option; IDRIVE sets slew | - | 0.01 | 0.1 | - | 0.1 | 1.0 | n/a |  | design option | allowance | not quoted (cut-tape strips of 10-25)
69 | R303 | 1 | UNRESOLVED (representative: WSK2512 1 mOhm 4-terminal) | UNRESOLVED phase shunt A | 2512 4-terminal (UNRESOLVED value) | UNASSIGNED (draft) | I_ph,max into CSA linear range; P = I_rms^2 R; Kelvin pads | Digi-Key | 1.7 | 4.0 | 2026-10-15 | 1.7 | 4.0 | LEAD-TIME RISK: 38 weeks for the 1 mOhm Kelvin part (snapshot) | 2-terminal CSS2H-2512R-1L00F ($1.27@1, stocked) with Kelvin pads - accuracy trade-off | UNRESOLVED | representative | WSK2512R0250FEA 4-terminal $1.70@1 (DK snapshot); 1 mOhm WSK25121L000FEA listed without price, 38-week lead time
70 | R306 | 1 | UNRESOLVED (representative: WSK2512 1 mOhm 4-terminal) | UNRESOLVED phase shunt B | 2512 4-terminal (UNRESOLVED value) | UNASSIGNED (draft) | I_ph,max into CSA linear range; P = I_rms^2 R; Kelvin pads | Digi-Key | 1.7 | 4.0 | 2026-10-15 | 1.7 | 4.0 | LEAD-TIME RISK: 38 weeks for the 1 mOhm Kelvin part (snapshot) | 2-terminal CSS2H-2512R-1L00F ($1.27@1, stocked) with Kelvin pads - accuracy trade-off | UNRESOLVED | representative | WSK2512R0250FEA 4-terminal $1.70@1 (DK snapshot); 1 mOhm WSK25121L000FEA listed without price, 38-week lead time
71 | R309 | 1 | UNRESOLVED (representative: WSK2512 1 mOhm 4-terminal) | UNRESOLVED phase shunt C | 2512 4-terminal (UNRESOLVED value) | UNASSIGNED (draft) | I_ph,max into CSA linear range; P = I_rms^2 R; Kelvin pads | Digi-Key | 1.7 | 4.0 | 2026-10-15 | 1.7 | 4.0 | LEAD-TIME RISK: 38 weeks for the 1 mOhm Kelvin part (snapshot) | 2-terminal CSS2H-2512R-1L00F ($1.27@1, stocked) with Kelvin pads - accuracy trade-off | UNRESOLVED | representative | WSK2512R0250FEA 4-terminal $1.70@1 (DK snapshot); 1 mOhm WSK25121L000FEA listed without price, 38-week lead time
72 | R405 R406 R407 R408 R409 R410 | 0 | generic 0603 (1 % R / X7R C) | 100k | 0603 | UNASSIGNED (draft) |  | - | 0.01 | 0.1 | - | 0.0 | 0.0 | n/a |  | DNP if internal pull-downs verified | allowance | not quoted (cut-tape strips of 10-25)
73 | R501 R502 R503 | 3 | generic 0603 (1 % R / X7R C) | 100R | 0603 | UNASSIGNED (draft) | with 470 pF: tau = 47 ns (settling inside the PWM sampling window) | - | 0.01 | 0.1 | - | 0.1 | 1.0 | n/a |  | design value - see timing budget | allowance | not quoted (cut-tape strips of 10-25)
74 | R601 R602 | 2 | generic 0603 (1 % R / X7R C) | 10R (verify) | 0603 | UNASSIGNED (draft) |  | - | 0.01 | 0.1 | - | 0.1 | 1.0 | n/a |  | TYPICAL - verify input-filter guidance | allowance | not quoted (cut-tape strips of 10-25)
75 | R603 R604 R901 R903 R905 | 5 | generic 0603 (1 % R / X7R C) | 4.7k | 0603 | UNASSIGNED (draft) |  | - | 0.01 | 0.1 | - | 0.1 | 1.0 | n/a |  | design value | allowance | not quoted (cut-tape strips of 10-25)
76 | R703 | 1 | generic 0603 (1 % R / X7R C) | UNRESOLVED bias | 0603 | UNASSIGNED (draft) | depends on the motor's sensor | - | 0.01 | 0.1 | - | 0.1 | 1.0 | n/a |  | UNRESOLVED | allowance | not quoted (cut-tape strips of 10-25)
77 | SW801 | 1 | generic (0603 LED / 0603 bead / SOD-123 zener / SMD tact) | RESET | 0603/SOD-123/SMD | UNASSIGNED (draft) |  | - | 0.05 | 0.5 | - | 0.05 | 0.5 | unknown |  | bench | allowance | not quoted
78 | TH701 | 1 | 10k NTC 0603 (B to select) | 10k NTC (B per selection) | 0603 | UNASSIGNED (draft) | placed at the low-side MOSFETs | - | 0.05 | 0.4 | - | 0.05 | 0.4 | unknown |  | CANDIDATE | allowance | not quoted
79 | TP1201 | 1 | test pad or loop | +5V | pad | UNASSIGNED (draft) |  | - | 0.0 | 0.3 | - | 0.0 | 0.3 | n/a |  | bench test point | allowance | pad = free
80 | TP1202 | 1 | test pad or loop | GND | pad | UNASSIGNED (draft) |  | - | 0.0 | 0.3 | - | 0.0 | 0.3 | n/a |  | bench test point | allowance | pad = free
81 | TP1203 | 1 | test pad or loop | BUCK_PG | pad | UNASSIGNED (draft) |  | - | 0.0 | 0.3 | - | 0.0 | 0.3 | n/a |  | bench test point | allowance | pad = free
82 | TP501 | 1 | test pad or loop | ISENSE_A | pad | UNASSIGNED (draft) |  | - | 0.0 | 0.3 | - | 0.0 | 0.3 | n/a |  | bench test point | allowance | pad = free
83 | TP502 | 1 | test pad or loop | ISENSE_B | pad | UNASSIGNED (draft) |  | - | 0.0 | 0.3 | - | 0.0 | 0.3 | n/a |  | bench test point | allowance | pad = free
84 | TP503 | 1 | test pad or loop | ISENSE_C | pad | UNASSIGNED (draft) |  | - | 0.0 | 0.3 | - | 0.0 | 0.3 | n/a |  | bench test point | allowance | pad = free
85 | TP801 | 1 | test pad or loop | +3V3 | pad | UNASSIGNED (draft) |  | - | 0.0 | 0.3 | - | 0.0 | 0.3 | n/a |  | bench test point | allowance | pad = free
86 | TP802 | 1 | test pad or loop | NRST | pad | UNASSIGNED (draft) |  | - | 0.0 | 0.3 | - | 0.0 | 0.3 | n/a |  | bench test point | allowance | pad = free
87 | TP803 | 1 | test pad or loop | DRV_NFAULT | pad | UNASSIGNED (draft) |  | - | 0.0 | 0.3 | - | 0.0 | 0.3 | n/a |  | bench test point | allowance | pad = free
88 | U1001 | 1 | PC817X2NSZ9F (or equivalent) | PC817 (safety-loop sense) | DIP-4/SMD-4 | UNASSIGNED (draft) |  | - | 0.2 | 0.6 | - | 0.2 | 0.6 | unknown | EL817 | CANDIDATE | allowance | not quoted
89 | U101 | 1 | UNRESOLVED (ideal-diode controller + N-FETs, or none) | UNRESOLVED reverse-polarity protection | UNRESOLVED | UNASSIGNED (draft) | ideal-diode controller + N-FETs, or keyed harness only: harness decision pending | - | 0.0 | 10.0 | - | 0.0 | 10.0 | unknown |  | UNRESOLVED | allowance | not quoted; 0 if harness keying is chosen
90 | U1101 | 1 | TJA1051T/3/1J | TJA1051T/3 | SO-8 | UNASSIGNED (draft) |  | Digi-Key / Mouser | 1.43 | 1.63 | 2026-10-15 | 1.43 | 1.63 | listed | TCAN1042VDRQ1 (pin-compatible class - verify) | CANDIDATE (alternate TCAN1042V, pin-compatible class - verify) | snippet | Digi-Key $1.43@1; Mouser 771-TJA1051T/3/1J $1.44-1.63@1 (snapshots)
91 | U1201 | 1 | LM5164DDAR | LM5164 (candidate) | SO-8 PowerPAD (DDA) | UNASSIGNED (draft) |  | Digi-Key / Mouser | 1.96 | 4.19 | 2026-10-15 | 1.96 | 4.19 | LM5164QDDARQ1 out of stock, 16-week lead time (DK snapshot) | LM5164QDDARQ1 (automotive) | CANDIDATE (100 V input class - verify) | snippet | Digi-Key LM5164DDAR $4.19 (in-stock substitute); Mouser LM5164DDAR $1.955@1 via aggregator
92 | U1202 | 1 | TLV75533PDBVR | TLV75533 | SOT-23-5 | UNASSIGNED (draft) |  | - | 0.15 | 0.6 | - | 0.15 | 0.6 | unknown | TLV75733P | CANDIDATE | allowance | not quoted
93 | U201 | 1 | TLV7041DBVR | TLV7041DBV | SOT-23-5 | UNASSIGNED (draft) | open-drain: wired-OR into TIM1_BKIN2 | - | 0.4 | 1.0 | - | 0.4 | 1.0 | unknown | TLV3691 | CANDIDATE | allowance | not quoted
94 | U202 | 1 | TL431BIDBZR | TL431 (2.495 V) | SOT-23-3 | UNASSIGNED (draft) |  | - | 0.1 | 0.5 | - | 0.1 | 0.5 | unknown | LM4041 | CANDIDATE | allowance | not quoted
95 | U401 | 1 | DRV8353SRTAR | DRV8353S (candidate) | WQFN-40 (RTA) | UNASSIGNED (draft) |  | Mouser | 4.98 | 5.66 | 2026-10-15 | 4.98 | 5.66 | Digi-Key out of stock, 6-week standard lead time (snapshot); Mouser stocked | DRV8353SRTAT (250-pc reel, DK stocked $5.00@1) or DRV8353RS (integrated buck, 48-pin) | CANDIDATE (SPI, integrated CSAs, VDS monitors) | snippet | Mouser 595-DRV8353SRTAR cut tape $4.98@1, 595 in stock (snapshot); Octopart/Mouser $5.66@1 | UNVERIFIED (pinout not checked against a primary datasheet)
96 | U402 | 1 | SN74LVC1G08DBVR | 74LVC1G08 | SOT-23-5 | UNASSIGNED (draft) |  | - | 0.1 | 0.5 | - | 0.1 | 0.5 | unknown | 74AHC1G08 | CANDIDATE | allowance | not quoted
97 | U601 | 1 | INA228AIDGSR | INA228 (candidate) | VSSOP-10 (DGS) | UNASSIGNED (draft) |  | Digi-Key | 4.21 | 6.05 | 2026-10-15 | 4.21 | 6.05 | US stock risk (snapshot); UK/AU stocked | INA229 (SPI) or INA238 (16-bit) - verify footprint | CANDIDATE (85 V common mode, 20-bit) | snippet | Digi-Key US $5.31@1 (0 stock, 1,703 expected 04-Jan-2027); DK UK GBP 3.32@1 in stock; LCSC ~$6.05@100 | SECONDARY: numbers match the KiCad official library (INA226-derived VSSOP-10) @cf07d539; primary TI datasheet NOT read
98 | U801 | 1 | STM32G474VET6 | STM32G474VET6 | LQFP-100 14x14 | UNASSIGNED (draft) |  | Mouser / Digi-Key | 11.62 | 12.13 | 2026-10-15 | 11.62 | 12.13 | listed; DK TR variant showed backorder in one snapshot | STM32G474VCT6 (256 kB flash, same pinout) | CANDIDATE (pin map generated) | snippet | Mouser 511-STM32G474VET6 cached $11.62@1; Digi-Key cached $12.13@1 (search 2026-10-15) | KiCad library symbol (pin map from ST open pin data @7d1f151)
99 | U802 | 1 | MAX6369KA+T | MAX6369 (candidate) | SOT-23-8 | UNASSIGNED (draft) |  | - | 2.0 | 5.0 | - | 2.0 | 5.0 | unknown | TPS3431 / STWD100 (pin-incompatible) | CANDIDATE - SET0..2 strap per timeout table (verify) | allowance | not quoted
100 | Y801 | 1 | HSE crystal, frequency UNSELECTED (8-40 MHz class, 3225; CL/tolerance to select) | HSE UNSELECTED | 3225 | UNASSIGNED (draft) | frequency NOT selected: depends on the vehicle bus (classic or FD, bit rates) and the CPU frequency; candidates 8-40 MHz in hardware/timing/clock_tree_alternatives.md. The v0.2 '40 MHz required' claim is withdrawn. | - | 0.3 | 1.0 | - | 0.3 | 1.0 | unknown |  | UNRESOLVED | allowance | not quoted
