SWORT-Aerospace/sem-motor-controller/hardware/bom/BOM_candidates.csv

subsystem | reference | quantity | manufacturer | exact_MPN_if_verified | function | package | operating_limits | datasheet_URL | revision | selection_status | blocker | alternate | unit_cost | currency | quantity_break | supplier | stock_checked_at | notes
MCU | U1 | 1 | STMicroelectronics | null | Cortex-M4F 170 MHz controller: TIM1 6-PWM + break, 5 ADC, FDCAN, CORDIC | LQFP100 (STM32G474V*T6 family) | 1.71-3.6 V; -40..85 or 125 degC by suffix (UNVERIFIED snippet) | https://www.st.com/en/microcontrollers-microprocessors/stm32g474ve.html | DS12288 Rev 6 2021-11 (snippet; not fetched); errata ES0430 Rev 9 (snippet) | CANDIDATE - pin/resource feasible | st.com unreachable: datasheet, errata and AF tables not reviewed; temperature-grade suffix undecided | STM32G474RET6 (LQFP64: feasible with 0 spare I/O) | null | null | null | null | null | Pin allocation checked against STM32_open_pin_data 7d1f151 (BSD-3); see docs/generated/pin_allocation.md
MCU | U1-alt | 0 | STMicroelectronics | null | STSPIN32G4 (G431 + gate driver) evaluated once - NOT selected | VFQFPN-64 9x9 (snippet) | VM 5.5-75 V; 1 A gate drive (snippet) | https://www.st.com/en/motor-drivers/stspin32g4.html | DS13630 (snippet) | REJECTED for baseline (ADR-0002) | single FDCAN; fewer ADC/IO; 1 A gate drive limits paralleling; integrated driver couples MCU and power-stage failures | STM32G474 + external driver | null | null | null | null | null | Keep as fallback for a compact single-board revision
GATE_DRIVER | U2 | 1 | Texas Instruments | null | 3-phase smart gate driver, SPI, 3 integrated CSAs, VDS OC monitor | VQFN-48 7x7 (DRV8353RS) or WQFN-40 (DRV8353S) (snippet) | VM 9-75 V operating, 80 V abs max; VDRAIN up to 100 V, 102 V abs max (snippet). 100 V driver rating does NOT make a 100 V bus safe | https://www.ti.com/product/DRV8353 | SLVSDY6A (snippet; later revision may exist) | CANDIDATE - family only | exact order code (S vs RS; H variants excluded - need SPI) UNFROZEN; ti.com unreachable; CSA bandwidth 1 MHz on R variants (snippet) vs settling budget | DRV8350S/RS (lower VDRAIN rating) or discrete driver + INA241 | null | null | null | null | null | Use SPI variant for fault readback and configurable dead time / IDRIVE
POWER_STAGE | Q1-Q6 | 6 | UNSELECTED | null | Half-bridge MOSFETs (one per switch position initially) | TBD (D2PAK / SON5x6 / SuperSO8 candidates) | VDS >= V_design (see calcs) with derating; RDS(on), Qg trade depends on drive cycle | https://www.ti.com/product/CSD19535KTT ; https://www.ti.com/product/CSD19532Q5B ; https://www.infineon.com/BSC040N10NS5 (product pages; not fetched) | snippet values only | UNFROZEN | max pack voltage, measured overshoot, drive-cycle current distribution and thermal path all unknown | CSD19536KTT / CSD19535KTT / CSD19532Q5B / BSC040N10NS5 (all snippet-level) | null | null | null | null | null | Parallel devices only if peak-current thermal analysis requires it (calcs show light-load penalty)
SENSING | R1-R3 | 3 | UNSELECTED | null | Low-side phase-current shunts | 2512 or 2725 metal element | value 0.5-2 mOhm (UNFROZEN); pulse rating vs peak current | null | null | UNFROZEN | peak phase current, CSA offset/drift, cruise current resolution | null | null | null | null | null | null | Offset at 3 mV / 1 mOhm = 3 A: per-board zero-current calibration mandatory
SENSING | U3 | 1 | Texas Instruments | null | Independent DC-bus energy/charge monitor, 20-bit, I2C | VSSOP-10 (snippet) | common mode -0.3..85 V; 40-bit ENERGY/CHARGE accumulators; offset +/-1 uV max; gain err 0.05 % (snippet) | https://www.ti.com/product/INA228 | Rev A 2022-05 (snippet) | CANDIDATE | ti.com unreachable; DC shunt value and placement relative to the SEM joulemeter unresolved | INA229 (SPI variant) | null | null | null | null | null | Used for energy accounting and calibration against the official joulemeter; never the phase shunts
SENSING | R4 | 1 | UNSELECTED | null | DC-bus shunt for U3 | 2725 / 4-terminal | value from max battery current and 81.92/163.84 mV ranges (snippet) | null | null | UNFROZEN | BMS discharge limit unknown | null | null | null | null | null | null | 4-terminal Kelvin layout
COMMS | U4 | 1 | Texas Instruments | null | CAN FD transceiver, +/-70 V bus fault protection, VIO | SOIC-8 or VSON-8 (snippet) | H: +/-70 V fault; G: 5 Mbps FD; V: VIO pin (snippet) | https://www.ti.com/product/TCAN1042HGV | SLLSES7D 2021-10 (snippet) | CANDIDATE | ti.com unreachable; automotive -Q1 orderable reported obsolete (snippet) | TCAN1044AV / TCAN1462 | null | null | null | null | null | Bus at 500 kbit/s nominal; FD tolerant to coexist with CHUDS CAN-FD nodes
ROTOR_SENSOR | J-HALL+U5 | 1 | UNSELECTED | null | Protected hall inputs: pull-ups, RC filter, TVS/clamp, Schmitt buffer | SOT-23 / SC-70 | hall supply and output type (open drain vs push-pull) UNKNOWN | null | null | BLOCKED | motor and hall sensor type unknown | encoder interface if motor uses one | null | null | null | null | null | Disconnected harness must read an illegal code (111) - verified behaviour in tests
THERMAL | RT1-RT2 | 2 | UNSELECTED | null | NTC for power stage + motor winding sensor input | 0603 NTC / connector | motor sensor type unknown (NTC/PTC/KTY) | null | null | BLOCKED | motor winding sensor unknown | null | null | null | null | null | null | Missing temperature => bounded derate (implemented), not silent
SUPERVISION | U6 | 1 | UNSELECTED | null | External windowed watchdog driving output-enable/gate-driver ENABLE | SOT-23 | timeout window to be set from task timing measurements | null | null | PROPOSED | window timing needs target timing measurement | internal IWDG only (insufficient as sole protection) | null | null | null | null | null | Independent of firmware: disables gate driver on missed kicks (boundary E)
SUPERVISION | U7 | 1 | UNSELECTED | null | Independent overcurrent comparator into TIM1_BKIN and driver ENABLE latch | SOT-23-5 | threshold from hw_overcurrent_trip_A | null | null | PROPOSED | shunt/CSA selection | G474 internal COMP -> BKIN (silicon-independent of software timing but not of MCU configuration) | null | null | null | null | null | Combined with DRV8353 VDS monitoring
POWER | U8 | 1 | UNSELECTED | null | Logic supply buck from pack (wide input) to 12 V / 5 V | TBD | input >= V_design; quiescent current matters (always on during run) | null | null | UNFROZEN | pack voltage unknown; DRV8353RS internal buck (350 mA, snippet) may suffice | DRV8353RS integrated buck | null | null | null | null | null | Quiescent and conversion loss count against run energy (joulemeter, unverified rule)
POWER | U9 | 1 | UNSELECTED | null | 3.3 V LDO/buck for MCU, analog reference | SOT-23-5 | low noise for ADC reference | null | null | UNFROZEN | null | null | null | null | null | null | null | null
DC_LINK | C1-Cn | n | UNSELECTED | null | DC-link capacitance (polymer/ceramic/electrolytic mix) | TBD | voltage derated to <= 80 % of rating; ripple per calcs | null | null | UNFROZEN | drive-cycle RMS current, layout inductance, battery/cable impedance; any capacitor-energy rule (unverified) | null | null | null | null | null | null | Bleeder/active discharge after isolation required
INPUT | F1 | 1 | UNSELECTED | null | Main fuse (rules: on positive conductor near battery - UNVERIFIED Art. 57e) | TBD | rating vs wire ampacity and battery short-circuit current | null | null | BLOCKED | BMS limits, battery short-circuit current, cable | null | null | null | null | null | null | Fuse belongs to the vehicle battery system; controller has its own protection only
INPUT | K1+R5 | 1 | UNSELECTED | null | Precharge resistor (+ relay/contact sequence if the isolation topology needs it) | TBD | pulse energy = 0.5 C V^2 per enable | null | null | UNFROZEN | isolation relay topology from rules (unverified); DC-link C | NTC inrush limiter (not preferred: hot-restart) | null | null | null | null | null | null
INPUT | D1 | 1 | UNSELECTED | null | Bus transient suppression / reverse-polarity strategy | TBD | clamp below MOSFET V_DS rating at max fault current | null | null | UNFROZEN | measured transients | null | null | null | null | null | null | null
CONNECTORS | J1-J6 | 6 | UNSELECTED | null | Battery in, motor phases, hall/temperature, CAN, driver controls, debug | TBD | current rating vs fuse; locking; vibration | null | null | BLOCKED | harness and enclosure constraints unknown | null | null | null | null | null | null | Driver controls (throttle, brake, arm, mode, cancel, e-stop sense, dead-man) are wired, not CAN
ENCLOSURE | X1 | 1 | UNSELECTED | null | Enclosure + thermal interface (pad/heatsink) | TBD | ambient and airflow unknown | null | null | BLOCKED | vehicle packaging and cooling unknown | null | null | null | null | null | null | Rules mark: etch 'SEM' on PCB (UNVERIFIED tip page)
