SWORT-Aerospace/sem-motor-controller/docs/generated/csia_evaluation_synthetic.md

# CSIA held-out evaluation and ablation - SYNTHETIC

> Synthetic sensors, synthetic faults, shadow mode. **Not vehicle evidence.** Generated by `tools/run_csia_evaluation.py`; protocol in `docs/csia/EVALUATION_PROTOCOL.md`. The adapter, the development generator, the baselines and this harness were frozen before the evaluation set was run (`docs/csia/DEV_SET_FREEZE.json`).

Held-out set: 94 scenarios (24 fault-free, 70 with one fault each), 5.80 h of operation outside fault windows (2.00 h in fault-free scenarios). Unseen seeds; randomised pulse bands, standing starts after stops, long coasts, hills of ±2.5 %, corners, GNSS degradation and outages; faults with random onset, duration and magnitude, including drifts, dropouts and kinds absent from the development set.

## Calibration (development nominal run only)

| monitor | residual threshold λ | alarm ticks on dev nominal at that λ |
|---|---|---|
| V0 | 900 | 505 |
| V1 | 36 | 0 |
| V2 | 900 | 503 |
| V3 | 9 | 0 |
| V3v | 9 | 0 |
| CSIA (frozen, λ_fail 9) | — | 0 |

TRUST thresholds (dev-nominal minimum − 0.02): rotor 0.828, wheel_drive 0.828, wheel_l 0.872, wheel_r 0.800, gnss 0.821, imu 0.939, phase_current 0.964, dc_meter 0.964

## Summary

| monitor | what it is | false-alarm episodes / h (all) | false attributions / h | missed / faults | correctly attributed | misattributed | detection latency median / p90 s | latency after evidence became eligible, median / p90 s | median ambiguous fraction |
|---|---|---|---|---|---|---|---|---|---|
| B1 | range / NaN / freshness | 144.16 (836 episodes) | 144.16 | 63 / 70 | 7 | 17 | 0.1 / 59.7 | 0.1 / 56.9 | 0.00 |
| V0 | naive residuals, no gates | 380.42 (2206 episodes) | 0.00 | 45 / 70 | 0 | 0 | 1.5 / 39.6 | 1.4 / 40.0 | 1.00 |
| V1 | naive residuals + gates | 7.24 (42 episodes) | 0.00 | 22 / 70 | 0 | 0 | 7.4 / 34.6 | 1.1 / 28.8 | 1.00 |
| V2 | calibrated residuals, no gates | 379.73 (2202 episodes) | 0.00 | 45 / 70 | 0 | 0 | 5.9 / 39.6 | 9.5 / 40.1 | 1.00 |
| V3 | calibrated residuals + gates (alarms only) | 0.00 (0 observed; 95 % upper 0.52) | 0.00 | 18 / 70 | 0 | 0 | 6.0 / 23.3 | 0.5 / 19.4 | 1.00 |
| V3v | V3 + majority-vote attribution | 0.00 (0 observed; 95 % upper 0.52) | 0.00 | 18 / 70 | 35 | 0 | 6.0 / 23.3 | 0.5 / 19.4 | 0.08 |
| CSIA | frozen adapter (V3 + corroboration attribution) | 19.66 (114 episodes) | 2.41 | 16 / 70 | 48 | 9 | 4.2 / 21.9 | 0.3 / 14.6 | 0.02 |
| TRUST | TrustCore belief threshold | 73.46 (426 episodes) | 96.74 | 15 / 70 | 39 | 17 | 5.3 / 16.6 | 4.5 / 11.0 | 0.90 |
| B1+CSIA | B1 freshness/range + CSIA | 163.82 (950 episodes) | 146.58 | 11 / 70 | 53 | 23 | 1.0 / 21.9 | 0.2 / 14.6 | 0.02 |

False-alarm episodes by implicated nodes (top 6):

* B1: `gnss` 836
* V0: `rotor,wheel_drive` 2206
* V1: `imu,wheel_l` 41, `dc_meter,phase_current` 1
* V2: `rotor,wheel_drive` 2202
* V3: none
* V3v: none
* CSIA: `dc_meter,phase_current` 53, `gnss,wheel_r` 16, `gnss,wheel_drive` 14, `gnss` 14, `gnss,wheel_l` 11, `rotor,wheel_drive` 3
* TRUST: `dc_meter,gnss,imu,phase_current,rotor,wheel_drive,wheel_l` 94, `gnss` 64, `wheel_r` 58, `wheel_l,wheel_r` 50, `rotor,wheel_drive` 32, `wheel_l` 19
* B1+CSIA: `gnss` 850, `dc_meter,phase_current` 53, `gnss,wheel_r` 16, `gnss,wheel_drive` 14, `gnss,wheel_l` 11, `rotor,wheel_drive` 3

Definitions: an alarm is any reported problem (attributed or ambiguous). A false alarm is an alarm episode outside a fault window [onset, end + 5 s]. Detection = an alarm implicating the faulty node inside the window. Attribution = that node named alone as the suspect. Misattribution = any other node named as suspect inside the window. Eligible = at least one relationship involving the faulty node passes the frozen adapter's regime gates with fresh inputs. Unobservable = time inside the fault with no eligible relationship for that node, during which no relationship-based method can see the fault.

## Per fault kind (CSIA adapter; detections by every monitor in the last column)

| fault kind | n | CSIA detected / attributed / misattributed | CSIA wrong nodes | median latency s | median first eligible s | median unobservable fraction | never eligible | detected by B1 / V0 / V3 / V3v / TRUST / B1+CSIA |
|---|---|---|---|---|---|---|---|---|
| wheel_l_dropout | 5 | 5 / 5 / 0 | — | 0.2 | 0.1 | 0.00 | 0 | 0 / 5 / 5 / 5 / 5 / 5 |
| wheel_r_dropout | 5 | 5 / 5 / 0 | — | 0.1 | 0.0 | 0.00 | 0 | 0 / 2 / 5 / 5 / 5 / 5 |
| wheel_l_intermittent | 5 | 5 / 5 / 3 | imu | 0.3 | 0.1 | 0.00 | 0 | 0 / 5 / 5 / 5 / 5 / 5 |
| rotor_stuck | 5 | 5 / 3 / 0 | — | 22.9 | 22.9 | 0.65 | 0 | 0 / 4 / 5 / 5 / 5 / 5 |
| rotor_scale | 5 | 0 / 0 / 0 | — | — | 31.2 | 1.00 | 3 | 0 / 4 / 0 / 0 / 0 / 0 |
| rotor_dropout | 5 | 0 / 0 / 0 | — | — | 0.0 | 1.00 | 3 | 5 / 4 / 0 / 0 / 0 / 5 |
| gnss_offset | 5 | 5 / 5 / 1 | wheel_drive | 0.1 | 0.0 | 0.00 | 0 | 0 / 0 / 5 / 5 / 5 / 5 |
| gnss_drift | 5 | 5 / 5 / 0 | — | 7.2 | 0.1 | 0.12 | 0 | 2 / 0 / 5 / 5 / 5 / 5 |
| imu_bias | 5 | 5 / 3 / 0 | — | 1.6 | 0.1 | 0.00 | 0 | 0 / 0 / 4 / 4 / 5 / 5 |
| imu_drift | 5 | 5 / 4 / 0 | — | 14.6 | 0.0 | 0.00 | 0 | 0 / 0 / 4 / 4 / 5 / 5 |
| current_bias | 5 | 5 / 5 / 1 | gnss | 0.1 | 0.0 | 0.00 | 0 | 0 / 0 / 5 / 5 / 5 / 5 |
| current_drift | 5 | 5 / 5 / 4 | rotor | 4.9 | 0.1 | 0.00 | 0 | 0 / 1 / 5 / 5 / 5 / 5 |
| dc_gain | 5 | 1 / 1 / 0 | — | 8.6 | 0.1 | 0.00 | 0 | 0 / 0 / 1 / 1 / 2 / 1 |
| dc_drift | 5 | 3 / 2 / 0 | — | 21.9 | 0.0 | 0.00 | 0 | 0 / 0 / 3 / 3 / 3 / 3 |

Runtime 275.4 s on this host. SYNTHETIC; the vehicle-validation gate (VALIDATION_PLAN.md §6) still requires ≥ 10 h of in-vehicle shadow data.
