SWORT-Aerospace/sem-motor-controller/hardware/kicad/semmc_schematic_DRAFT.pdf

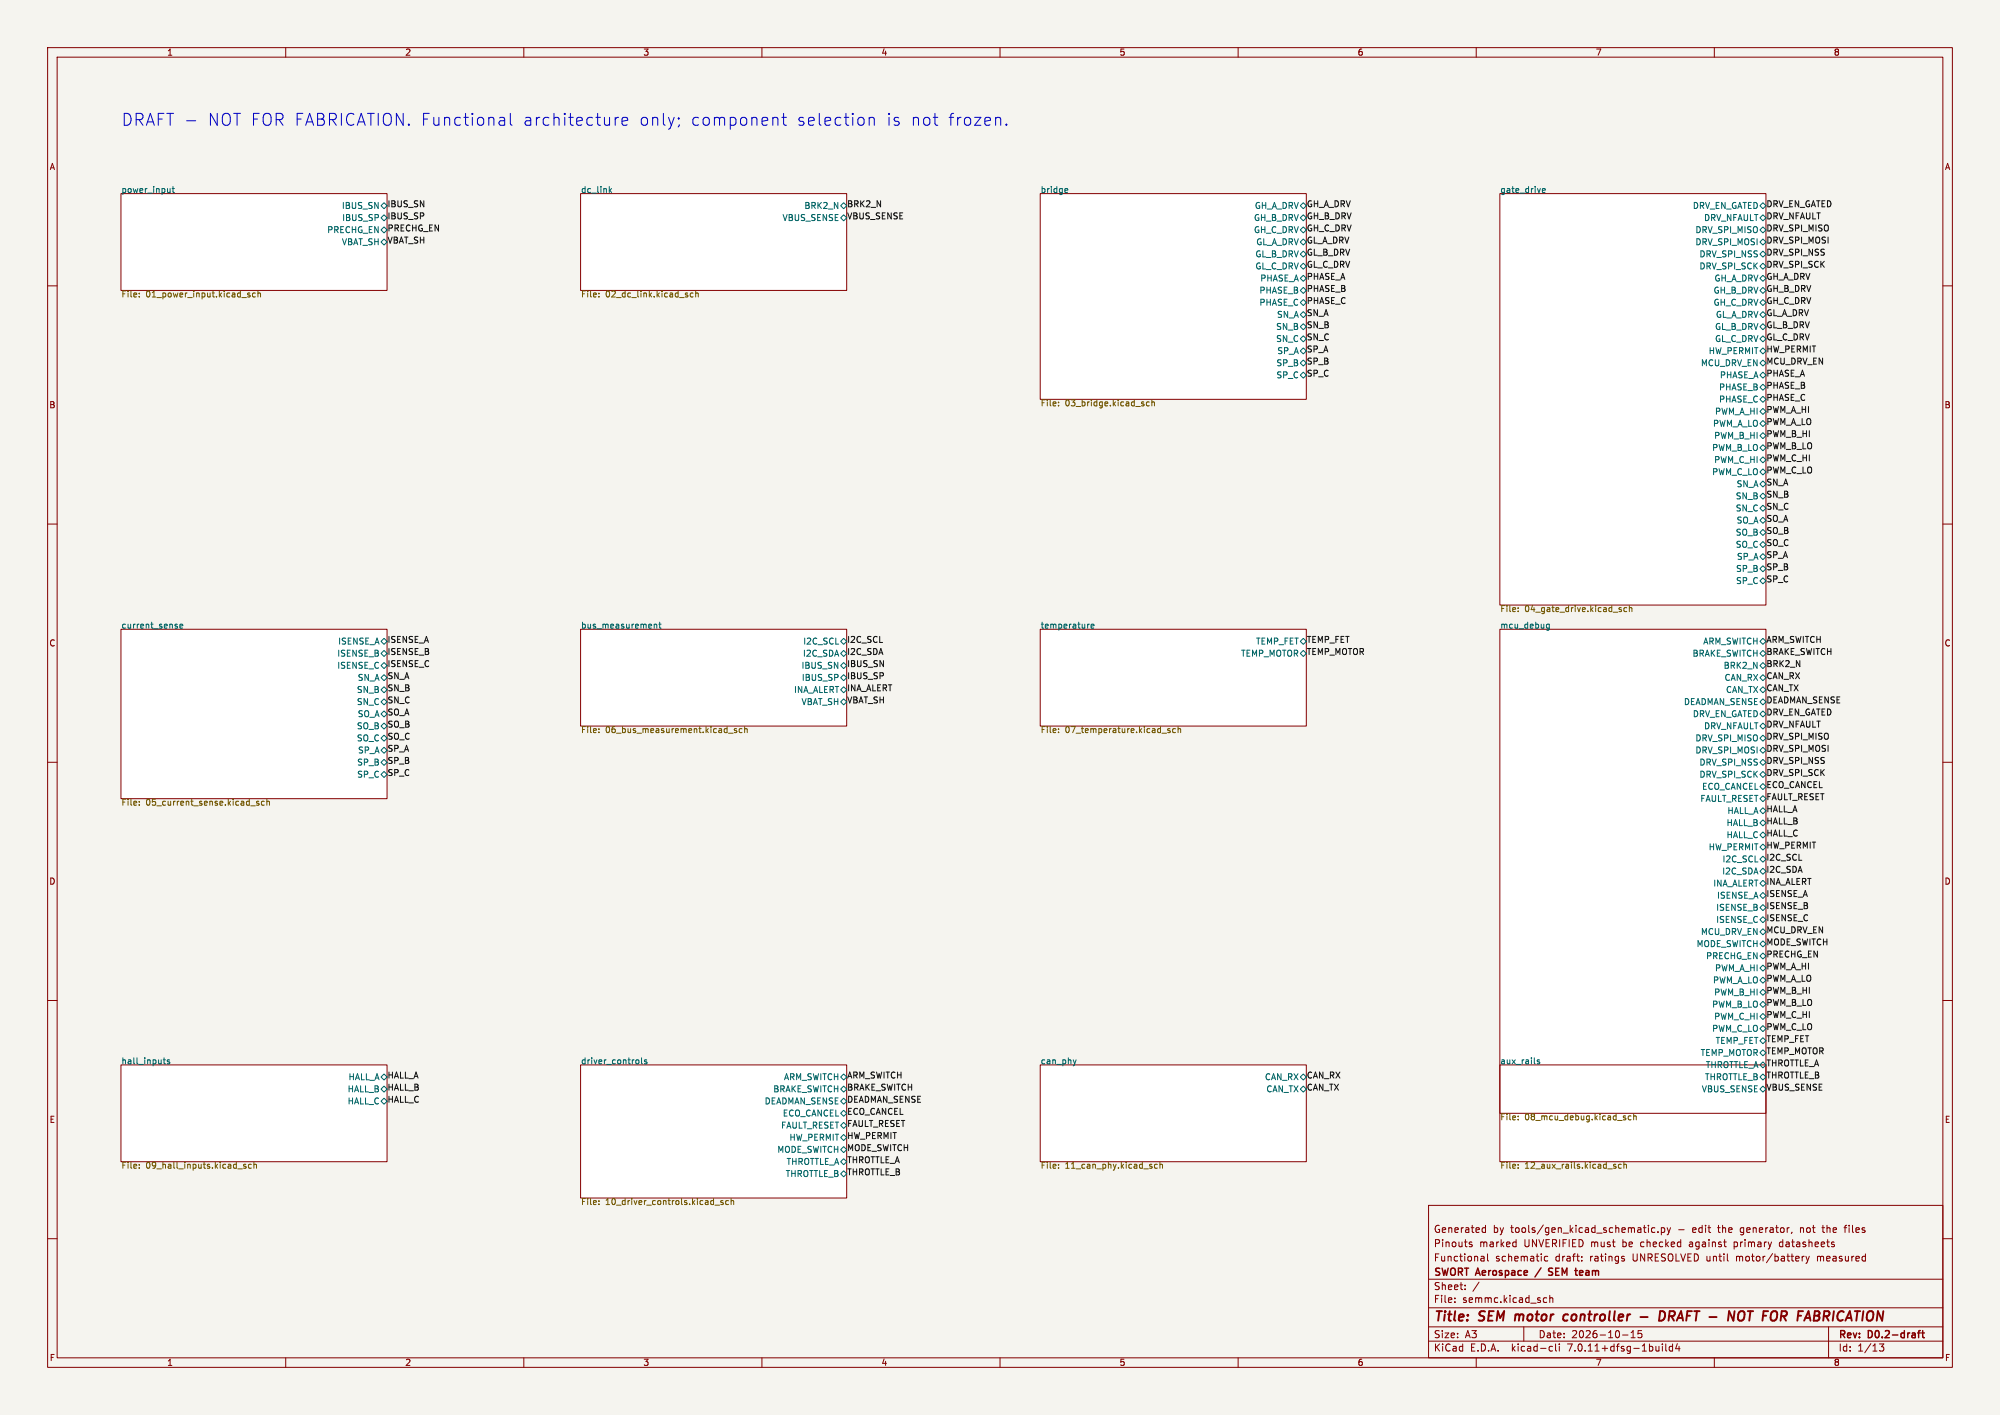
[picture p3: page 1]

Id: 1/13 Title: SEM motor controller - DRAFT - NOT FOR FABRICATION

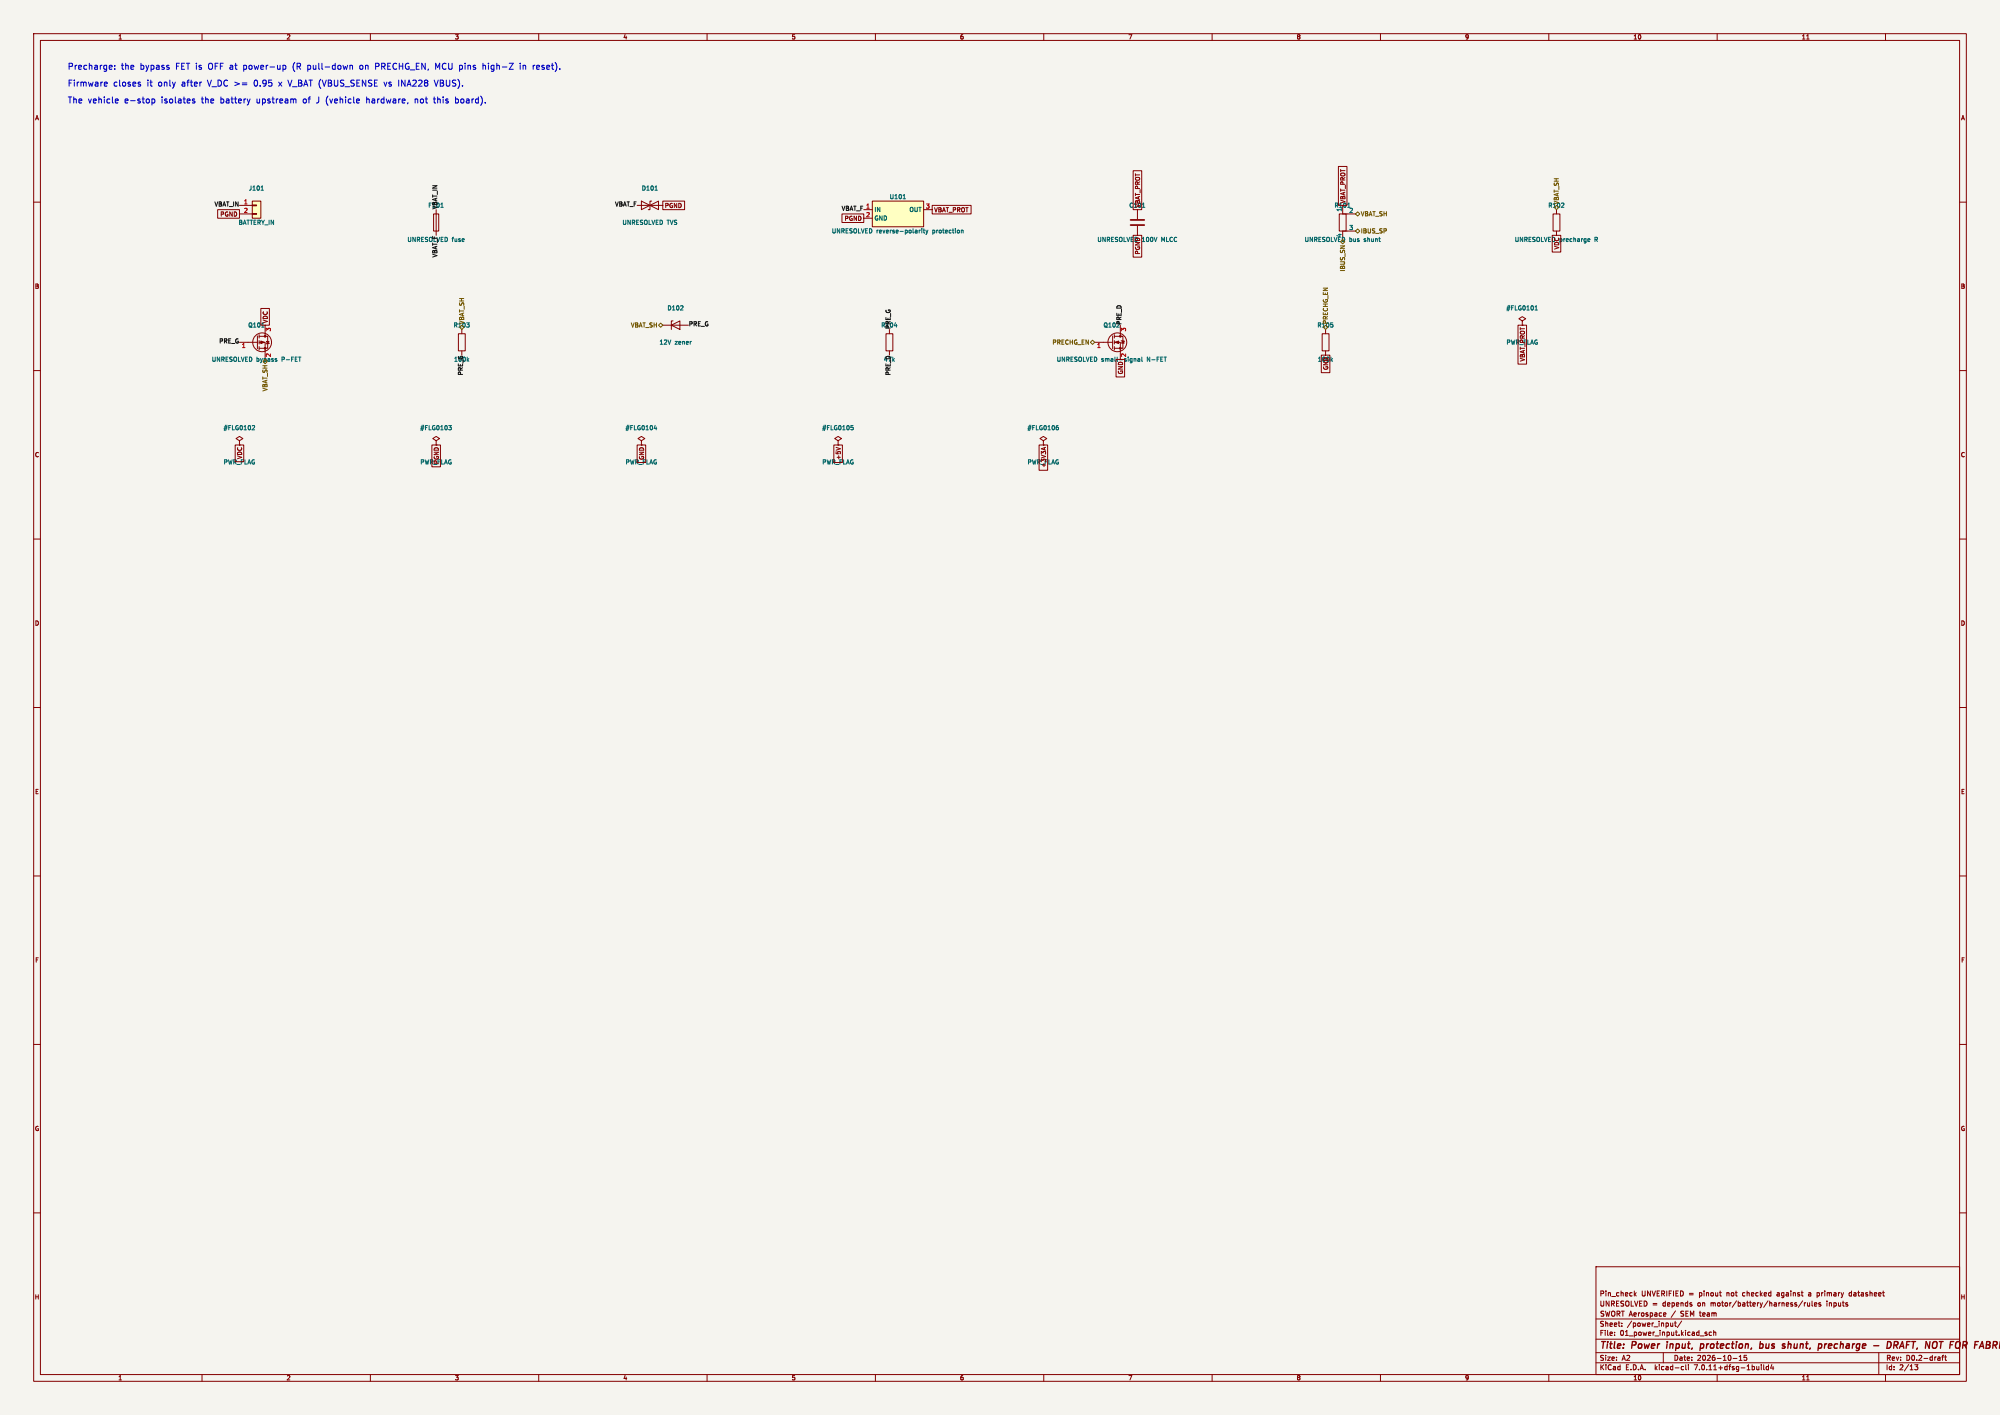
[picture p4: page 2]

Firmware closes it only after V_DC >= 0.95 x V_BAT (VBUS_SENSE vs INA228 VBUS).

2 3Q102 UNRESOLVED small-signal N-FET

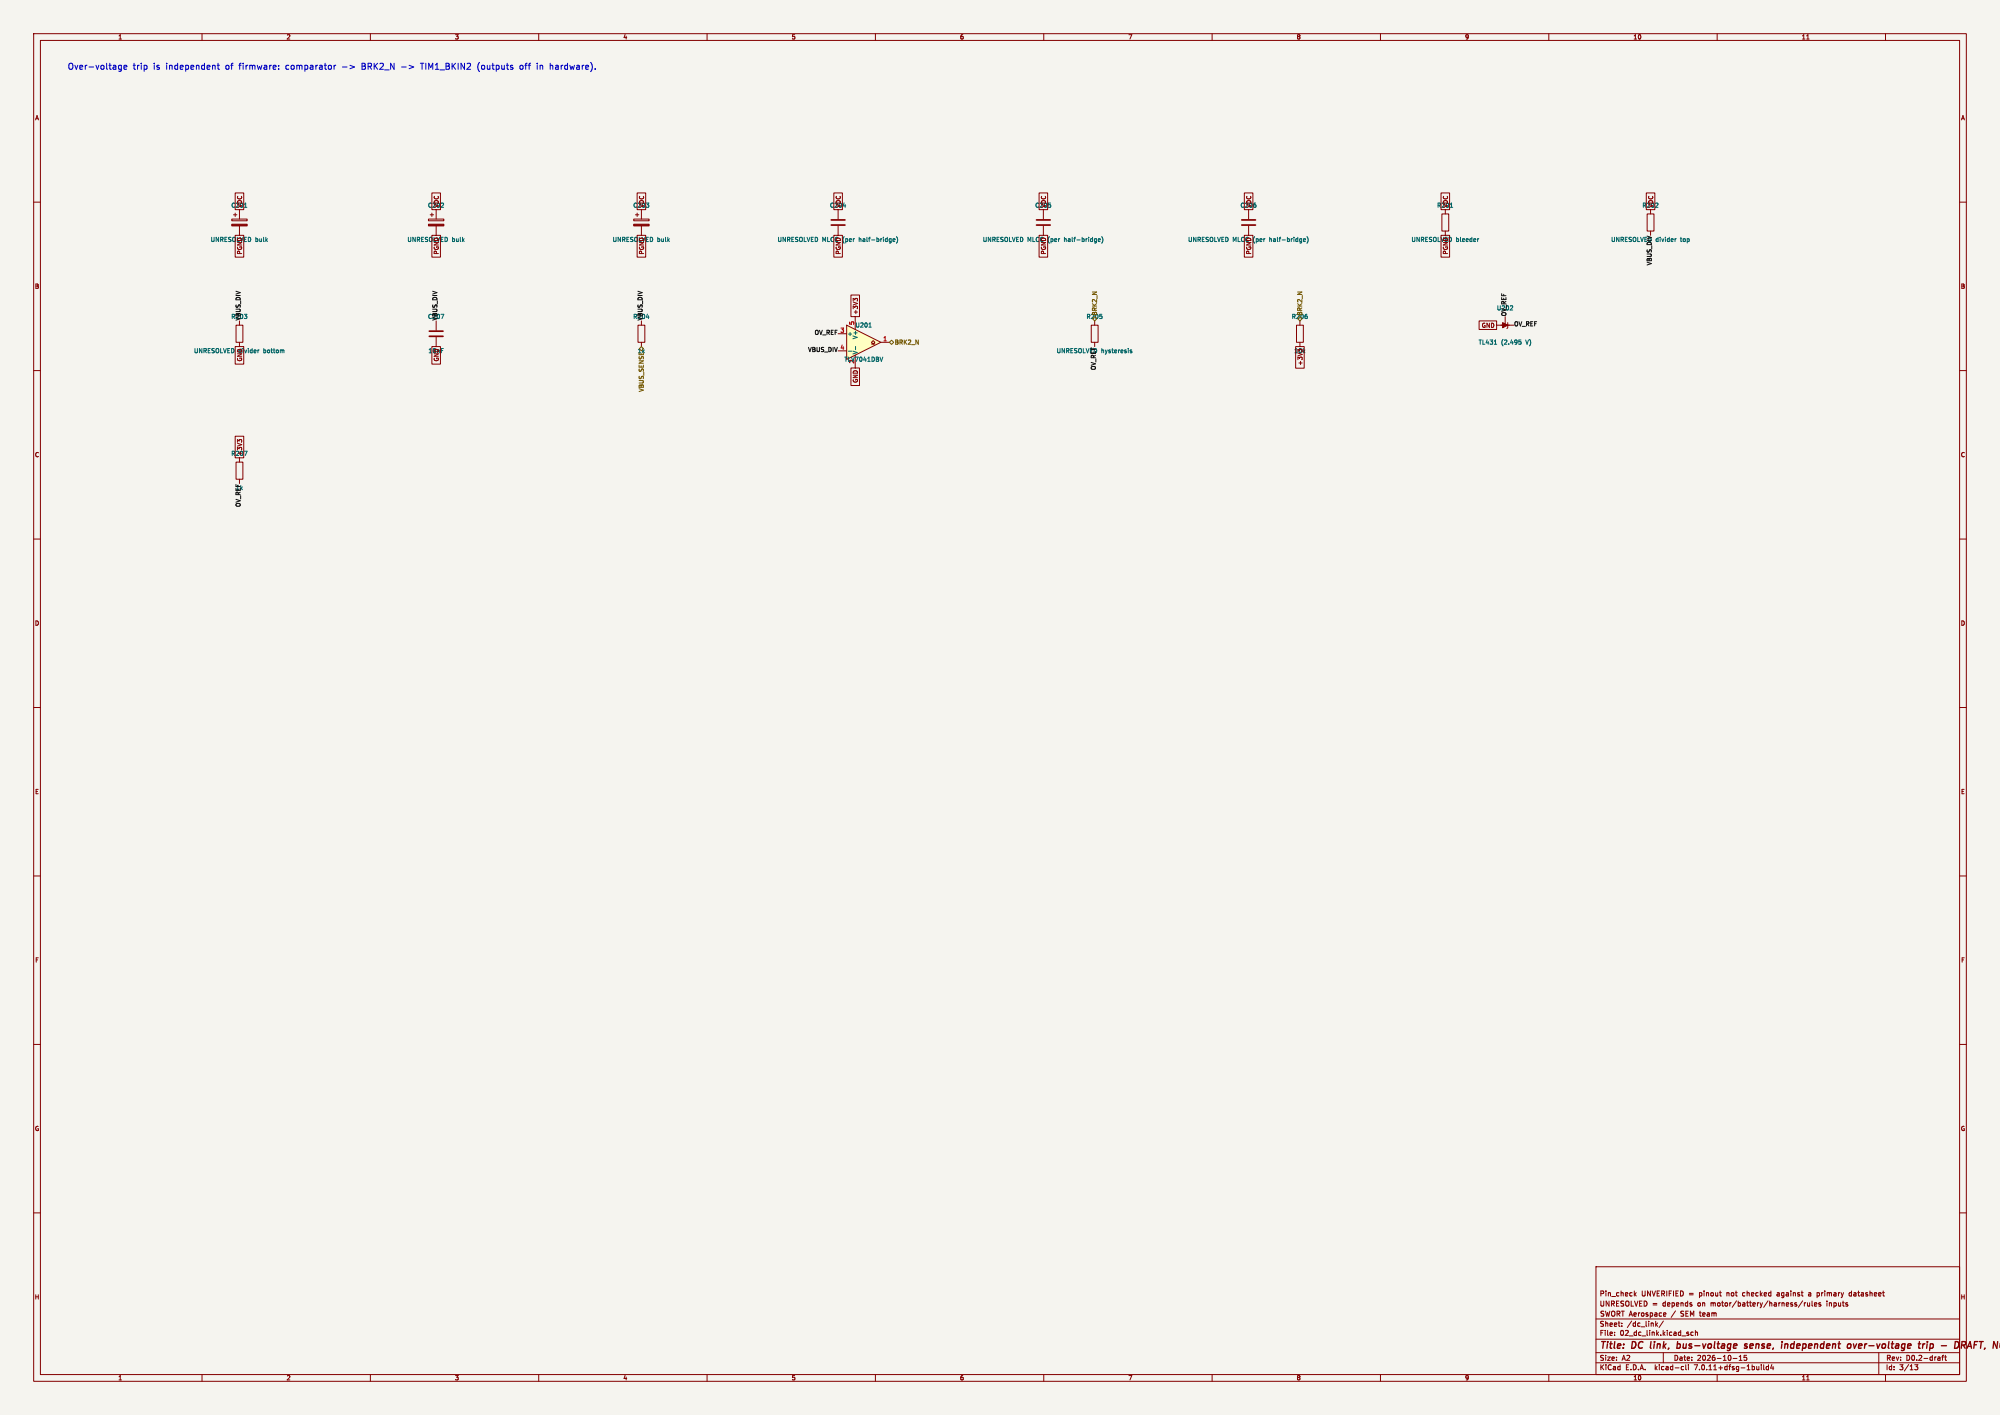
[picture p5: page 3]

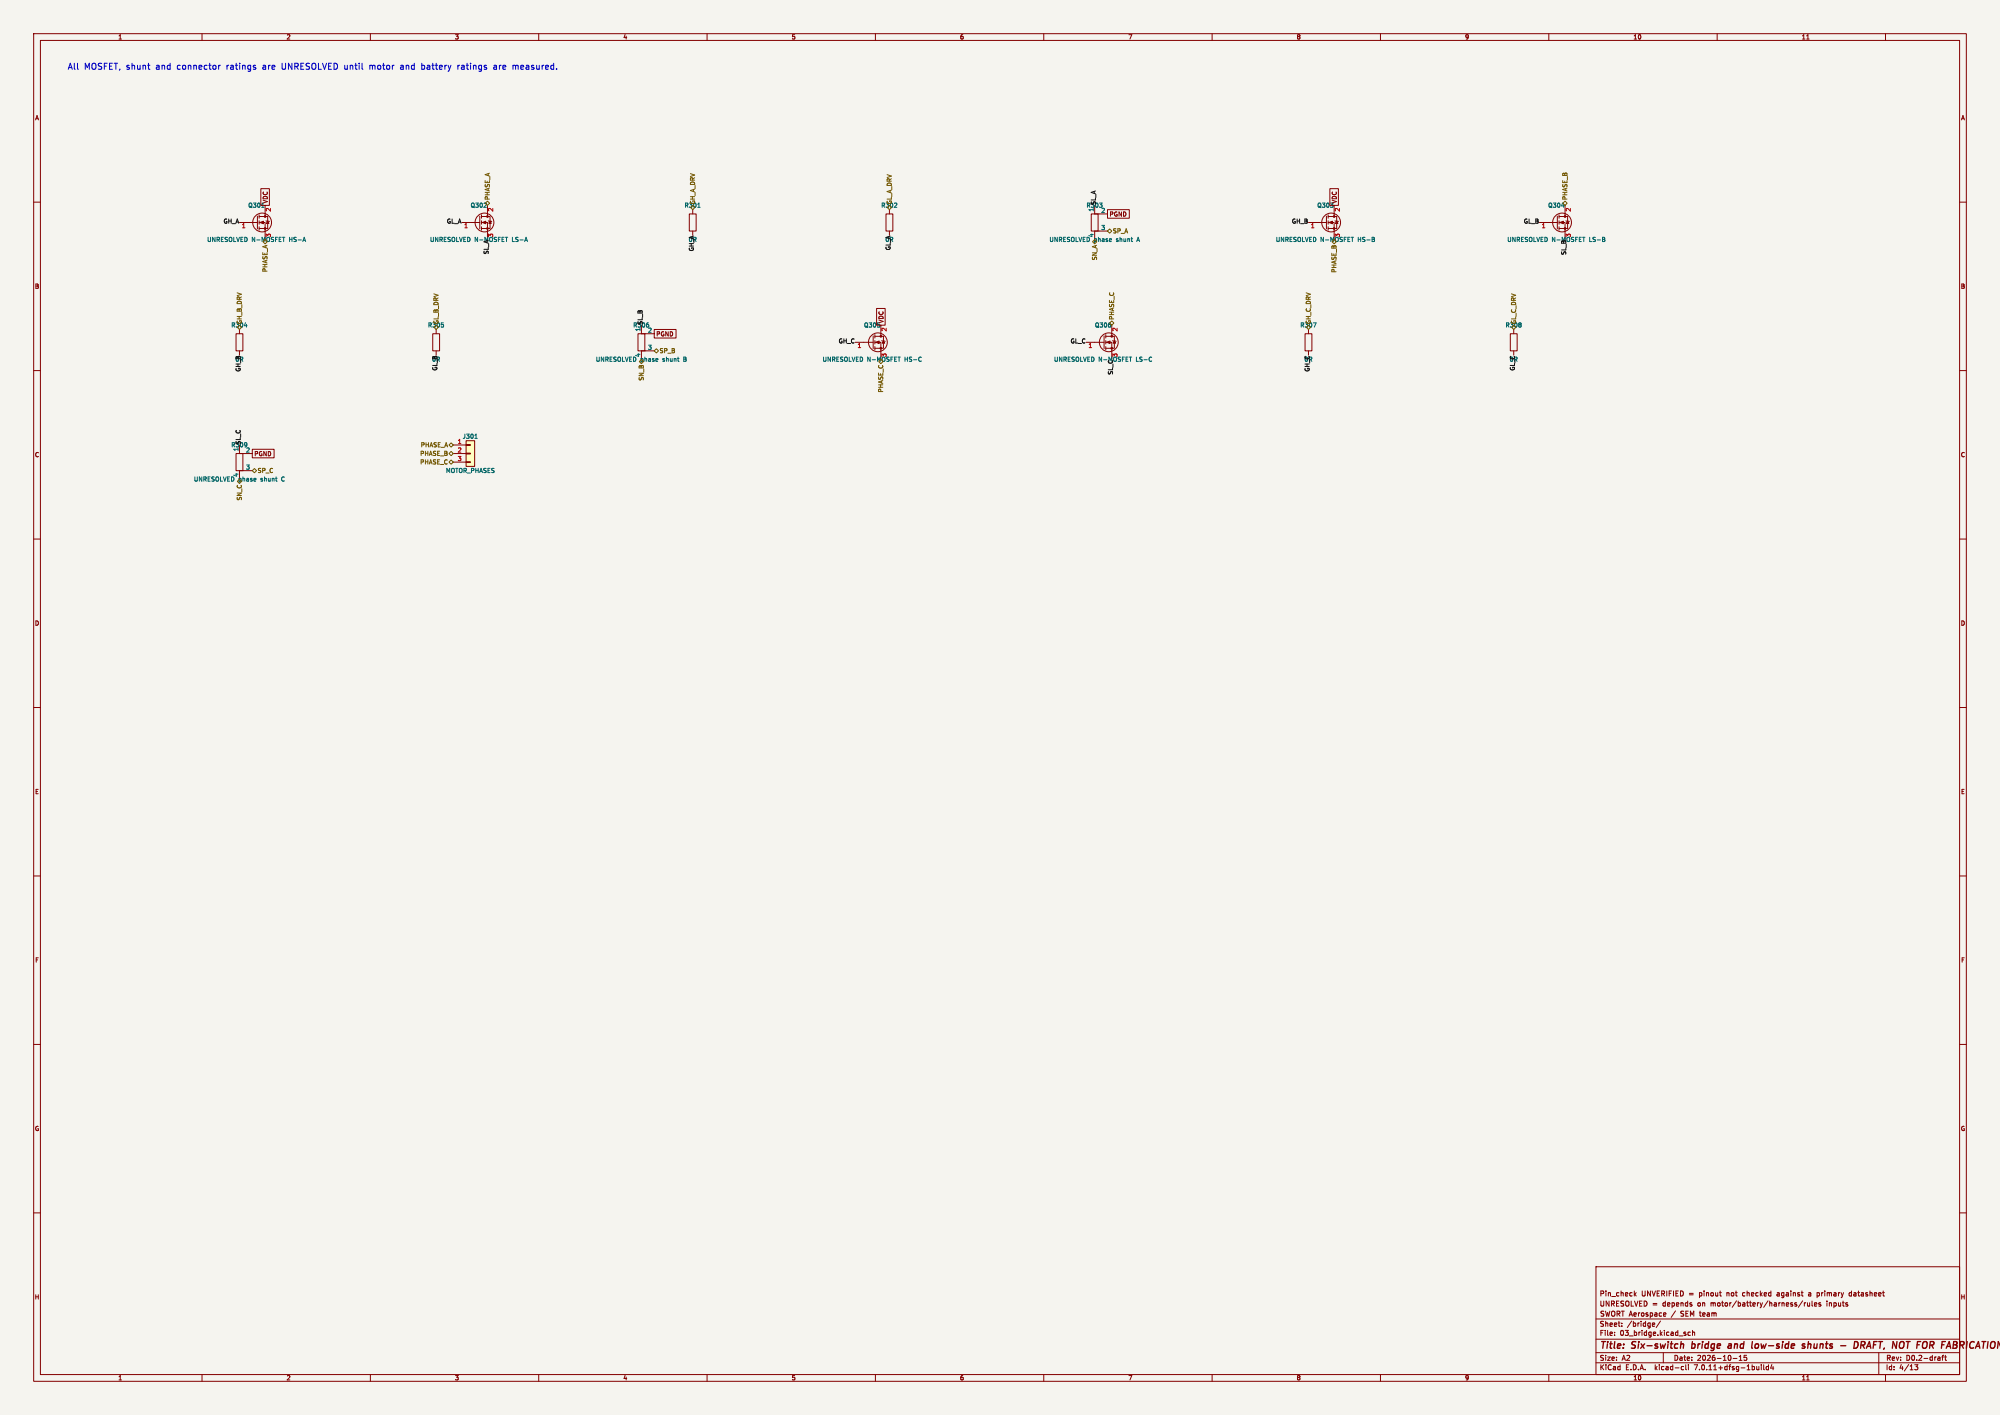
[picture p6: page 4]

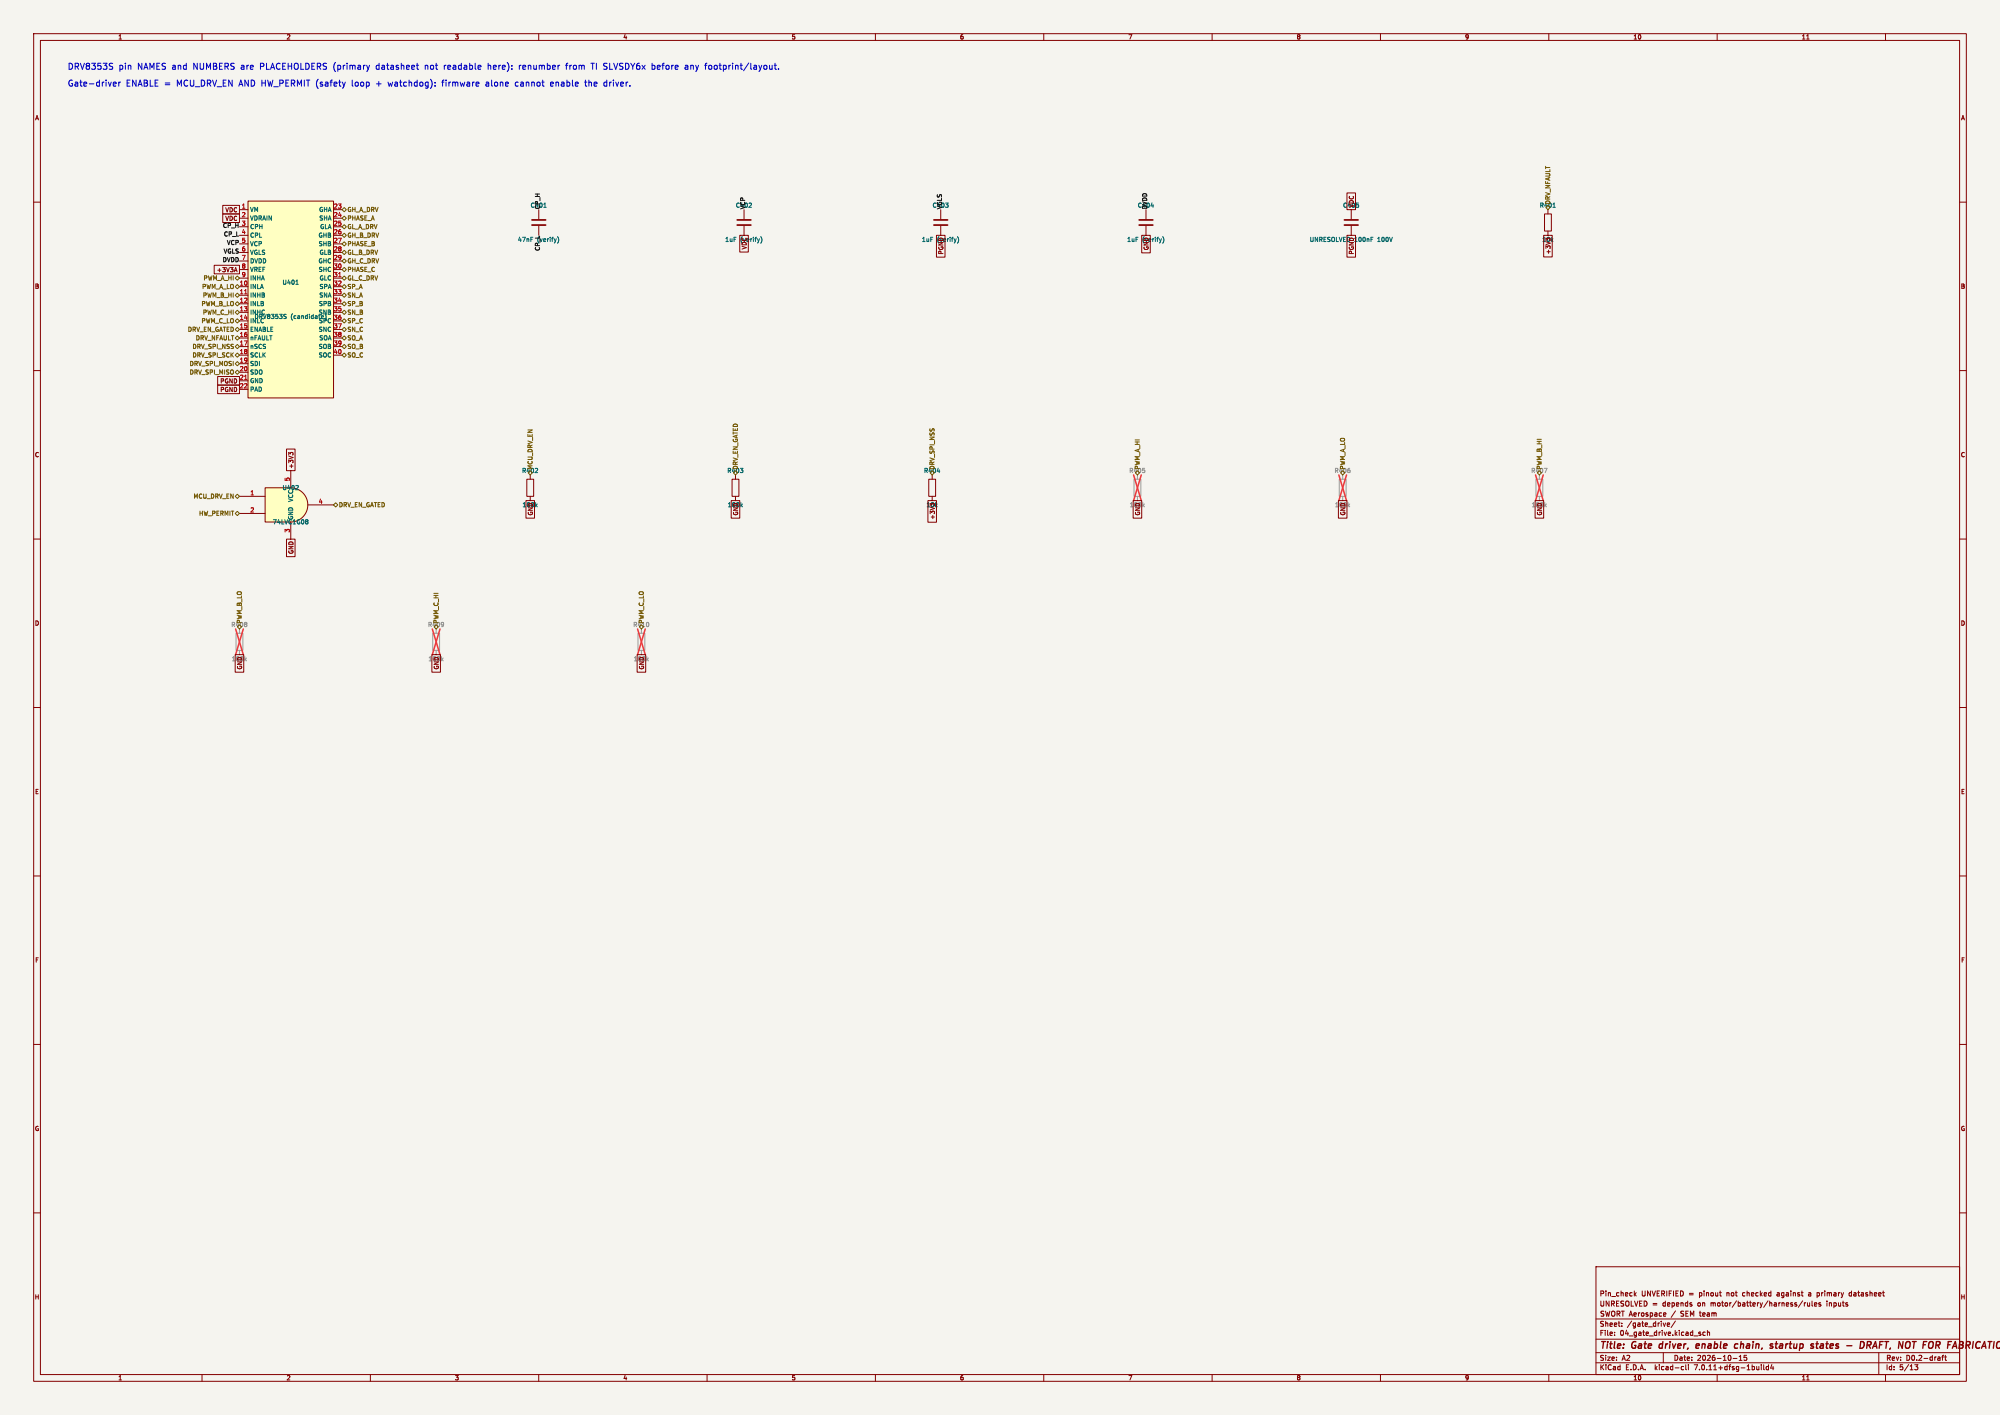
[picture p7: page 5]

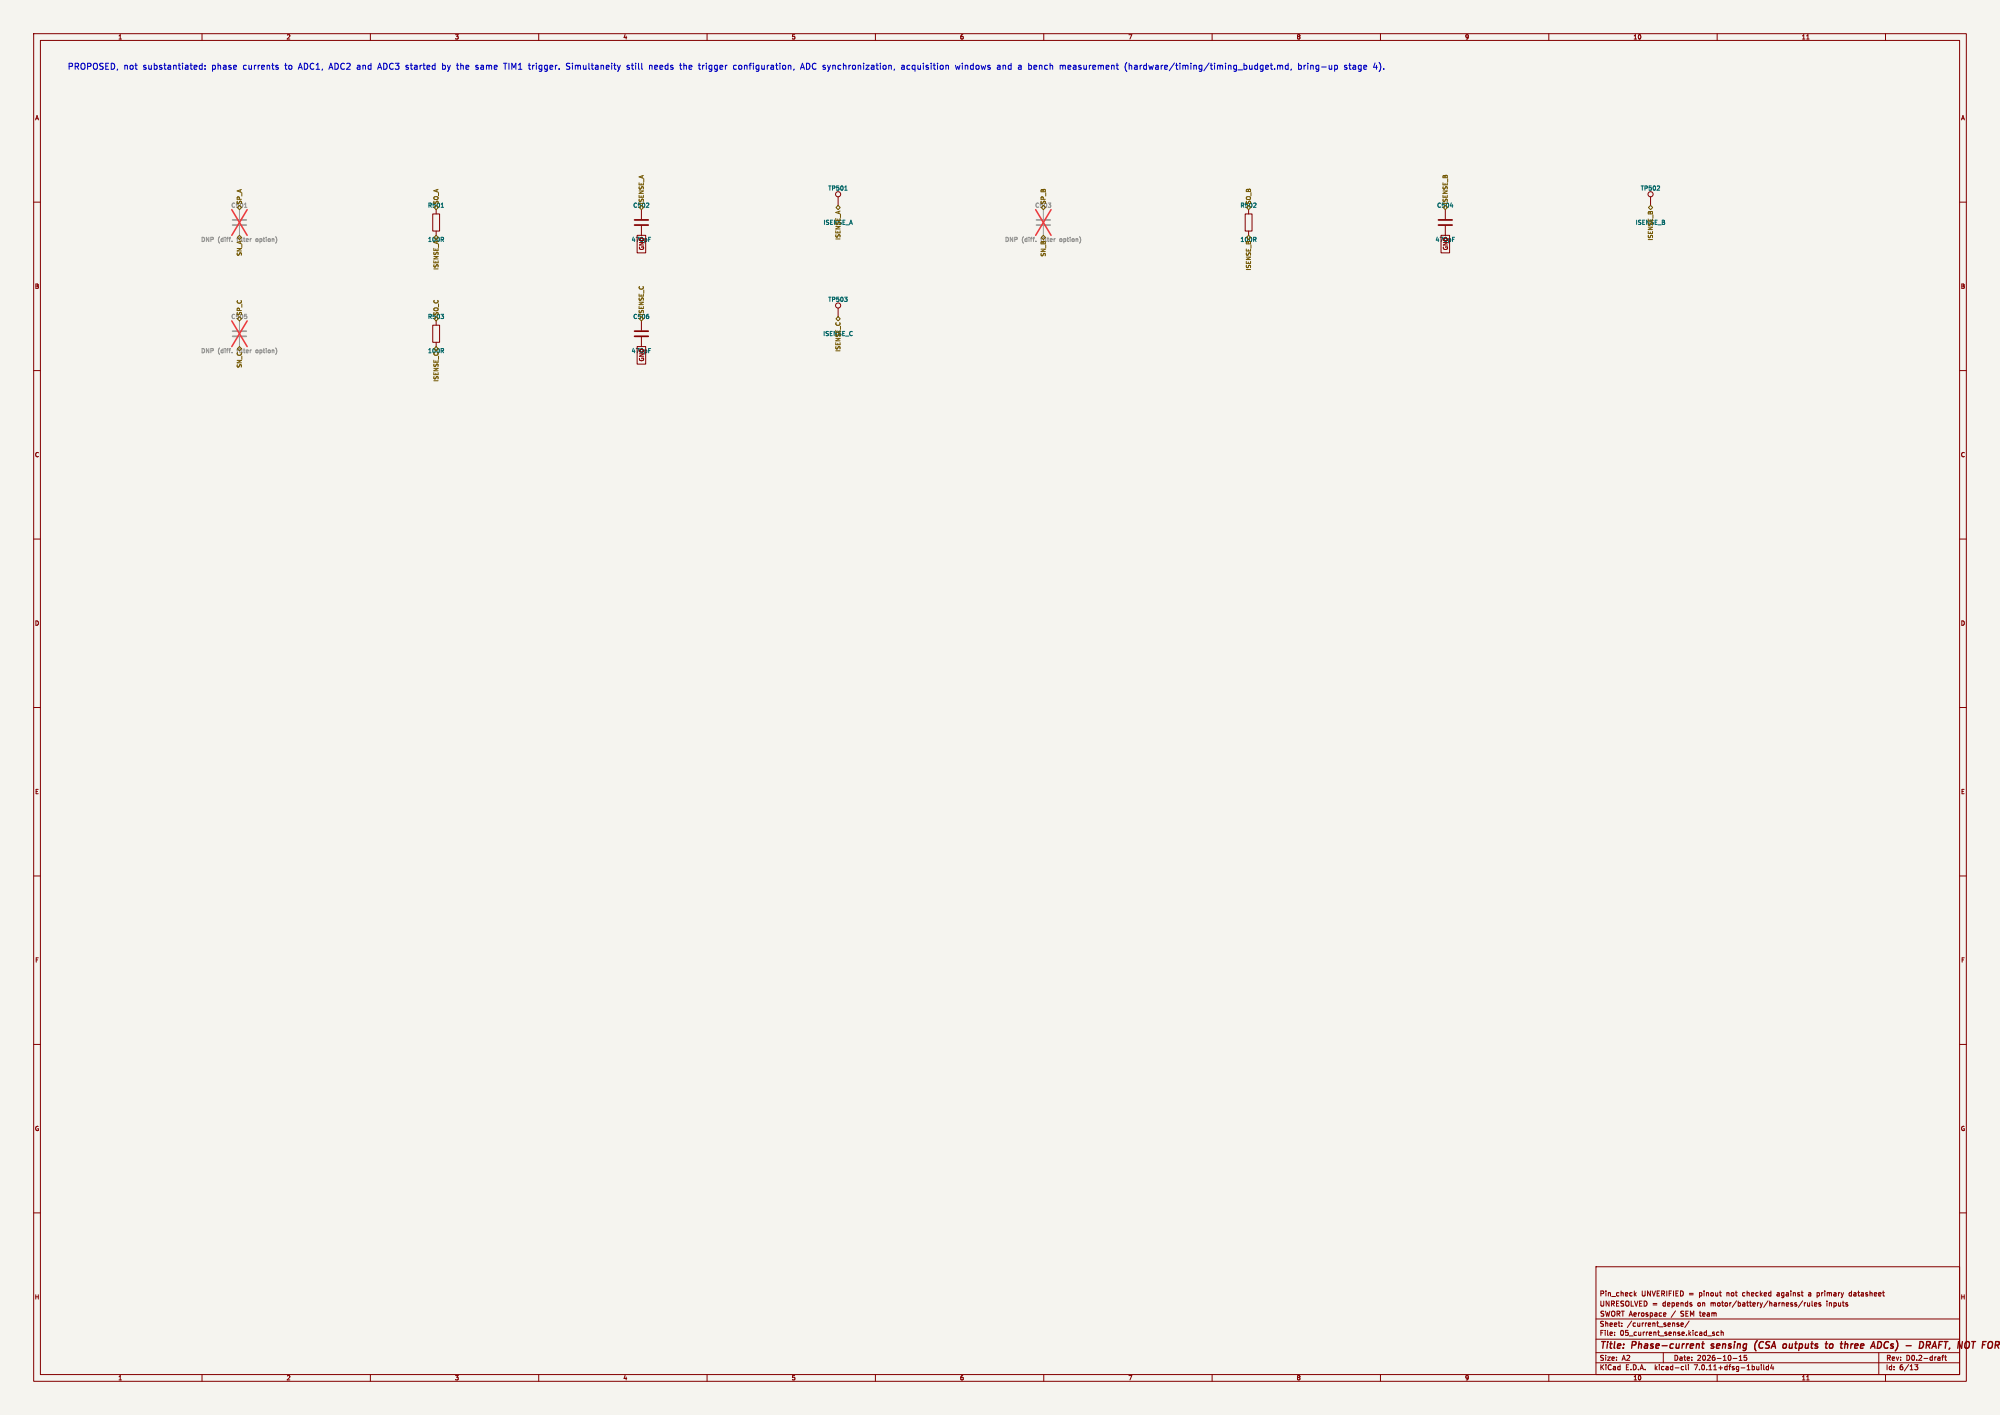
[picture p8: page 6]

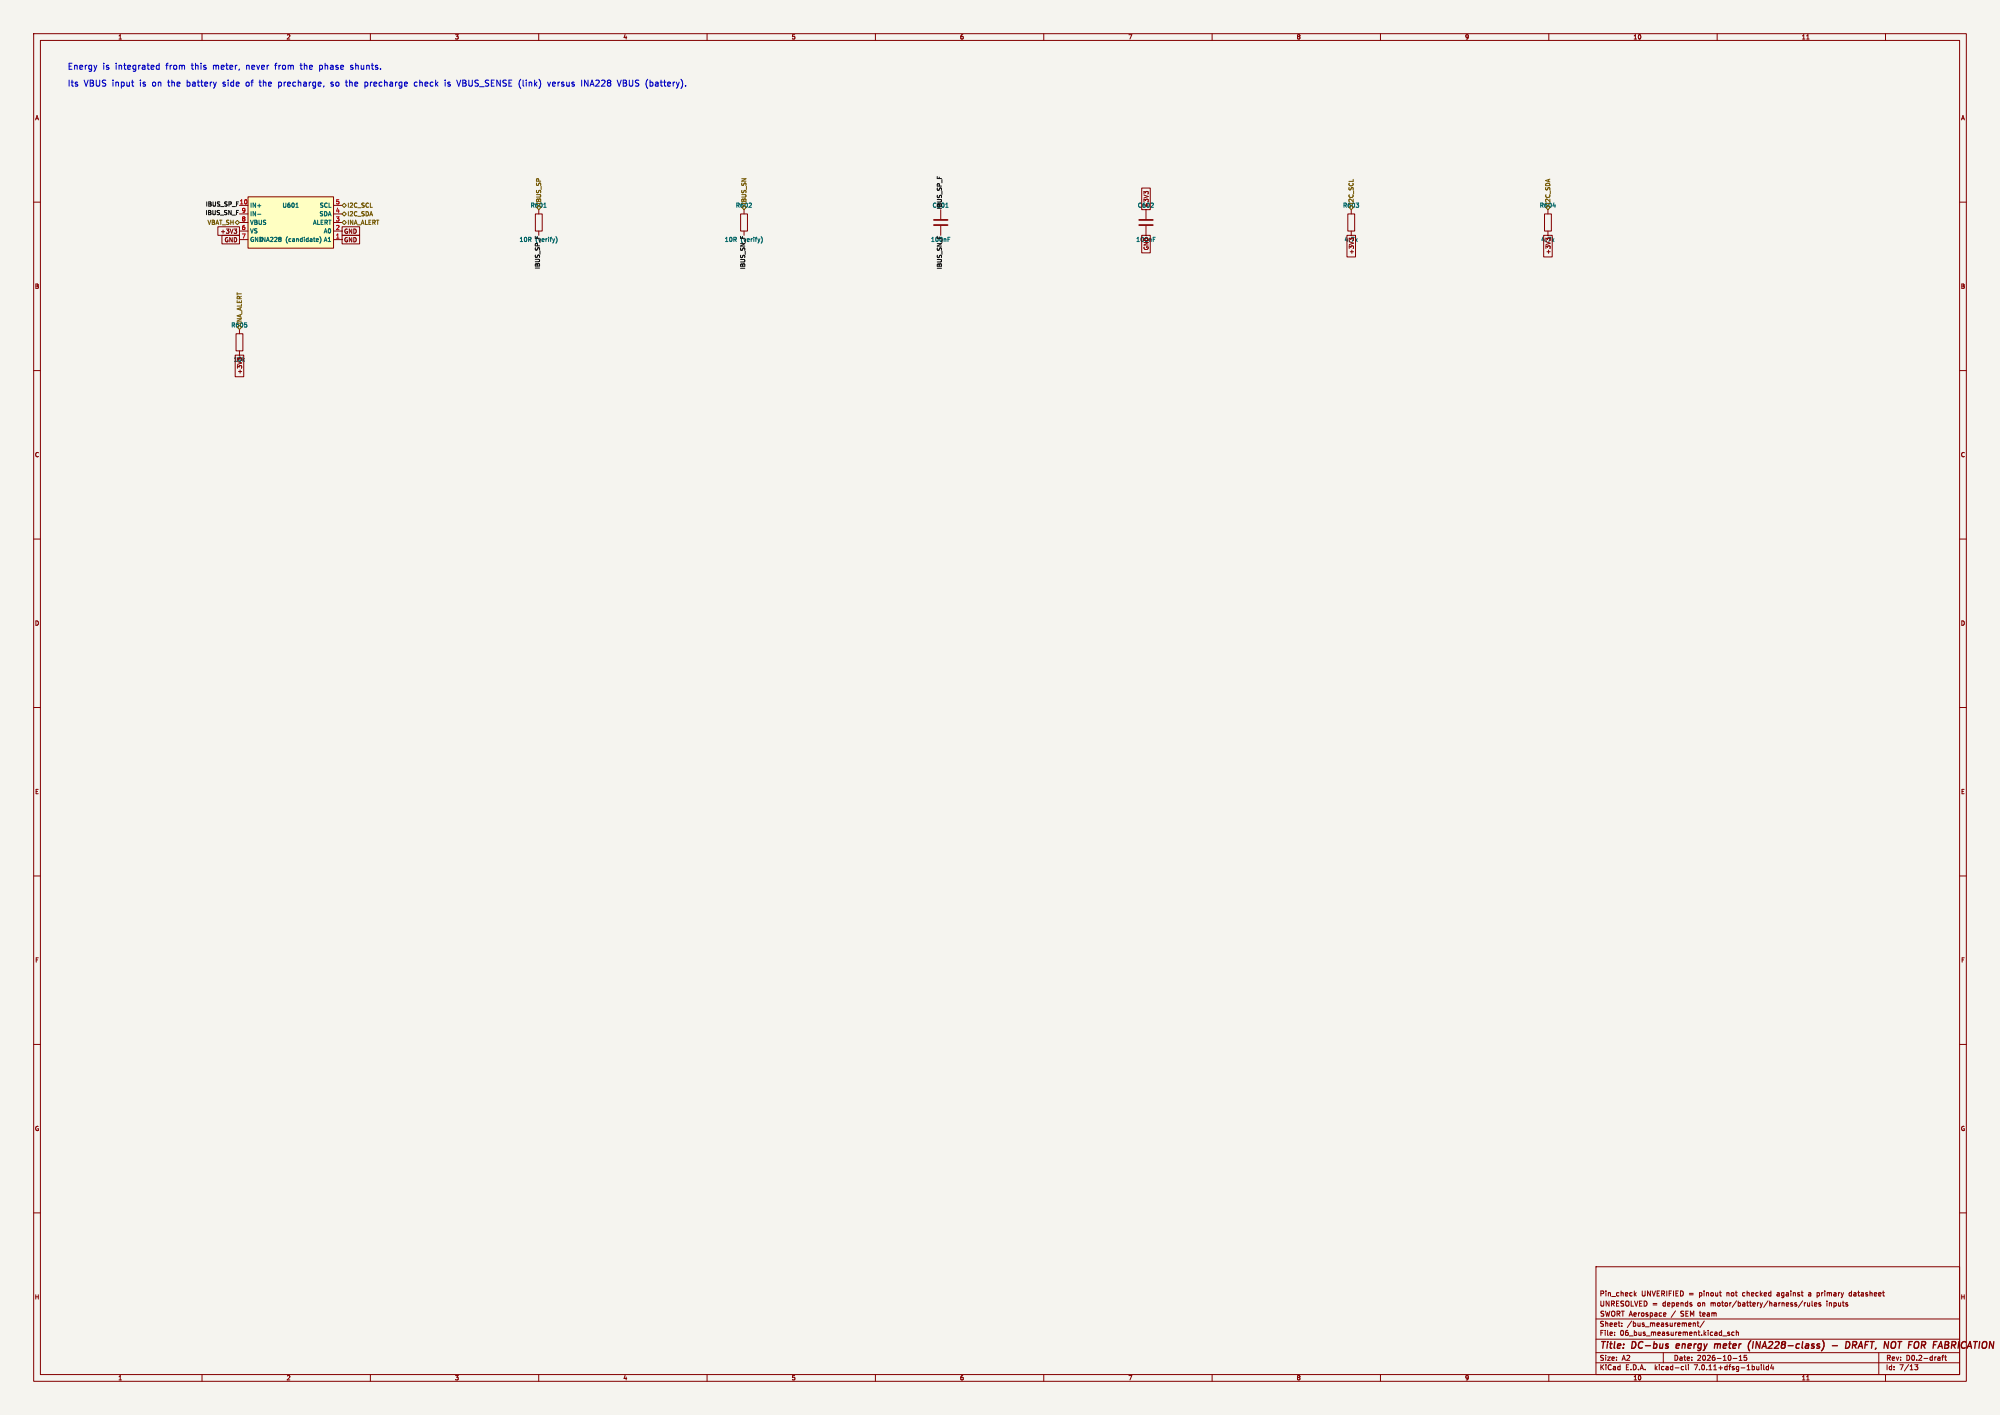
[picture p9: page 7]

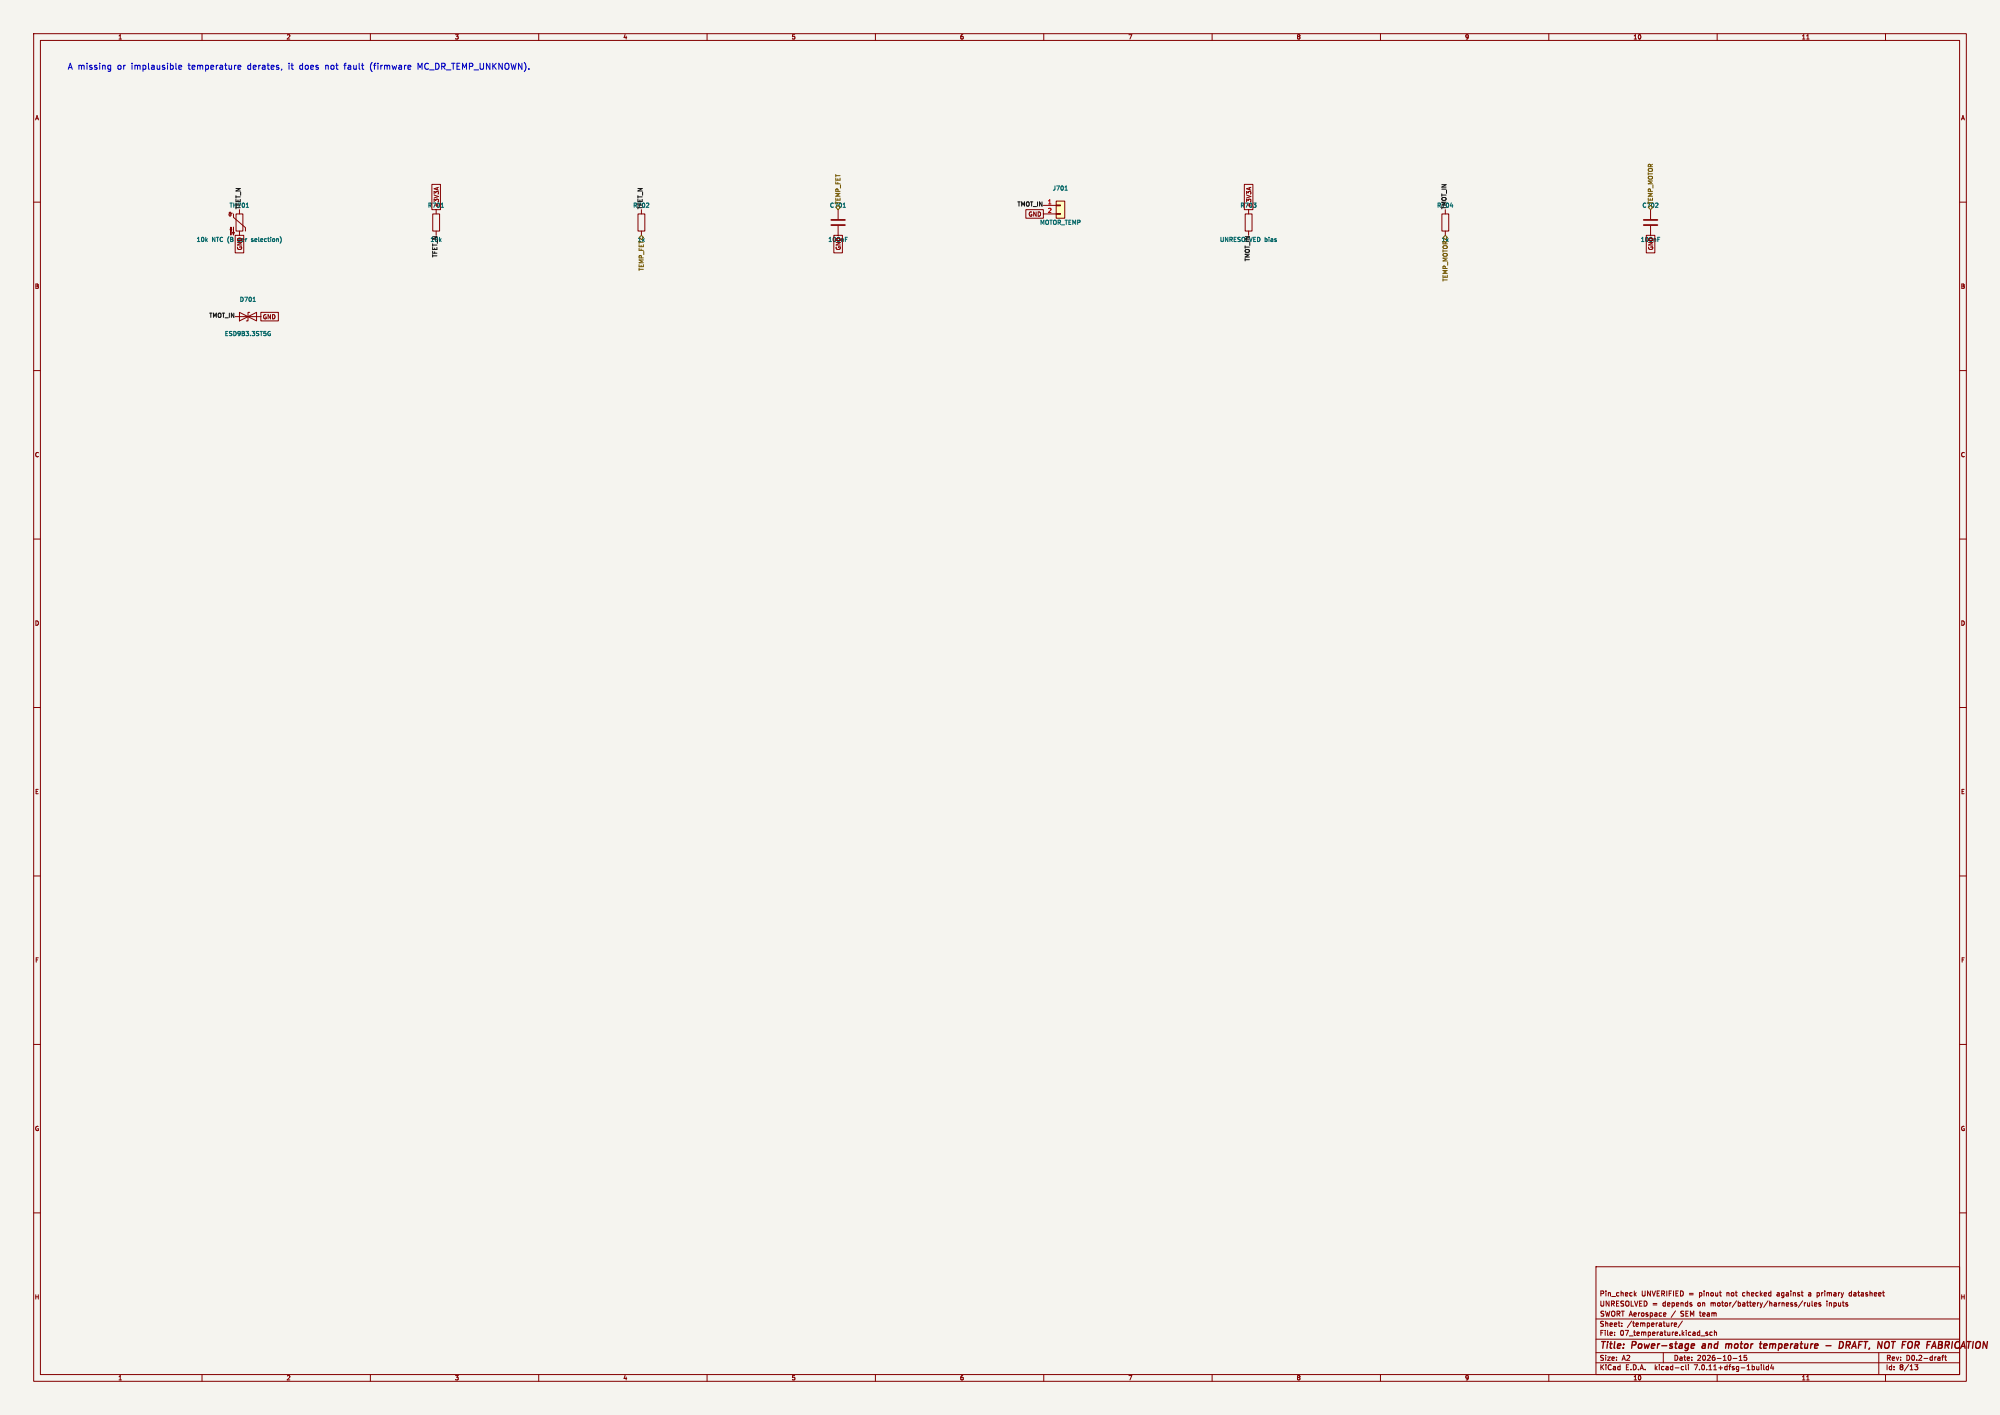
[picture p10: page 8]

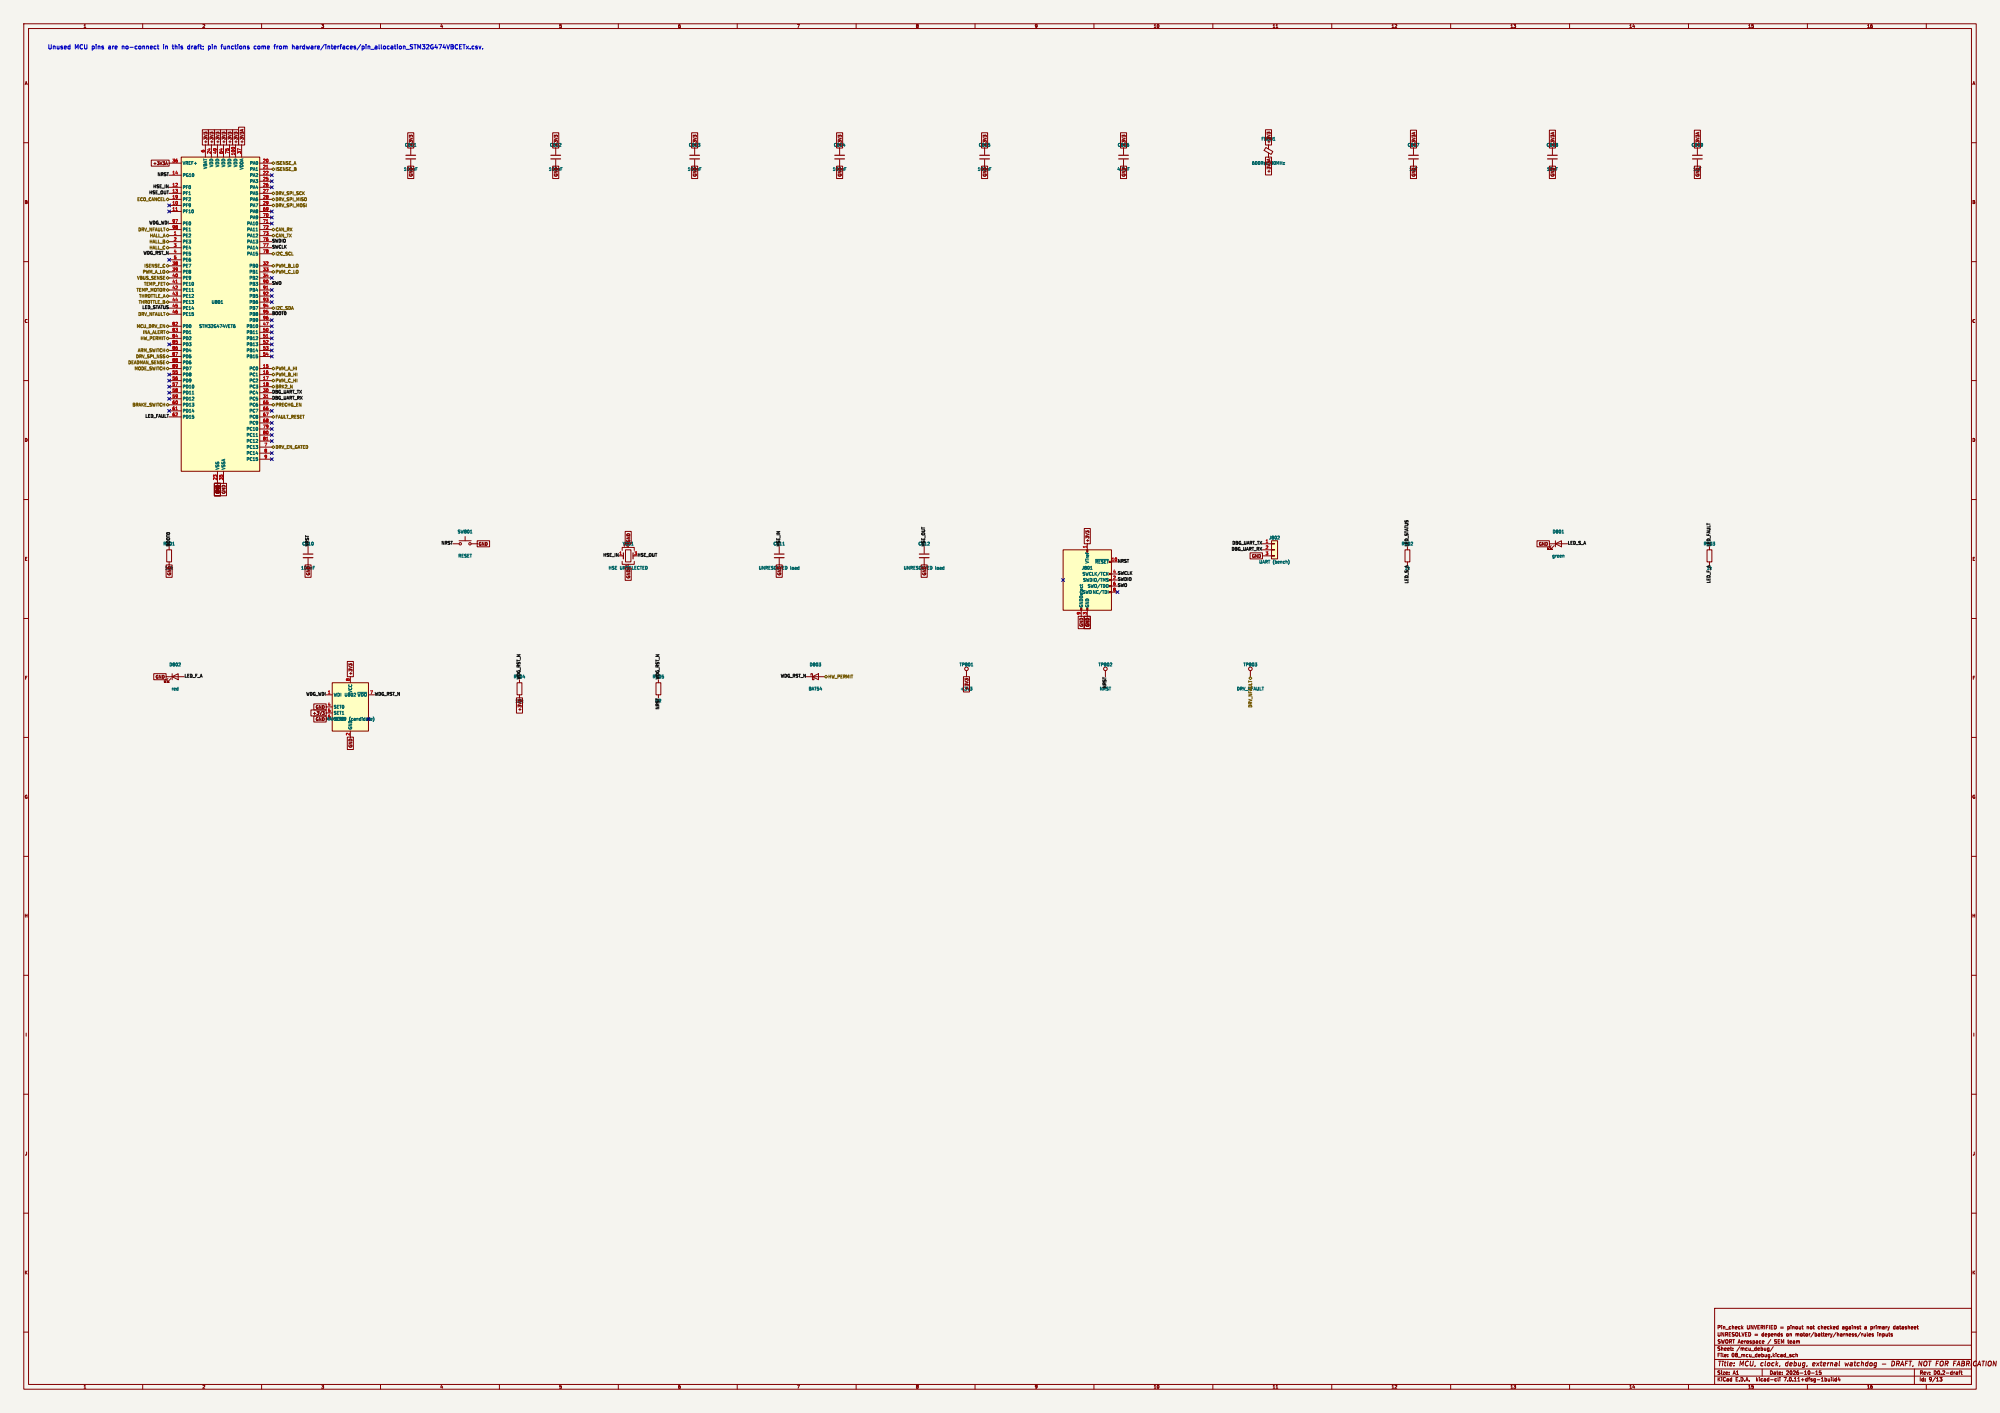
[picture p11: page 9]

Id: 9/13 Title: MCU, clock, debug, external watchdog - DRAFT, NOT FOR FABRICATION

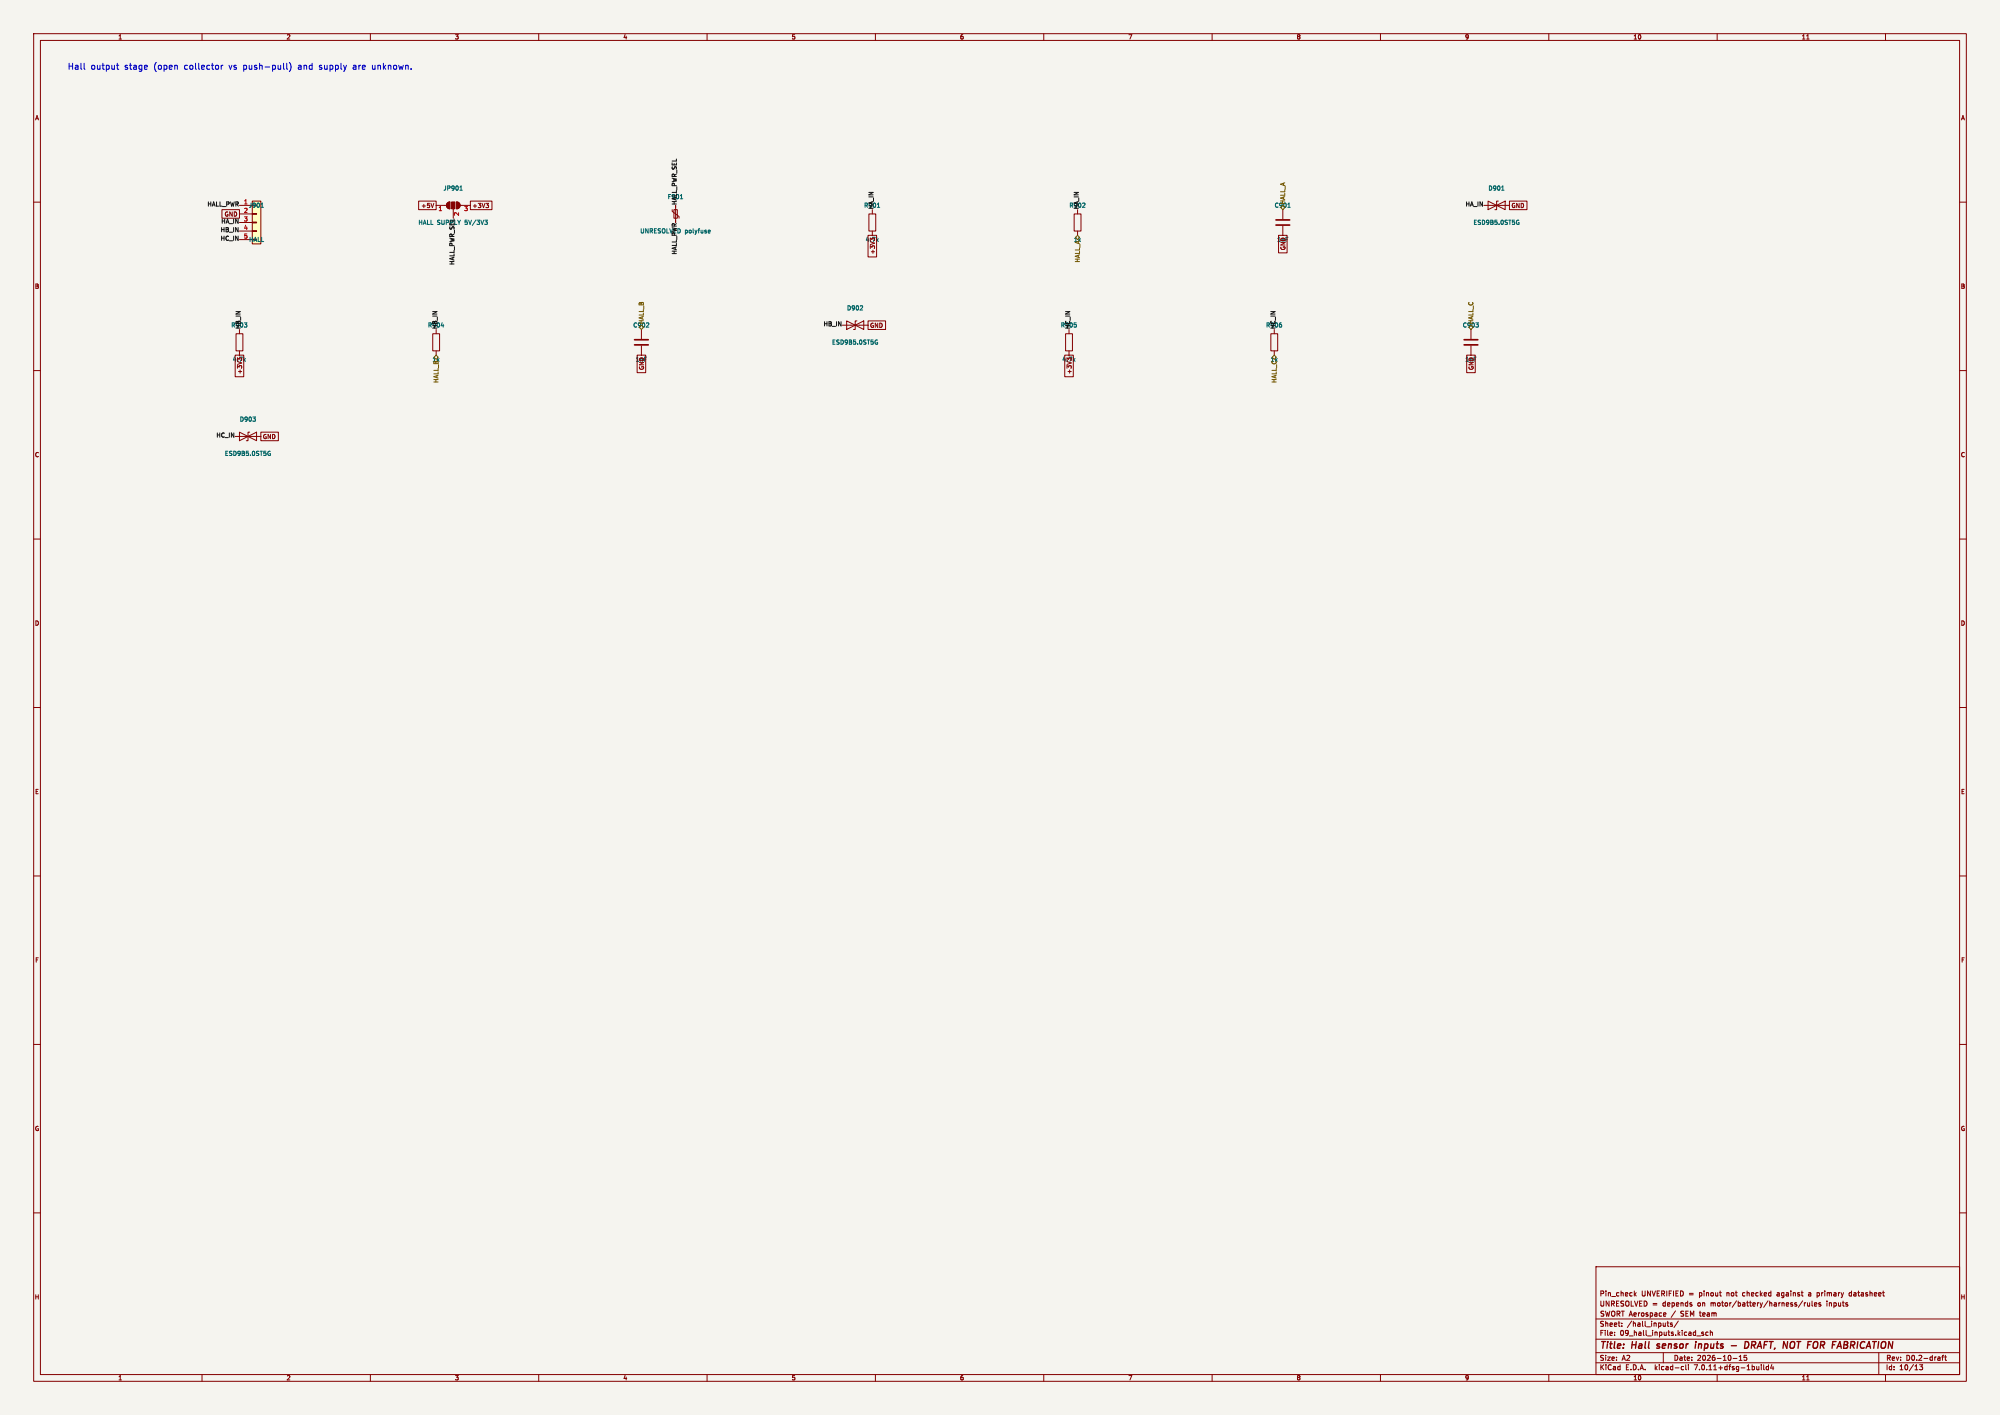
[picture p12: page 10]

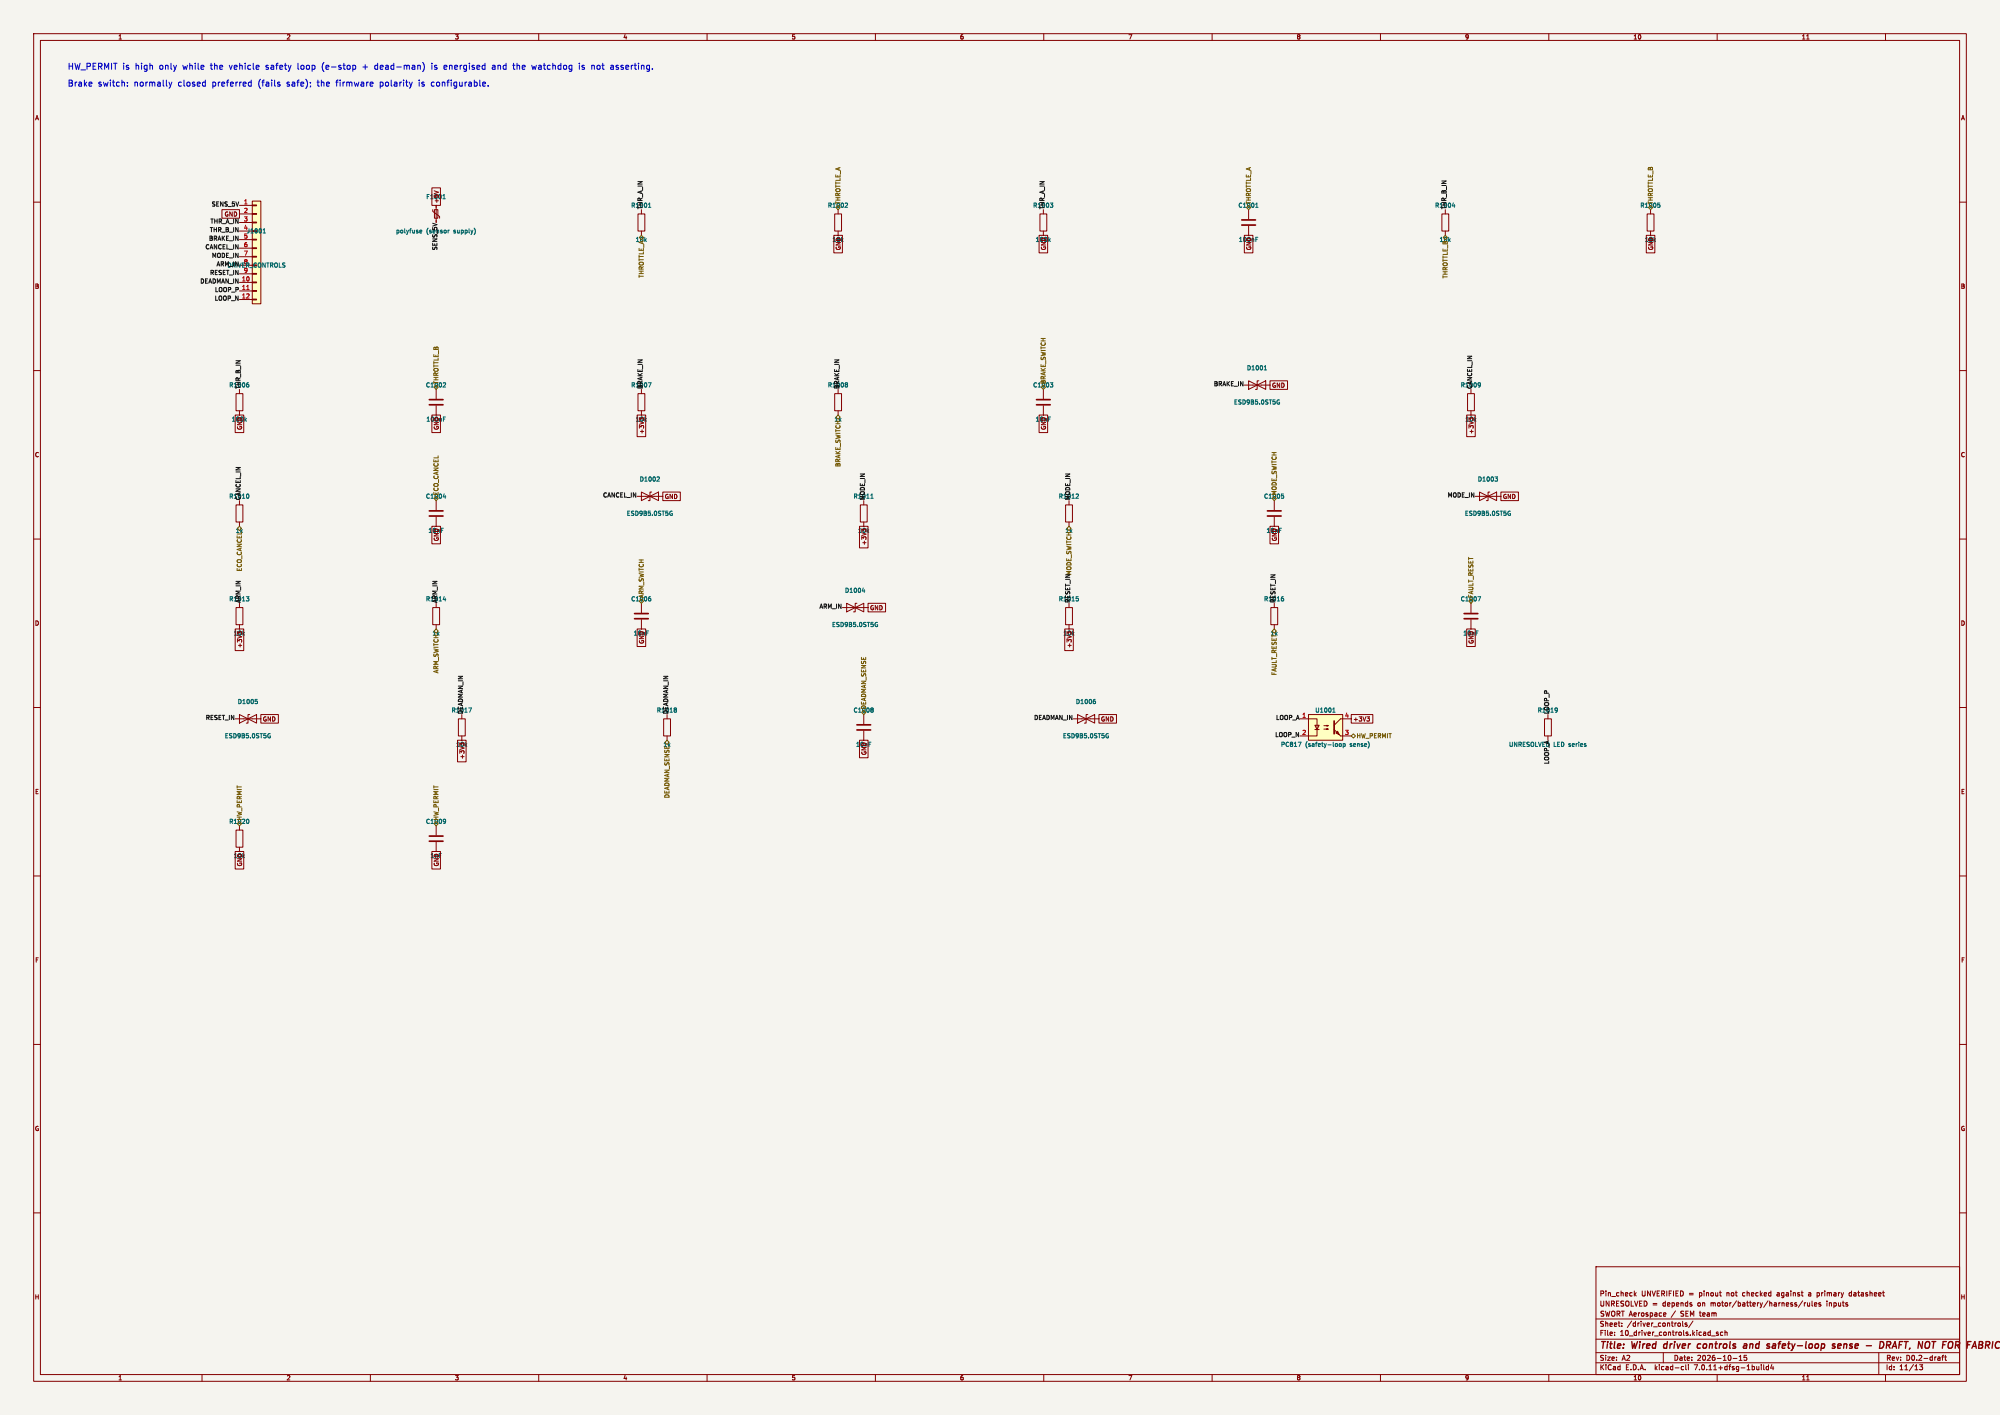
[picture p13: page 11]

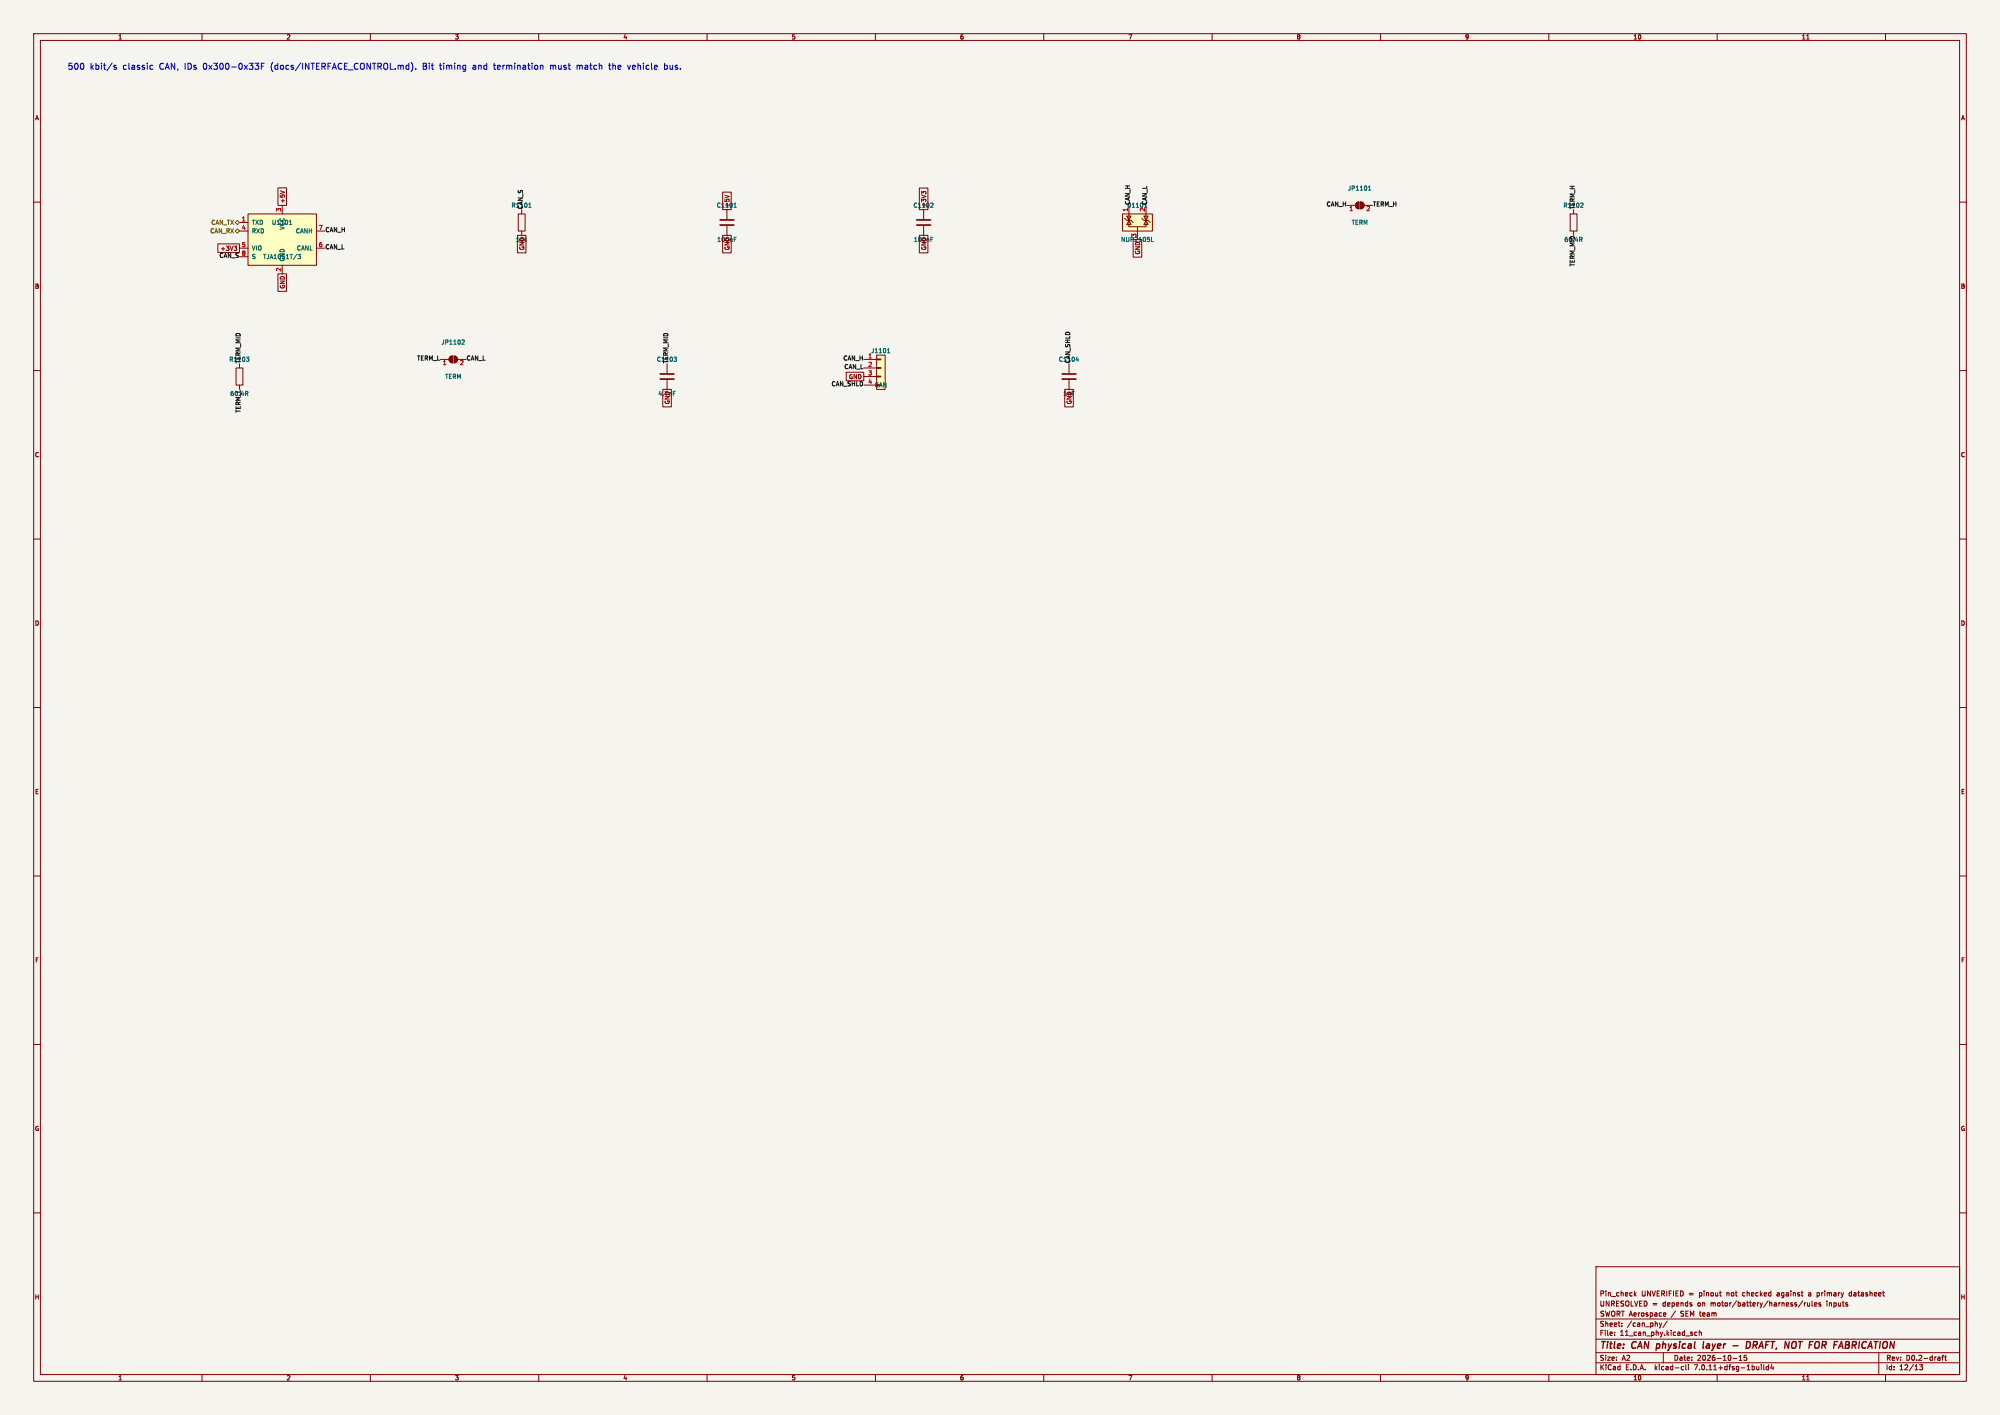
[picture p14: page 12]

3 RXD 4 VIO 5 CANL 6 CANH 7 S

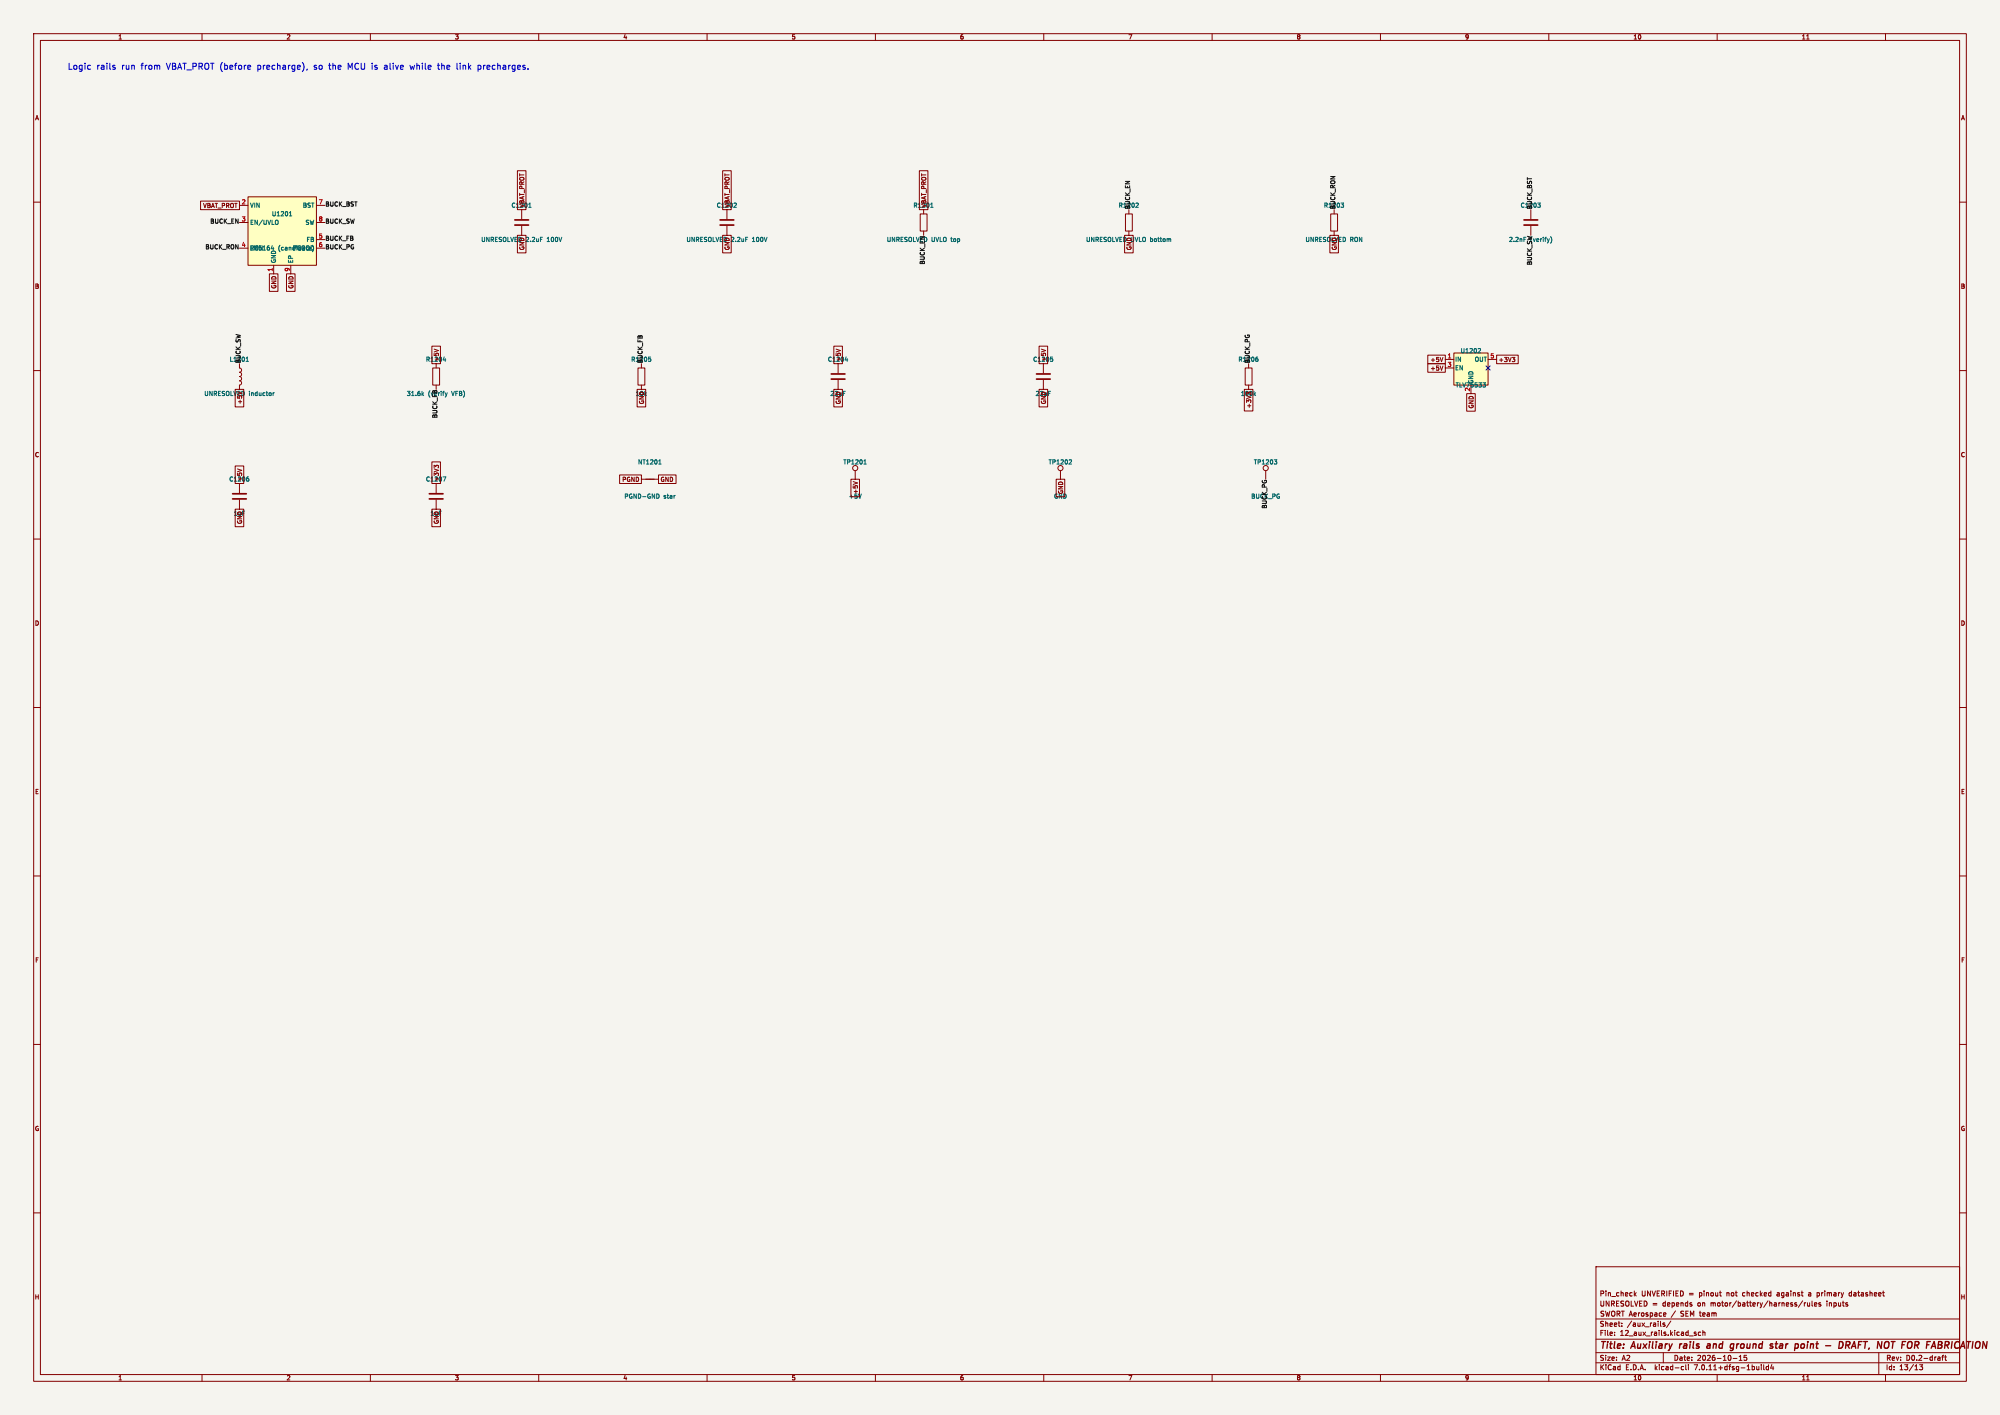
[picture p15: page 13]

1 VIN 2 EN/UVLO 3 RON 4 FB 5 PGOOD 6 BST 7 SW 8 EP

5 U1202 TLV75533 R1201 UNRESOLVED UVLO top C1202 UNRESOLVED 2.2uF 100V
