SWORT-Aerospace/sem-motor-controller/hardware/kicad/01_power_input.kicad_sch

## KiCad design hardware/kicad/01_power_input.kicad_sch (2026-10-15)

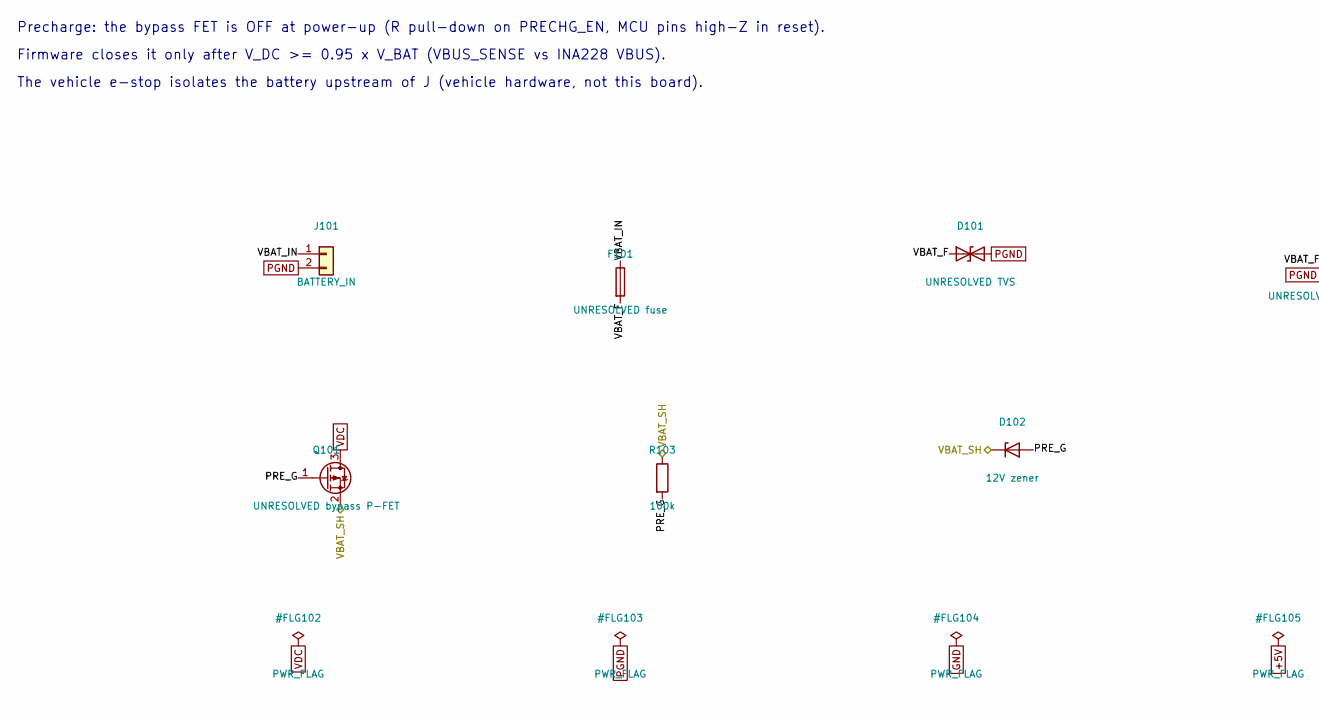
[picture p16: schematic 01_power_input.kicad_sch, part in row 1, column 1]

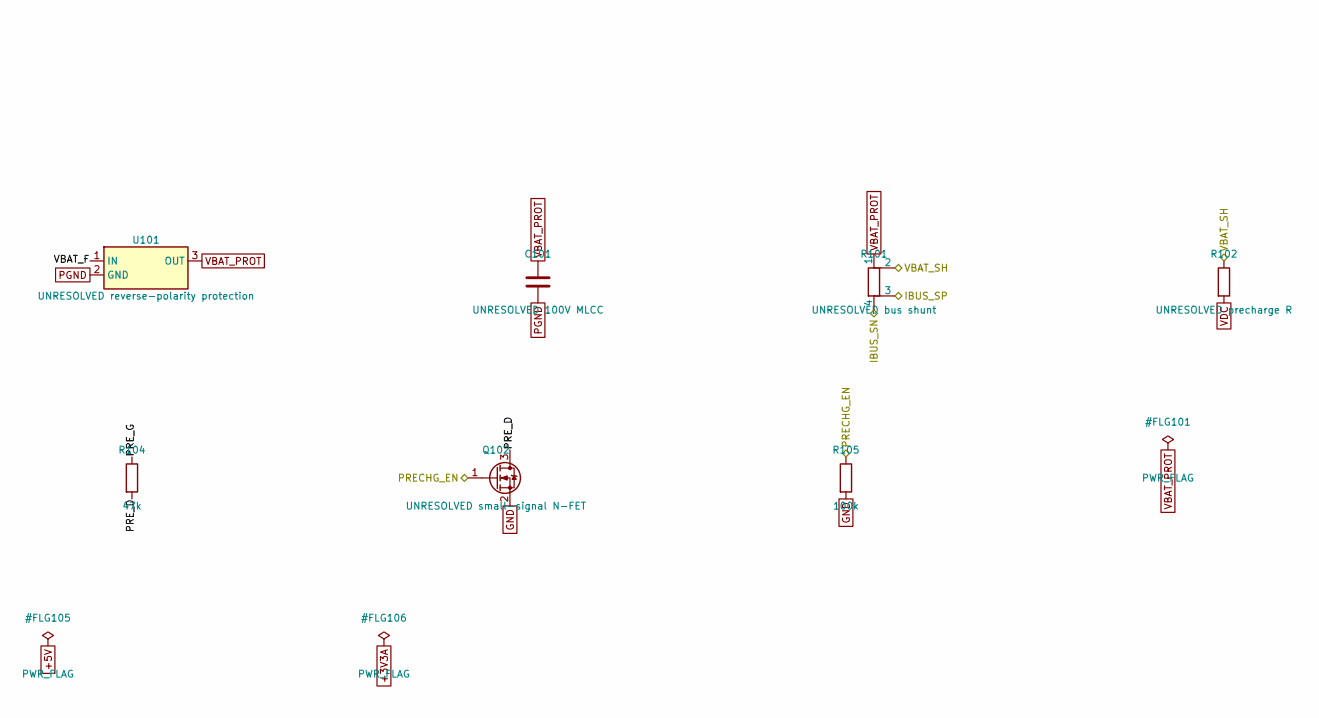
[picture p17: schematic 01_power_input.kicad_sch, part in row 1, column 2]

Parts:
C101: UNRESOLVED 100V MLCC; Rating_basis >= 1.25 x V_bat,max
D101: UNRESOLVED TVS; Rating_basis V_standoff >= V_bat,max; V_clamp at sur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
D102: 12V zener; Rating_basis clamps V_GS of the bypass FET (check V_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
F101: UNRESOLVED fuse; Rating_basis I_batt,max, V_bat,max, breaking capacit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
J101: BATTERY_IN; Rating_basis connector/cable from I_batt,max and V_b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
Q101: UNRESOLVED bypass P-FET; Rating_basis V_DS >= 1.25 x V_bat,max; continuous I_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
Q102: UNRESOLVED small-signal N-FET; Rating_basis V_DS >= 1.25 x V_bat,max (drain sees th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
R101: UNRESOLVED bus shunt; Rating_basis I_batt,max into INA228 full-scale range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
R102: UNRESOLVED precharge R; Rating_basis C_link, V_bat,max, precharge time; puls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
R103: 100k; Rating_basis gate-source hold-off
R104: 47k; Rating_basis zener current (V_bat,max-12V)/R; power 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
R105: 100k; Rating_basis bypass OFF while the MCU is in reset
U101: UNRESOLVED reverse-polarity protection; Rating_basis ideal-diode controller + N-FETs, or key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

Connections:
GND: Q102.2 (S), R105.2
IBUS_SN: R101.4
IBUS_SP: R101.3
PGND: C101.2, D101.2 (A2), J101.2, U101.2 (GND)
PRECHG_EN: Q102.1 (G), R105.1
PRE_D: Q102.3 (D), R104.2
PRE_G: D102.2 (A), Q101.1 (G), R103.2, R104.1
VBAT_F: D101.1 (A1), F101.2, U101.1 (IN)
VBAT_IN: F101.1, J101.1
VBAT_PROT: C101.1, R101.1, U101.3 (OUT)
VBAT_SH: D102.1 (K), Q101.2 (S), R101.2, R102.1, R103.1
VDC: Q101.3 (D), R102.2

Notes on the sheet:
Precharge: the bypass FET is OFF at power-up (R pull-down on PRECHG_EN, MCU pins high-Z in reset).
Firmware closes it only after V_DC >= 0.95 x V_BAT (VBUS_SENSE vs INA228 VBUS).
The vehicle e-stop isolates the battery upstream of J (vehicle hardware, not this board).
