SWORT-Aerospace/sem-motor-controller/hardware/kicad/02_dc_link.kicad_sch

## KiCad design hardware/kicad/02_dc_link.kicad_sch (2026-10-15)

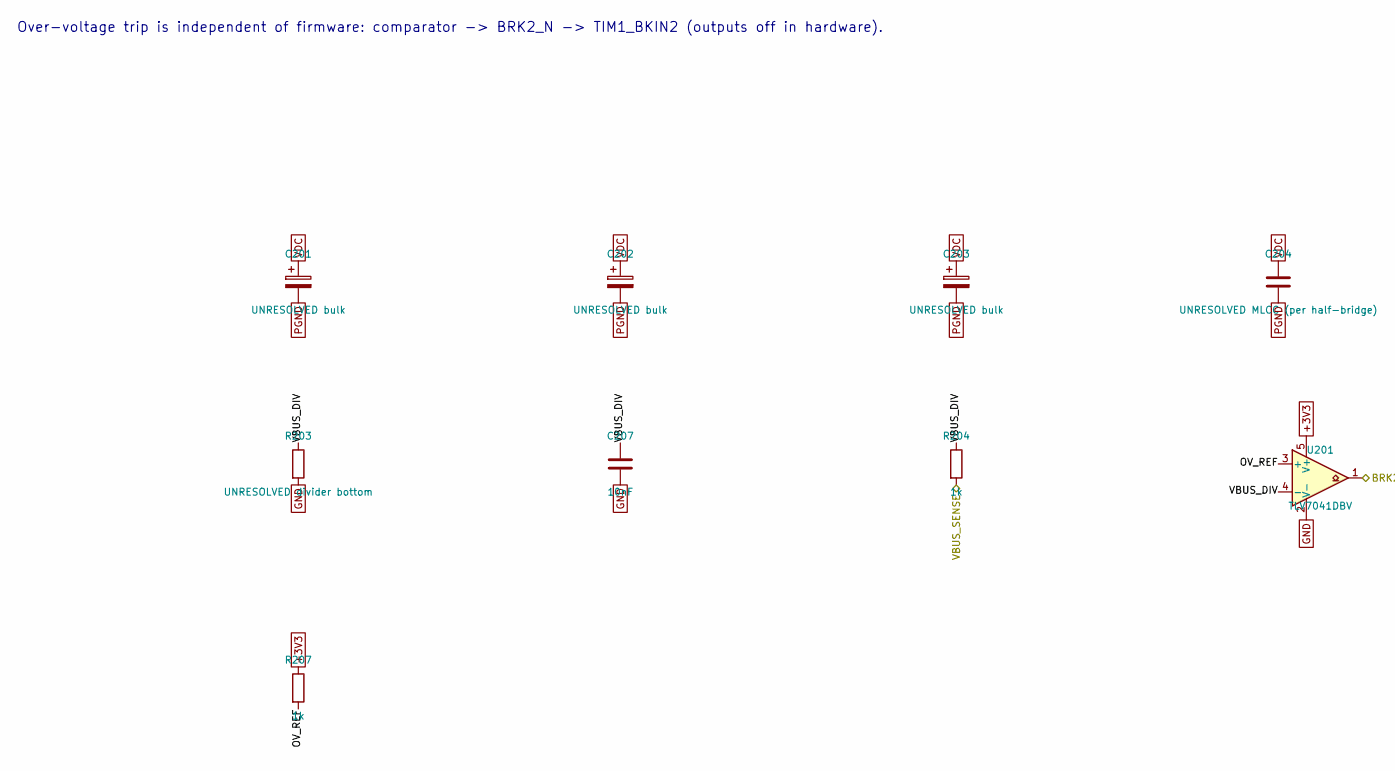
[picture p18: schematic 02_dc_link.kicad_sch, part in row 1, column 1]

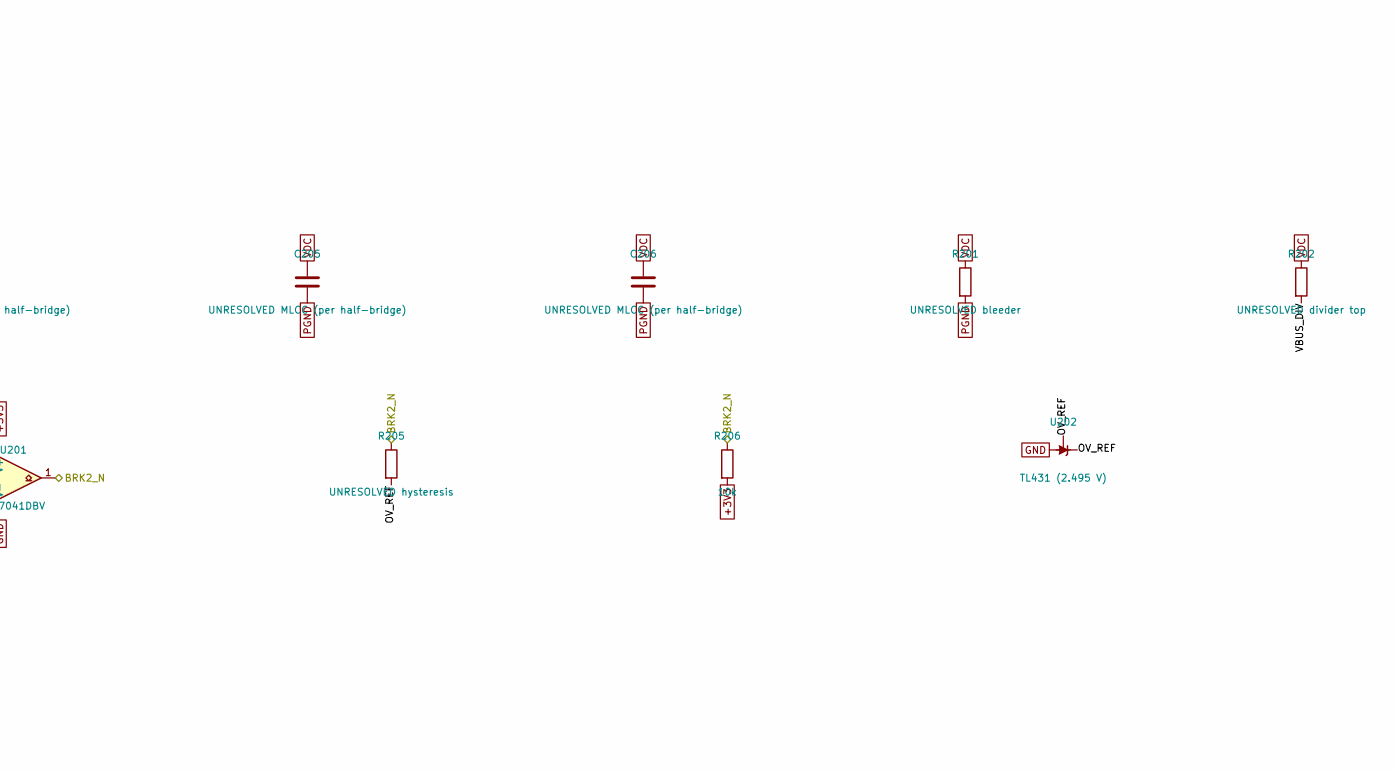
[picture p19: schematic 02_dc_link.kicad_sch, part in row 1, column 2]

Parts:
C201, C202, C203: UNRESOLVED bulk; Rating_basis ripple current (Kolar-Round at I_ph,max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
C204, C205, C206: UNRESOLVED MLCC (per half-bridge); Rating_basis >= 100 V X7R, DC-bias derated
C207: 10nF
R201: UNRESOLVED bleeder; Rating_basis discharge time vs power at V_bat,max
R202: UNRESOLVED divider top; Rating_basis ratio = 2.495 V / V_OV,trip (rule 37: F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
R203: UNRESOLVED divider bottom; Rating_basis see top
R204: 1k; Rating_basis ADC input isolation
R205: UNRESOLVED hysteresis
R206: 10k
R207: 1k; Rating_basis TL431 cathode current ~0.8 mA
U201: TLV7041DBV; Rating_basis open-drain: wired-OR into TIM1_BKIN2; MPN TLV7041DBVR
U202: TL431 (2.495 V); MPN TL431BIDBZR

Connections:
+3V3: R206.2, R207.1, U201.5 (V+)
BRK2_N: R205.1, R206.1, U201.1
GND: C207.2, R203.2, U201.2 (V-), U202.3 (A)
OV_REF: R205.2, R207.2, U201.3 (+), U202.1 (K), U202.2 (REF)
PGND: C201.2, C202.2, C203.2, C204.2, C205.2, C206.2, R201.2
VBUS_DIV: C207.1, R202.2, R203.1, R204.1, U201.4 (-)
VBUS_SENSE: R204.2
VDC: C201.1, C202.1, C203.1, C204.1, C205.1, C206.1, R201.1, R202.1

Notes on the sheet:
Over-voltage trip is independent of firmware: comparator -> BRK2_N -> TIM1_BKIN2 (outputs off in hardware).
