SWORT-Aerospace/sem-motor-controller/hardware/kicad/03_bridge.kicad_sch

## KiCad design hardware/kicad/03_bridge.kicad_sch (2026-10-15)

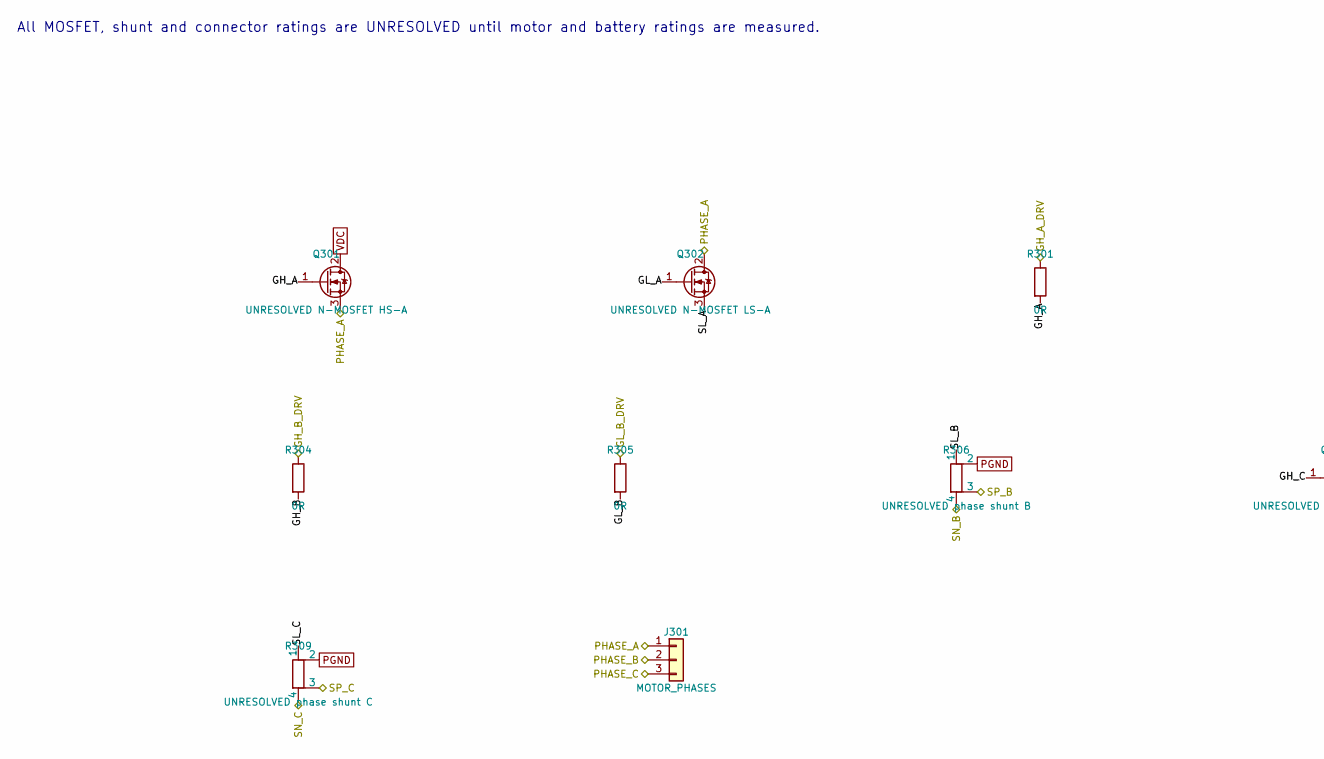
[picture p20: schematic 03_bridge.kicad_sch, part in row 1, column 1]

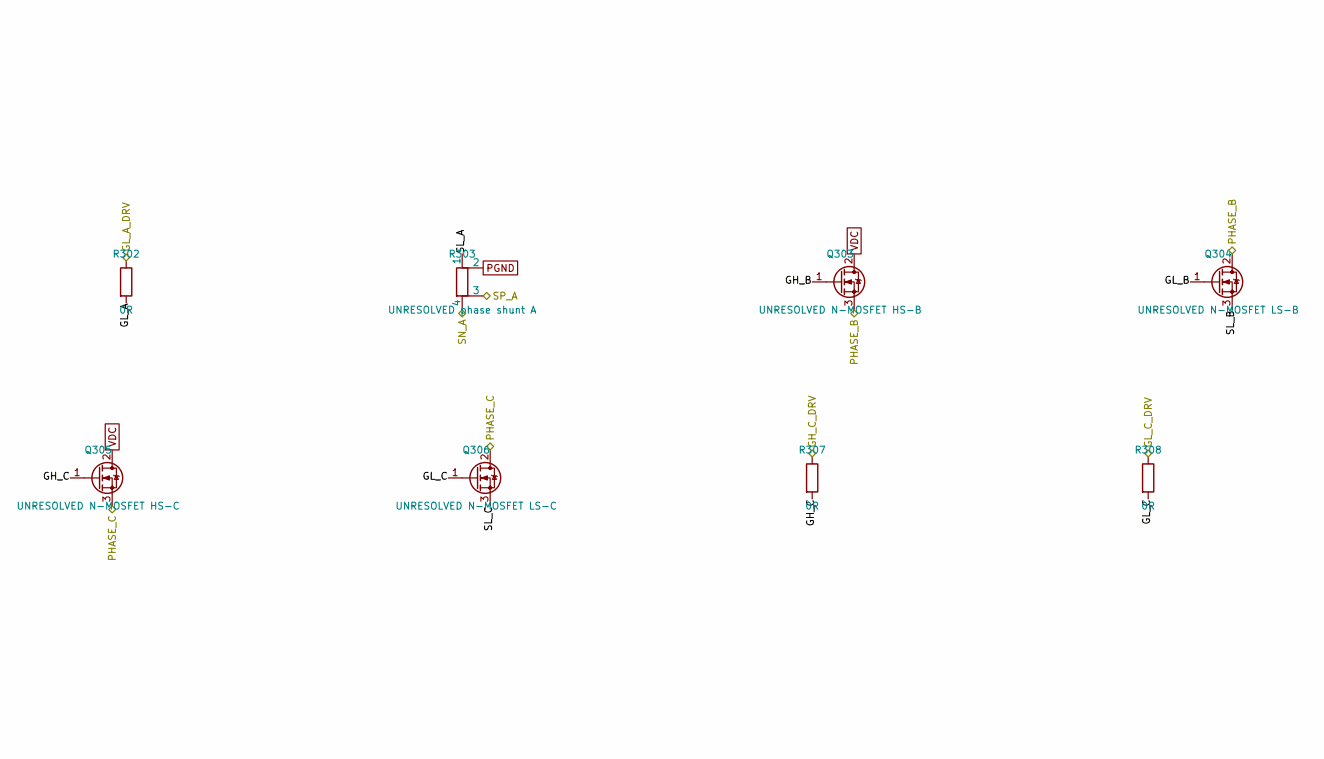
[picture p21: schematic 03_bridge.kicad_sch, part in row 1, column 2]

Parts:
J301: MOTOR_PHASES; Rating_basis I_ph,max; motor connector unknown
Q301: UNRESOLVED N-MOSFET HS-A; Rating_basis V_DS >= 1.5 x V_bat,max; I_D, R_DS(on),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
Q302: UNRESOLVED N-MOSFET LS-A; Rating_basis as HS
Q303: UNRESOLVED N-MOSFET HS-B; Rating_basis V_DS >= 1.5 x V_bat,max; I_D, R_DS(on),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
Q304: UNRESOLVED N-MOSFET LS-B; Rating_basis as HS
Q305: UNRESOLVED N-MOSFET HS-C; Rating_basis V_DS >= 1.5 x V_bat,max; I_D, R_DS(on),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
Q306: UNRESOLVED N-MOSFET LS-C; Rating_basis as HS
R301, R304, R307: 0R; Rating_basis series gate R option; IDRIVE sets slew
R302, R305, R308: 0R
R303: UNRESOLVED phase shunt A; Rating_basis I_ph,max into CSA linear range; P = I_r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
R306: UNRESOLVED phase shunt B; Rating_basis I_ph,max into CSA linear range; P = I_r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
R309: UNRESOLVED phase shunt C; Rating_basis I_ph,max into CSA linear range; P = I_r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

Connections:
GH_A: Q301.1 (G), R301.2
GH_A_DRV: R301.1
GH_B: Q303.1 (G), R304.2
GH_B_DRV: R304.1
GH_C: Q305.1 (G), R307.2
GH_C_DRV: R307.1
GL_A: Q302.1 (G), R302.2
GL_A_DRV: R302.1
GL_B: Q304.1 (G), R305.2
GL_B_DRV: R305.1
GL_C: Q306.1 (G), R308.2
GL_C_DRV: R308.1
PGND: R303.2, R306.2, R309.2
PHASE_A: J301.1, Q301.3 (S), Q302.2 (D)
PHASE_B: J301.2, Q303.3 (S), Q304.2 (D)
PHASE_C: J301.3, Q305.3 (S), Q306.2 (D)
SL_A: Q302.3 (S), R303.1
SL_B: Q304.3 (S), R306.1
SL_C: Q306.3 (S), R309.1
SN_A: R303.4
SN_B: R306.4
SN_C: R309.4
SP_A: R303.3
SP_B: R306.3
SP_C: R309.3
VDC: Q301.2 (D), Q303.2 (D), Q305.2 (D)

Notes on the sheet:
All MOSFET, shunt and connector ratings are UNRESOLVED until motor and battery ratings are measured.
