SWORT-Aerospace/sem-motor-controller/hardware/kicad/04_gate_drive.kicad_sch

## KiCad design hardware/kicad/04_gate_drive.kicad_sch (2026-10-15)

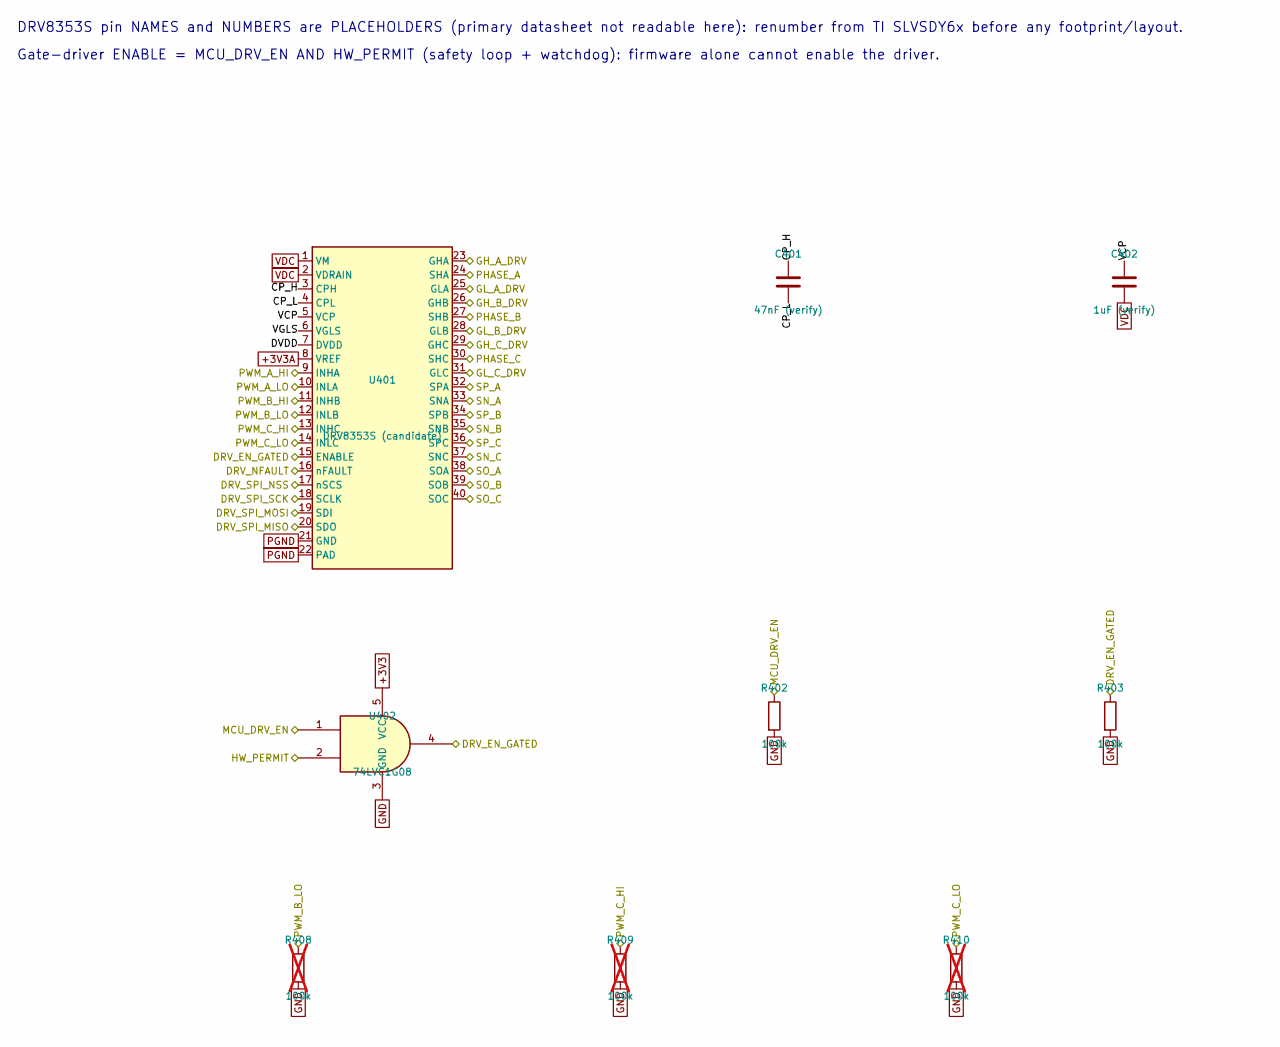
[picture p22: schematic 04_gate_drive.kicad_sch, part in row 1, column 1]

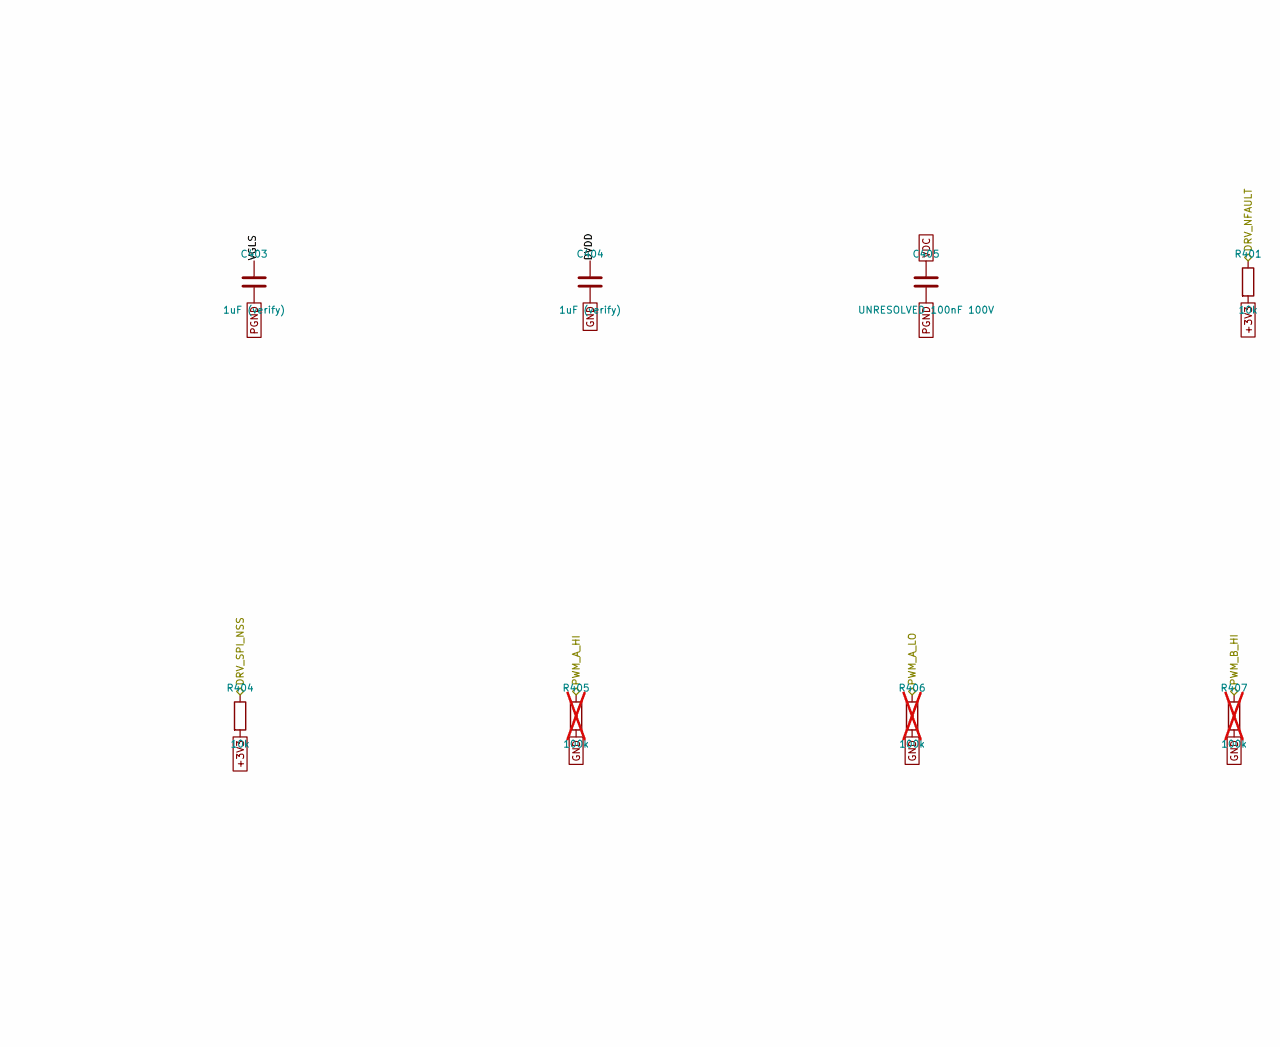
[picture p23: schematic 04_gate_drive.kicad_sch, part in row 1, column 2]

Parts:
C401: 47nF (verify); Rating_basis >= V_bat,max + 16 V
C402, C403, C404: 1uF (verify)
C405: UNRESOLVED 100nF 100V; Rating_basis VM decoupling at the driver
R401: 10k; Rating_basis open-drain nFAULT -> TIM1_BKIN + GPIO
R402: 100k; Rating_basis driver disabled while MCU pins are high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
R403: 100k; Rating_basis driver disabled if the AND gate is unpo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
R404: 10k; Rating_basis SPI deselected at boot
R405, R406, R407, R408, R409, R410: 100k; not fitted
U401: DRV8353S (candidate); MPN DRV8353SRTAR (verify)
U402: 74LVC1G08; MPN SN74LVC1G08DBVR

Connections:
+3V3: R401.2, R404.2, U402.5 (VCC)
+3V3A: U401.8 (VREF)
CP_H: C401.1, U401.3 (CPH)
CP_L: C401.2, U401.4 (CPL)
DRV_EN_GATED: R403.1, U401.15 (ENABLE), U402.4
DRV_NFAULT: R401.1, U401.16 (nFAULT)
DRV_SPI_MISO: U401.20 (SDO)
DRV_SPI_MOSI: U401.19 (SDI)
DRV_SPI_NSS: R404.1, U401.17 (nSCS)
DRV_SPI_SCK: U401.18 (SCLK)
DVDD: C404.1, U401.7 (DVDD)
GH_A_DRV: U401.23 (GHA)
GH_B_DRV: U401.26 (GHB)
GH_C_DRV: U401.29 (GHC)
GL_A_DRV: U401.25 (GLA)
GL_B_DRV: U401.28 (GLB)
GL_C_DRV: U401.31 (GLC)
GND: C404.2, R402.2, R403.2, R405.2, R406.2, R407.2, R408.2, R409.2, R410.2, U402.3 (GND)
HW_PERMIT: U402.2
MCU_DRV_EN: R402.1, U402.1
PGND: C403.2, C405.2, U401.21 (GND), U401.22 (PAD)
PHASE_A: U401.24 (SHA)
PHASE_B: U401.27 (SHB)
PHASE_C: U401.30 (SHC)
PWM_A_HI: R405.1, U401.9 (INHA)
PWM_A_LO: R406.1, U401.10 (INLA)
PWM_B_HI: R407.1, U401.11 (INHB)
PWM_B_LO: R408.1, U401.12 (INLB)
PWM_C_HI: R409.1, U401.13 (INHC)
PWM_C_LO: R410.1, U401.14 (INLC)
SN_A: U401.33 (SNA)
SN_B: U401.35 (SNB)
SN_C: U401.37 (SNC)
SO_A: U401.38 (SOA)
SO_B: U401.39 (SOB)
SO_C: U401.40 (SOC)
SP_A: U401.32 (SPA)
SP_B: U401.34 (SPB)
SP_C: U401.36 (SPC)
VCP: C402.1, U401.5 (VCP)
VDC: C402.2, C405.1, U401.1 (VM), U401.2 (VDRAIN)
VGLS: C403.1, U401.6 (VGLS)

Notes on the sheet:
DRV8353S pin NAMES and NUMBERS are PLACEHOLDERS (primary datasheet not readable here): renumber from TI SLVSDY6x before any footprint/layout.
Gate-driver ENABLE = MCU_DRV_EN AND HW_PERMIT (safety loop + watchdog): firmware alone cannot enable the driver.
