SWORT-Aerospace/sem-motor-controller/hardware/kicad/05_current_sense.kicad_sch

## KiCad design hardware/kicad/05_current_sense.kicad_sch (2026-10-15)

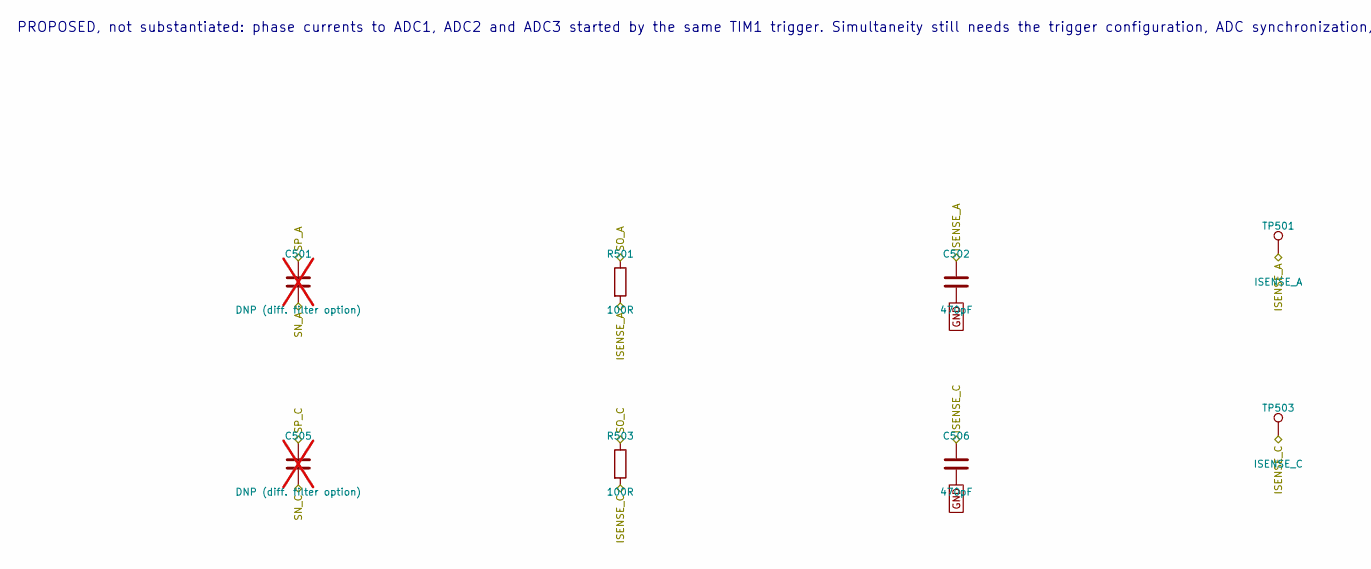
[picture p24: schematic 05_current_sense.kicad_sch, part in row 1, column 1]

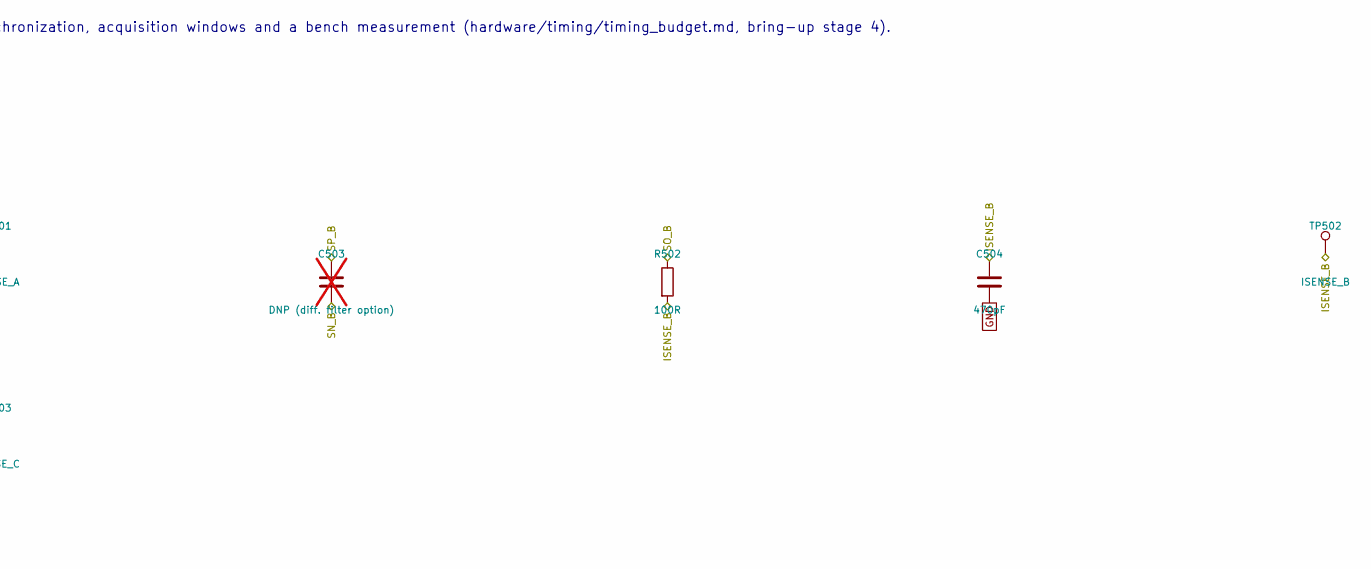
[picture p25: schematic 05_current_sense.kicad_sch, part in row 1, column 2]

Parts:
C501, C503, C505: DNP (diff. filter option); not fitted
C502, C504, C506: 470pF; Rating_basis >> ADC S/H capacitance (charge kick-bac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
R501, R502, R503: 100R; Rating_basis with 470 pF: tau = 47 ns (settling insi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
TP501: ISENSE_A
TP502: ISENSE_B
TP503: ISENSE_C

Connections:
GND: C502.2, C504.2, C506.2
ISENSE_A: C502.1, R501.2, TP501.1
ISENSE_B: C504.1, R502.2, TP502.1
ISENSE_C: C506.1, R503.2, TP503.1
SN_A: C501.2
SN_B: C503.2
SN_C: C505.2
SO_A: R501.1
SO_B: R502.1
SO_C: R503.1
SP_A: C501.1
SP_B: C503.1
SP_C: C505.1

Notes on the sheet:
PROPOSED, not substantiated: phase currents to ADC1, ADC2 and ADC3 started by the same TIM1 trigger. Simultaneity still needs the trigger configuration, ADC synchronization, acquisition windows and a bench measurement (hardware/timing/timing_budget.md, bring-up stage 4).
