SWORT-Aerospace/sem-motor-controller/hardware/kicad/06_bus_measurement.kicad_sch

## KiCad design hardware/kicad/06_bus_measurement.kicad_sch (2026-10-15)

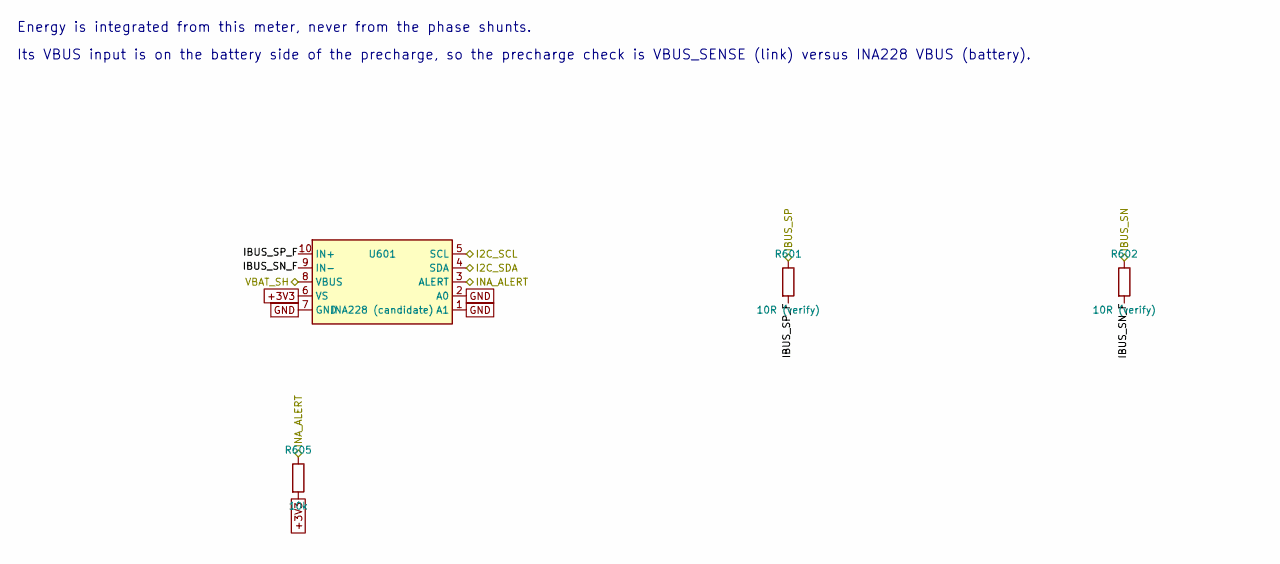
[picture p26: schematic 06_bus_measurement.kicad_sch, part in row 1, column 1]

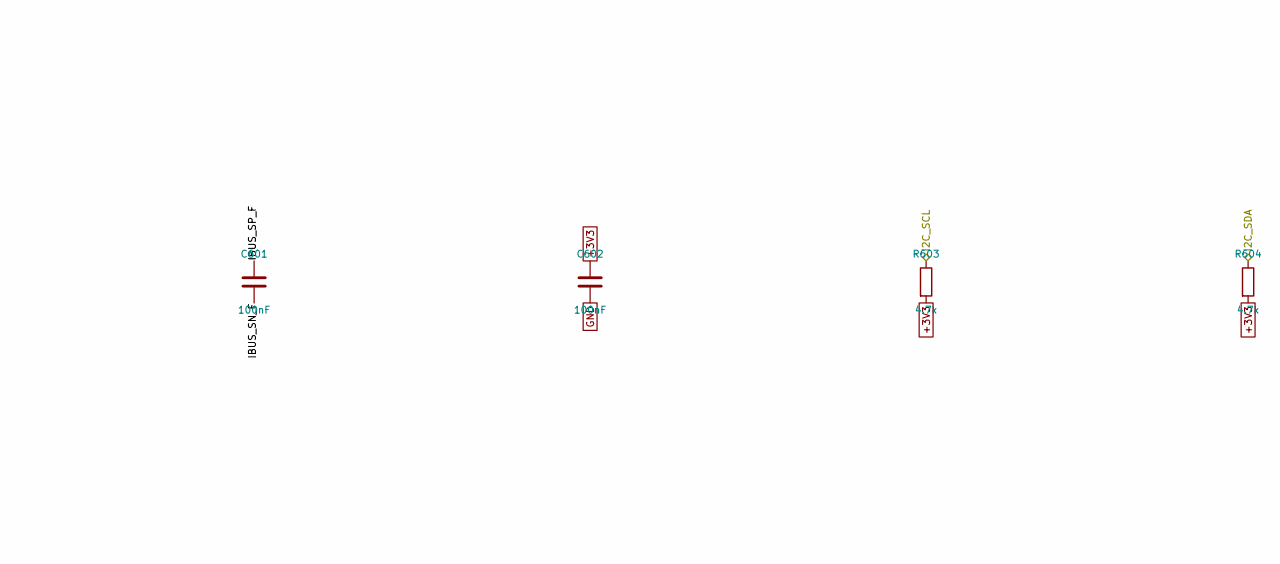
[picture p27: schematic 06_bus_measurement.kicad_sch, part in row 1, column 2]

Parts:
C601, C602: 100nF
R601, R602: 10R (verify)
R603, R604: 4.7k
R605: 10k
U601: INA228 (candidate); MPN INA228AIDGSR (verify)

Connections:
+3V3: C602.1, R603.2, R604.2, R605.2, U601.6 (VS)
GND: C602.2, U601.1 (A1), U601.2 (A0), U601.7 (GND)
I2C_SCL: R603.1, U601.5 (SCL)
I2C_SDA: R604.1, U601.4 (SDA)
IBUS_SN: R602.1
IBUS_SN_F: C601.2, R602.2, U601.9 (IN-)
IBUS_SP: R601.1
IBUS_SP_F: C601.1, R601.2, U601.10 (IN+)
INA_ALERT: R605.1, U601.3 (ALERT)
VBAT_SH: U601.8 (VBUS)

Notes on the sheet:
Energy is integrated from this meter, never from the phase shunts.
Its VBUS input is on the battery side of the precharge, so the precharge check is VBUS_SENSE (link) versus INA228 VBUS (battery).
