SWORT-Aerospace/sem-motor-controller/hardware/kicad/07_temperature.kicad_sch

## KiCad design hardware/kicad/07_temperature.kicad_sch (2026-10-15)

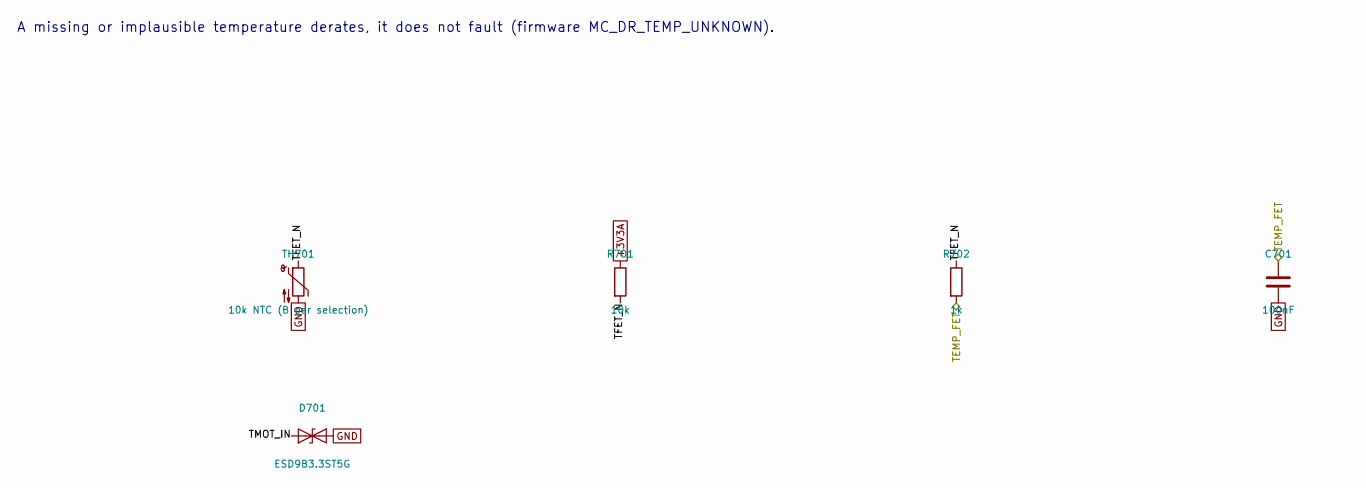
[picture p28: schematic 07_temperature.kicad_sch, part in row 1, column 1]

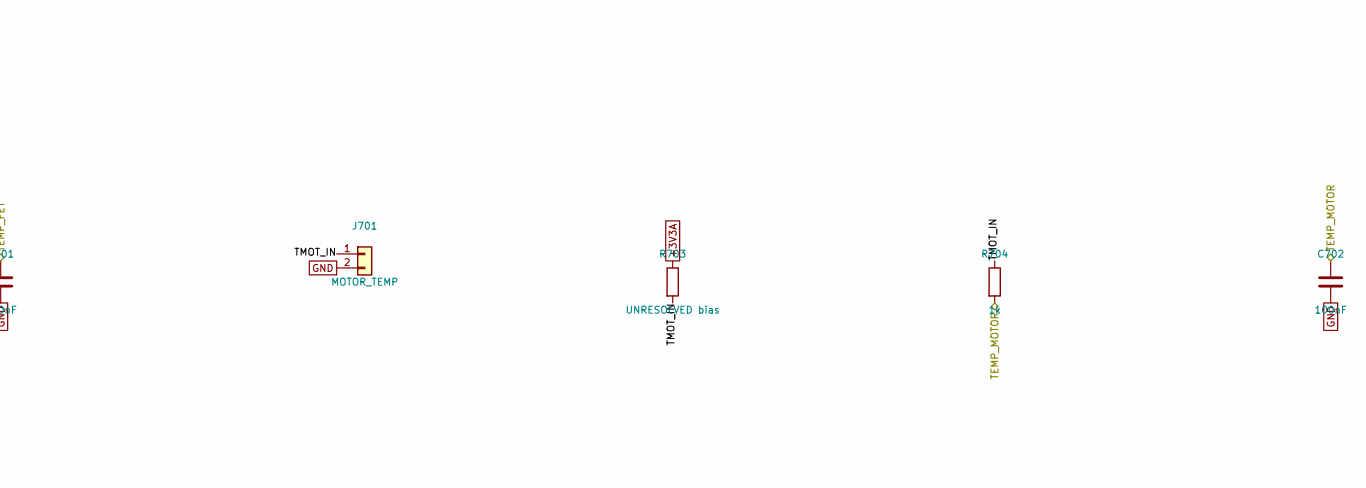
[picture p29: schematic 07_temperature.kicad_sch, part in row 1, column 2]

Parts:
C701, C702: 100nF
D701: ESD9B3.3ST5G
J701: MOTOR_TEMP; Rating_basis sensor type unknown (NTC/PTC/KTY/PT1000)
R701: 10k
R702, R704: 1k
R703: UNRESOLVED bias; Rating_basis depends on the motor's sensor
TH701: 10k NTC (B per selection); Rating_basis placed at the low-side MOSFETs

Connections:
+3V3A: R701.1, R703.1
GND: C701.2, C702.2, D701.2 (A2), J701.2, TH701.2
TEMP_FET: C701.1, R702.2
TEMP_MOTOR: C702.1, R704.2
TFET_N: R701.2, R702.1, TH701.1
TMOT_IN: D701.1 (A1), J701.1, R703.2, R704.1

Notes on the sheet:
A missing or implausible temperature derates, it does not fault (firmware MC_DR_TEMP_UNKNOWN).
