SWORT-Aerospace/sem-motor-controller/hardware/kicad/08_mcu_debug.kicad_sch

## KiCad design hardware/kicad/08_mcu_debug.kicad_sch (2026-10-15)

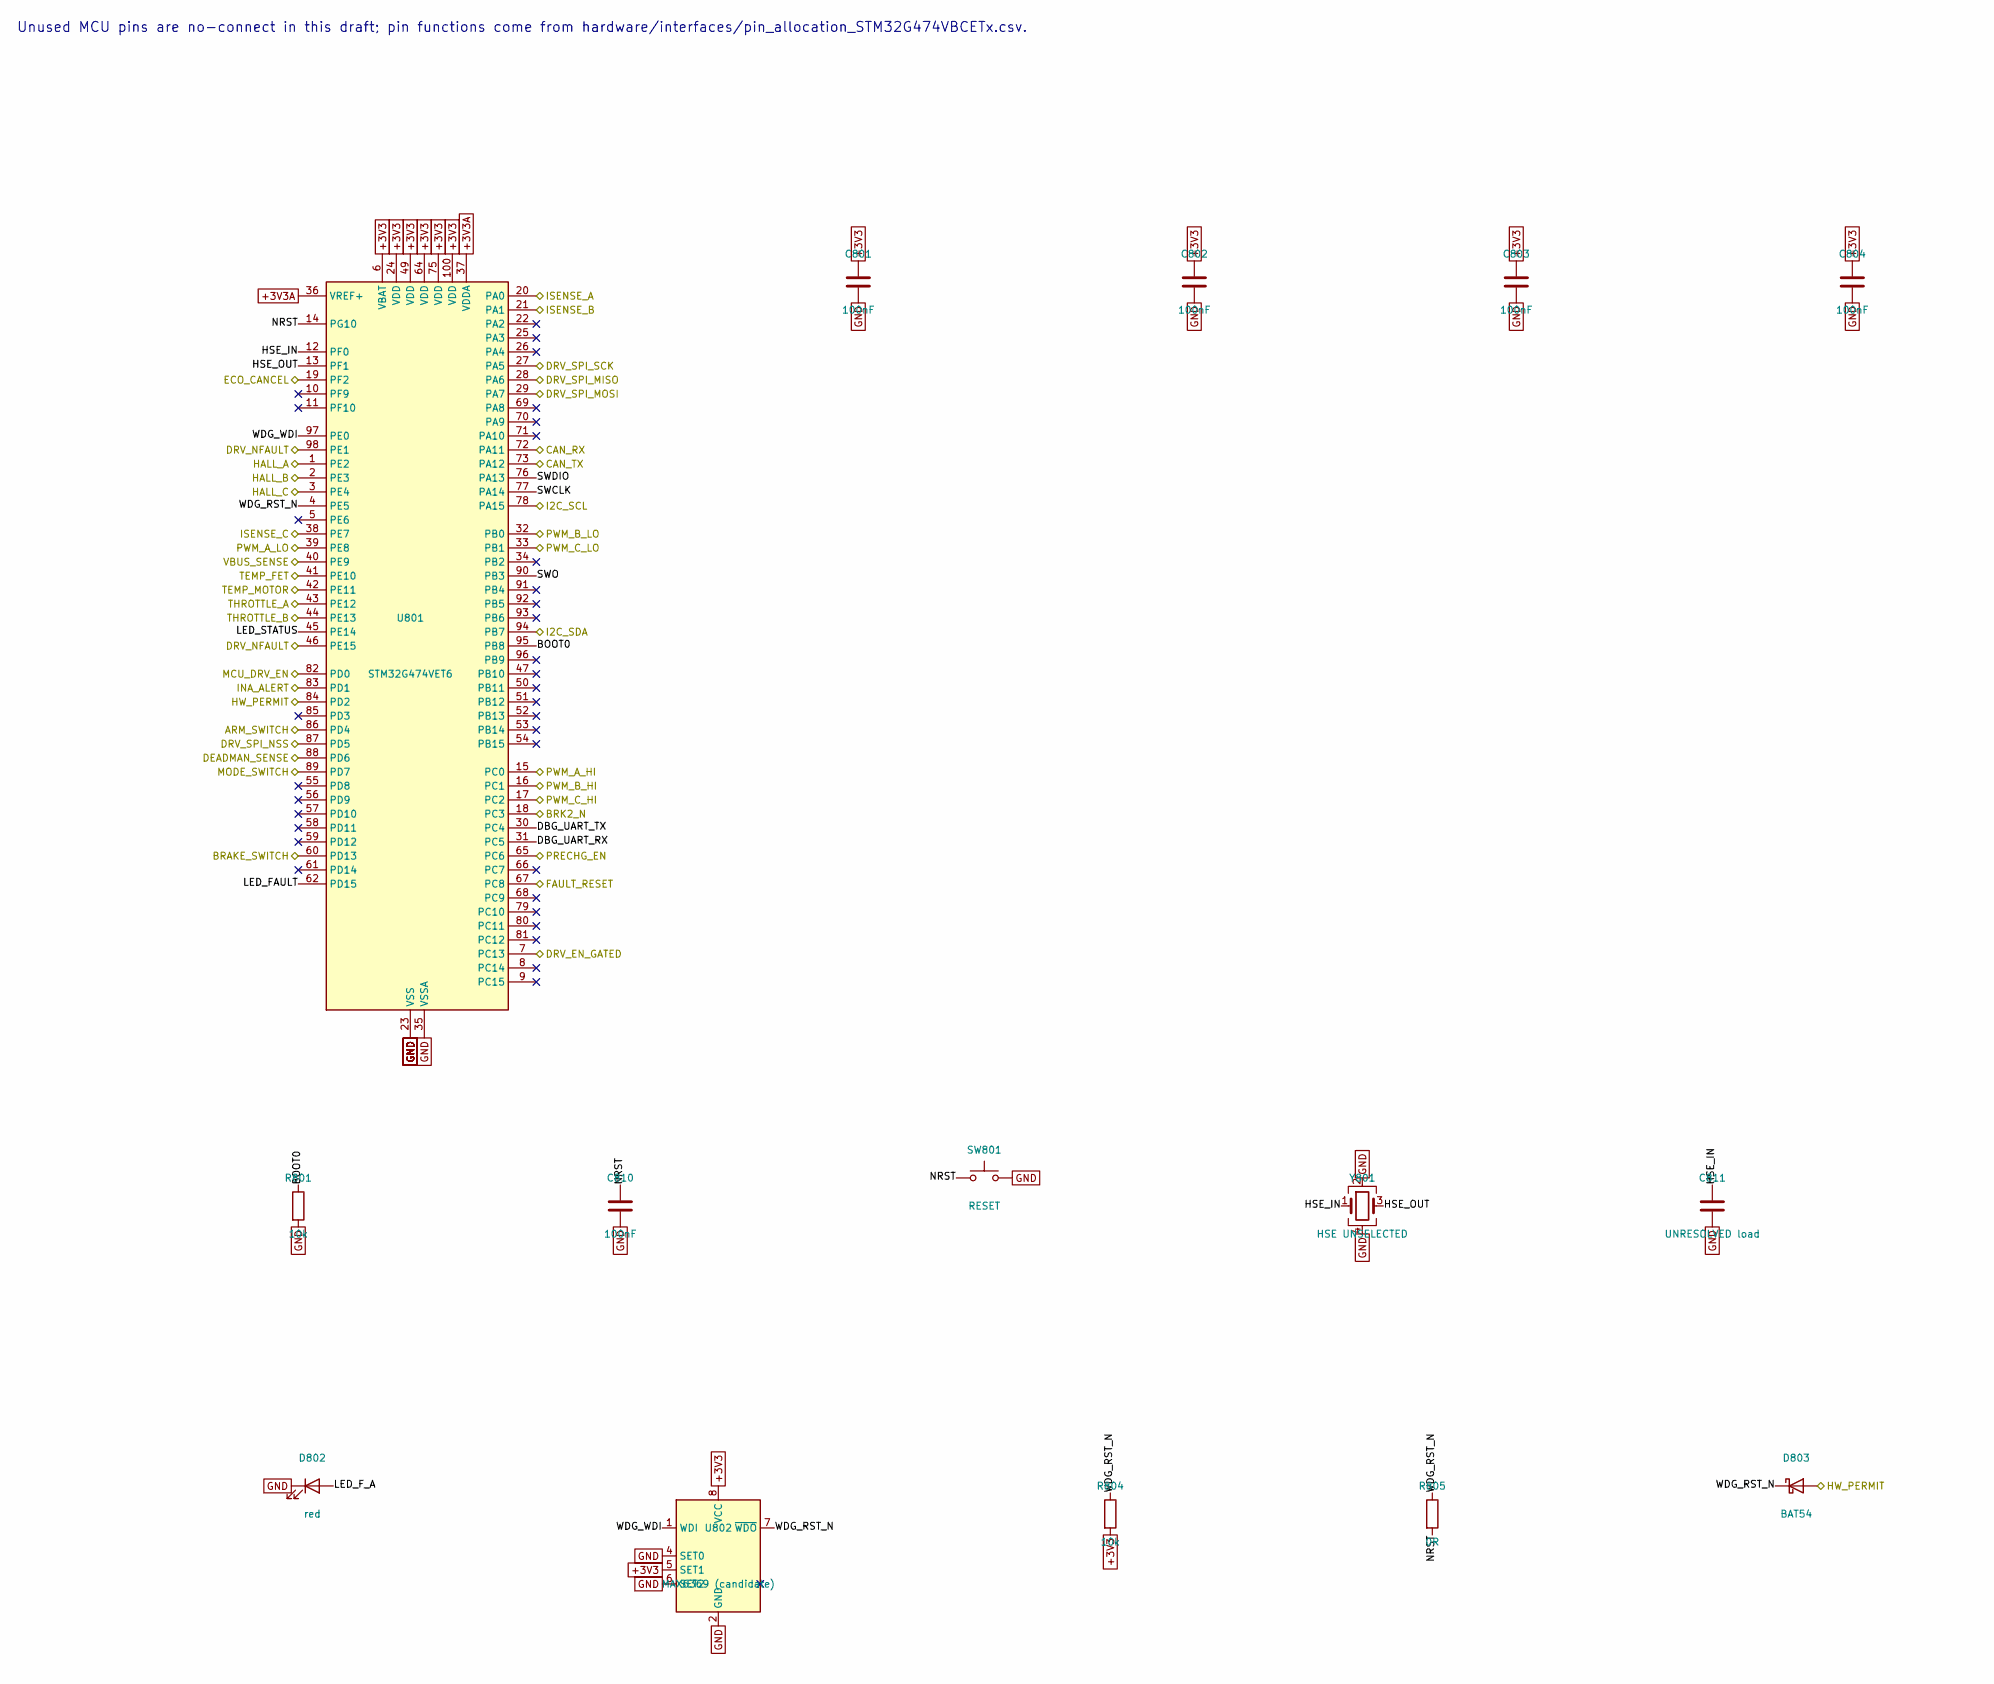
[picture p30: schematic 08_mcu_debug.kicad_sch, part in row 1, column 1]

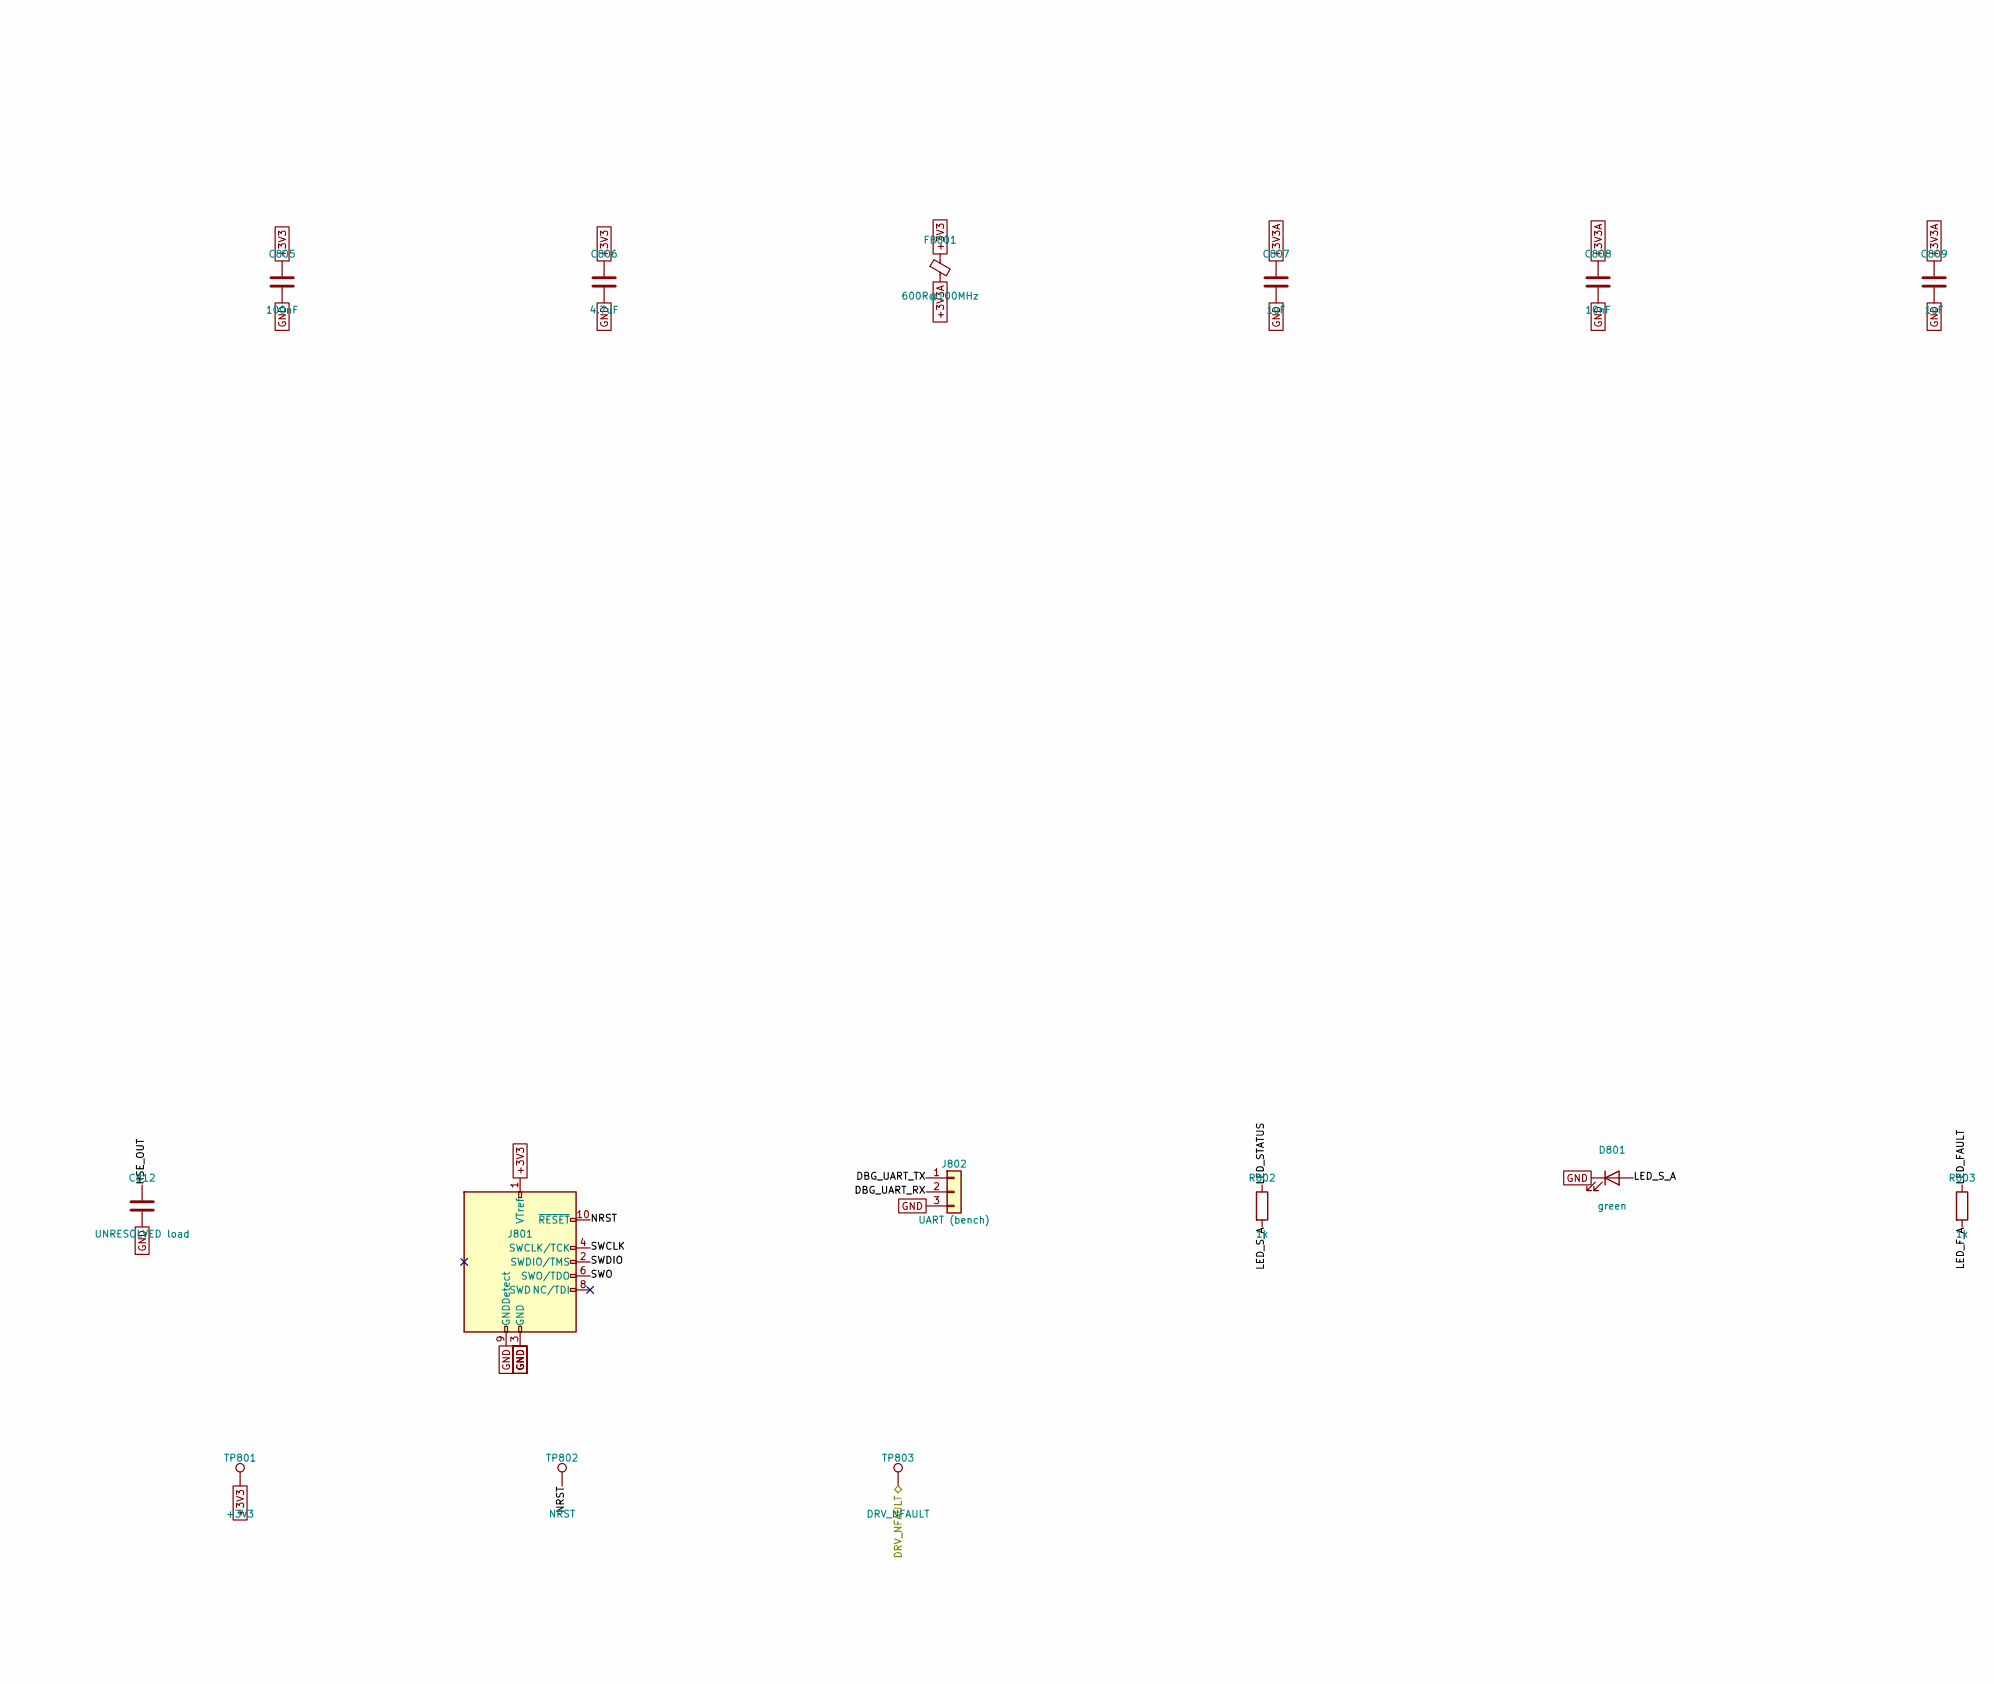
[picture p31: schematic 08_mcu_debug.kicad_sch, part in row 1, column 2]

Parts:
C801, C802, C803, C804, C805, C810: 100nF
C806: 4.7uF
C807: 1uF
C808: 10nF
C809: 1uF; Rating_basis VREF+ decoupling (ratiometric with DRV 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
C811: UNRESOLVED load; Rating_basis from the selected crystal's C_L and str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
C812: UNRESOLVED load; Rating_basis see above
D801: green
D802: red
D803: BAT54; Rating_basis watchdog timeout pulls HW_PERMIT low (d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
FB801: 600R@100MHz
J801: SWD
J802: UART (bench)
R801: 10k; Rating_basis boot from flash
R802, R803: 1k
R804: 10k
R805: 0R; Rating_basis watchdog resets the MCU
SW801: RESET
TP801: +3V3
TP802: NRST
TP803: DRV_NFAULT
U801: STM32G474VET6; MPN STM32G474VET6
U802: MAX6369 (candidate); MPN MAX6369KA+T
Y801: HSE UNSELECTED; Rating_basis frequency NOT selected: depends on the 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

Connections:
+3V3: C801.1, C802.1, C803.1, C804.1, C805.1, C806.1, FB801.1, J801.1 (VTref), R804.2, TP801.1, U801.6 (VBAT), U801.24 (VDD), U801.49 (VDD), U801.64 (VDD), U801.75 (VDD), U801.100 (VDD), U802.5 (SET1), U802.8 (VCC)
+3V3A: C807.1, C808.1, C809.1, FB801.2, U801.36 (VREF+), U801.37 (VDDA)
ARM_SWITCH: U801.86 (PD4)
BOOT0: R801.1, U801.95 (PB8)
BRAKE_SWITCH: U801.60 (PD13)
BRK2_N: U801.18 (PC3)
CAN_RX: U801.72 (PA11)
CAN_TX: U801.73 (PA12)
DBG_UART_RX: J802.2, U801.31 (PC5)
DBG_UART_TX: J802.1, U801.30 (PC4)
DEADMAN_SENSE: U801.88 (PD6)
DRV_EN_GATED: U801.7 (PC13)
DRV_NFAULT: TP803.1, U801.46 (PE15), U801.98 (PE1)
DRV_SPI_MISO: U801.28 (PA6)
DRV_SPI_MOSI: U801.29 (PA7)
DRV_SPI_NSS: U801.87 (PD5)
DRV_SPI_SCK: U801.27 (PA5)
ECO_CANCEL: U801.19 (PF2)
FAULT_RESET: U801.67 (PC8)
GND: C801.2, C802.2, C803.2, C804.2, C805.2, C806.2, C807.2, C808.2, C809.2, C810.2, C811.2, C812.2, D801.1 (K), D802.1 (K), J801.3 (GND), J801.5 (GND), J801.9 (GNDDetect), J802.3, R801.2, SW801.2, U801.23 (VSS), U801.35 (VSSA), U801.48 (VSS), U801.63 (VSS), U801.74 (VSS), U801.99 (VSS), U802.2 (GND), U802.4 (SET0), U802.6 (SET2), Y801.2, Y801.4
HALL_A: U801.1 (PE2)
HALL_B: U801.2 (PE3)
HALL_C: U801.3 (PE4)
HSE_IN: C811.1, U801.12 (PF0), Y801.1
HSE_OUT: C812.1, U801.13 (PF1), Y801.3
HW_PERMIT: D803.2 (A), U801.84 (PD2)
I2C_SCL: U801.78 (PA15)
I2C_SDA: U801.94 (PB7)
INA_ALERT: U801.83 (PD1)
ISENSE_A: U801.20 (PA0)
ISENSE_B: U801.21 (PA1)
ISENSE_C: U801.38 (PE7)
LED_FAULT: R803.1, U801.62 (PD15)
LED_F_A: D802.2 (A), R803.2
LED_STATUS: R802.1, U801.45 (PE14)
LED_S_A: D801.2 (A), R802.2
MCU_DRV_EN: U801.82 (PD0)
MODE_SWITCH: U801.89 (PD7)
NRST: C810.1, J801.10 (~RESET), R805.2, SW801.1, TP802.1, U801.14 (PG10)
PRECHG_EN: U801.65 (PC6)
PWM_A_HI: U801.15 (PC0)
PWM_A_LO: U801.39 (PE8)
PWM_B_HI: U801.16 (PC1)
PWM_B_LO: U801.32 (PB0)
PWM_C_HI: U801.17 (PC2)
PWM_C_LO: U801.33 (PB1)
SWCLK: J801.4 (SWCLK/TCK), U801.77 (PA14)
SWDIO: J801.2 (SWDIO/TMS), U801.76 (PA13)
SWO: J801.6 (SWO/TDO), U801.90 (PB3)
TEMP_FET: U801.41 (PE10)
TEMP_MOTOR: U801.42 (PE11)
THROTTLE_A: U801.43 (PE12)
THROTTLE_B: U801.44 (PE13)
VBUS_SENSE: U801.40 (PE9)
WDG_RST_N: D803.1 (K), R804.1, R805.1, U801.4 (PE5), U802.7 (~WDO)
WDG_WDI: U801.97 (PE0), U802.1 (WDI)

Notes on the sheet:
Unused MCU pins are no-connect in this draft; pin functions come from hardware/interfaces/pin_allocation_STM32G474VBCETx.csv.
