SWORT-Aerospace/sem-motor-controller/hardware/kicad/09_hall_inputs.kicad_sch

## KiCad design hardware/kicad/09_hall_inputs.kicad_sch (2026-10-15)

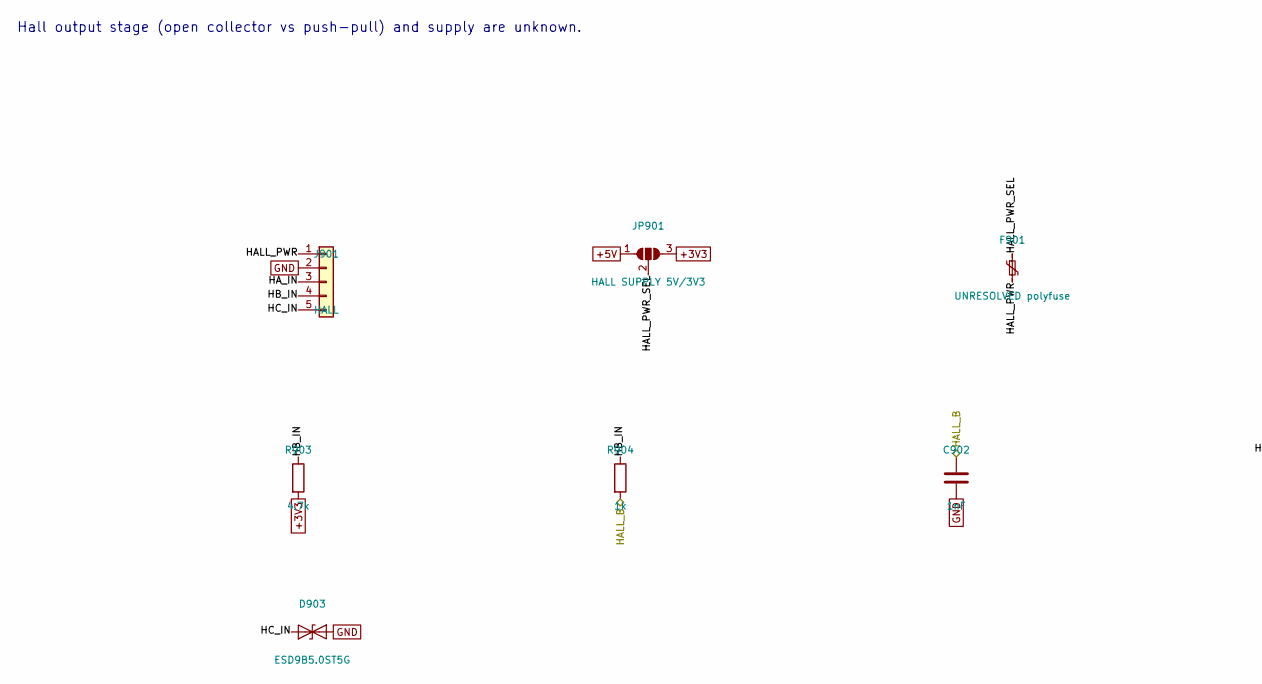
[picture p32: schematic 09_hall_inputs.kicad_sch, part in row 1, column 1]

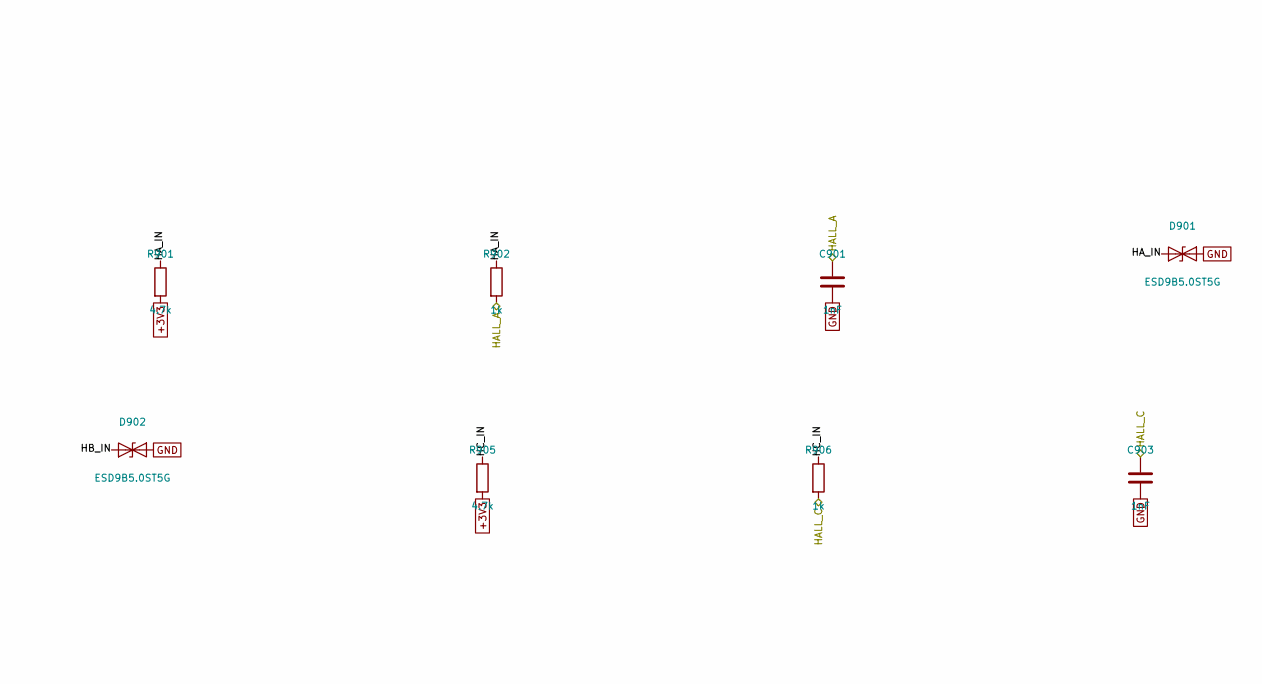
[picture p33: schematic 09_hall_inputs.kicad_sch, part in row 1, column 2]

Parts:
C901, C902, C903: 1nF; Rating_basis tau = 1 us
D901, D902, D903: ESD9B5.0ST5G
F901: UNRESOLVED polyfuse; Rating_basis hall supply current unknown
J901: HALL; Rating_basis motor hall connector unknown
JP901: HALL SUPPLY 5V/3V3; Rating_basis hall sensor supply voltage unknown
R901, R903, R905: 4.7k; Rating_basis assumes open-collector hall outputs (ve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
R902, R904, R906: 1k

Connections:
+3V3: JP901.3 (B), R901.2, R903.2, R905.2
+5V: JP901.1 (A)
GND: C901.2, C902.2, C903.2, D901.2 (A2), D902.2 (A2), D903.2 (A2), J901.2
HALL_A: C901.1, R902.2
HALL_B: C902.1, R904.2
HALL_C: C903.1, R906.2
HALL_PWR: F901.2, J901.1
HALL_PWR_SEL: F901.1, JP901.2 (C)
HA_IN: D901.1 (A1), J901.3, R901.1, R902.1
HB_IN: D902.1 (A1), J901.4, R903.1, R904.1
HC_IN: D903.1 (A1), J901.5, R905.1, R906.1

Notes on the sheet:
Hall output stage (open collector vs push-pull) and supply are unknown.
