SWORT-Aerospace/sem-motor-controller/hardware/kicad/10_driver_controls.kicad_sch

## KiCad design hardware/kicad/10_driver_controls.kicad_sch (2026-10-15)

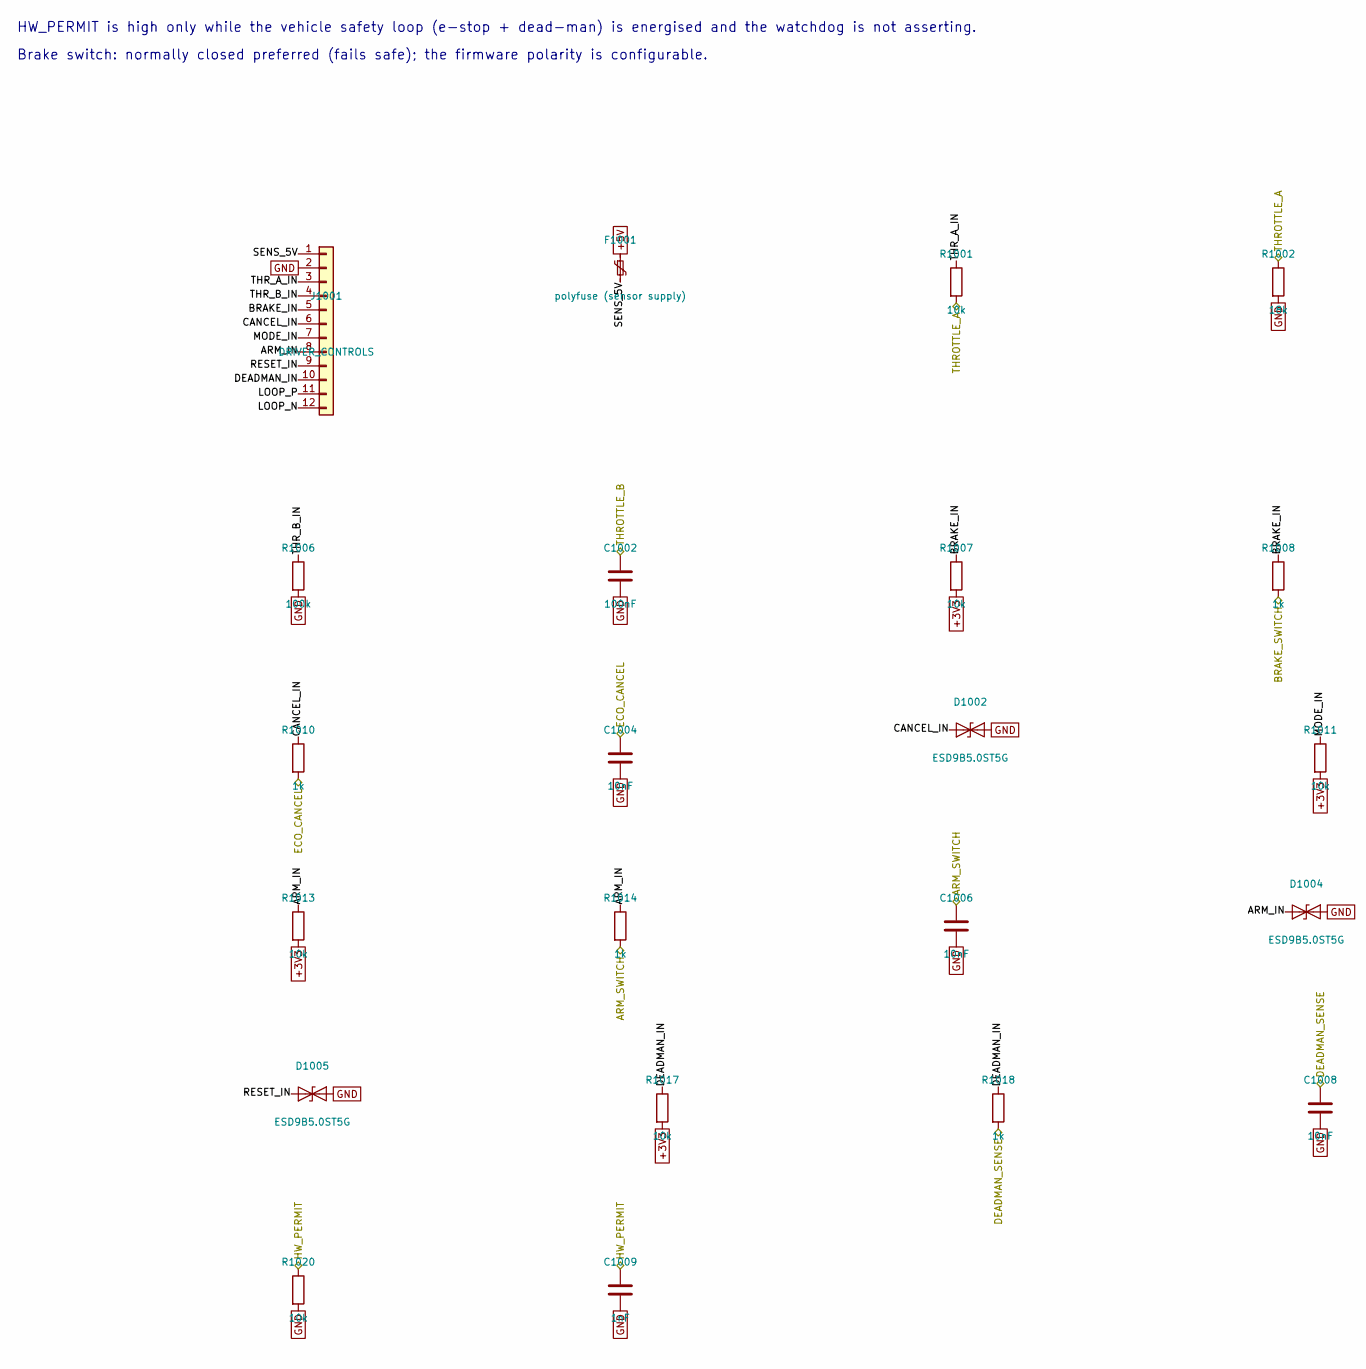
[picture p34: schematic 10_driver_controls.kicad_sch, part in row 1, column 1]

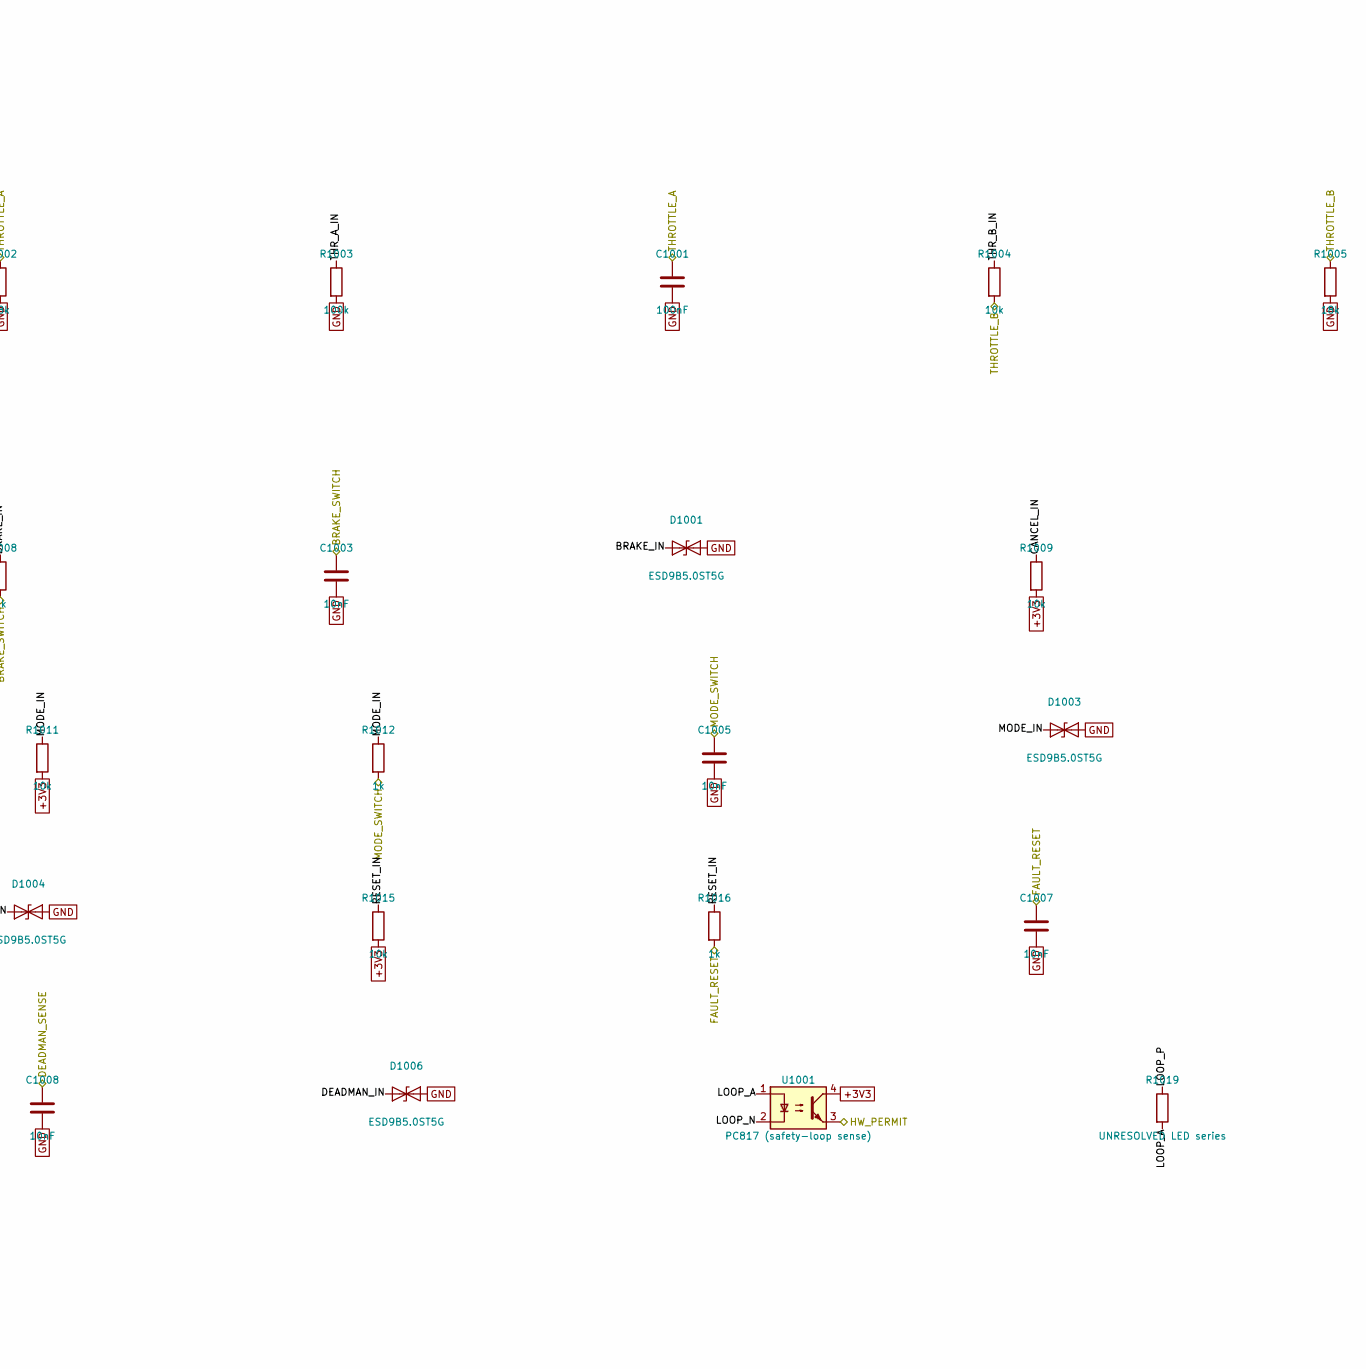
[picture p35: schematic 10_driver_controls.kicad_sch, part in row 1, column 2]

Parts:
C1001, C1002: 100nF
C1003, C1004, C1005, C1006, C1007, C1008: 10nF
C1009: 1nF
D1001, D1002, D1003, D1004, D1005, D1006: ESD9B5.0ST5G
F1001: polyfuse (sensor supply)
J1001: DRIVER_CONTROLS; Rating_basis vehicle harness connector unknown
R1001, R1004, R1007, R1009, R1011, R1013, R1015, R1017: 10k
R1002, R1005: 18k; Rating_basis 5 V -> 3.21 V
R1003, R1006: 100k; Rating_basis open wire reads 0 -> implausible
R1008, R1010, R1012, R1014, R1016, R1018: 1k
R1019: UNRESOLVED LED series; Rating_basis safety-loop voltage unknown (I_F ~ 5 mA)
R1020: 10k; Rating_basis HW_PERMIT low unless the loop is energi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
U1001: PC817 (safety-loop sense)

Connections:
+3V3: R1007.2, R1009.2, R1011.2, R1013.2, R1015.2, R1017.2, U1001.4
+5V: F1001.1
ARM_IN: D1004.1 (A1), J1001.8, R1013.1, R1014.1
ARM_SWITCH: C1006.1, R1014.2
BRAKE_IN: D1001.1 (A1), J1001.5, R1007.1, R1008.1
BRAKE_SWITCH: C1003.1, R1008.2
CANCEL_IN: D1002.1 (A1), J1001.6, R1009.1, R1010.1
DEADMAN_IN: D1006.1 (A1), J1001.10, R1017.1, R1018.1
DEADMAN_SENSE: C1008.1, R1018.2
ECO_CANCEL: C1004.1, R1010.2
FAULT_RESET: C1007.1, R1016.2
GND: C1001.2, C1002.2, C1003.2, C1004.2, C1005.2, C1006.2, C1007.2, C1008.2, C1009.2, D1001.2 (A2), D1002.2 (A2), D1003.2 (A2), D1004.2 (A2), D1005.2 (A2), D1006.2 (A2), J1001.2, R1002.2, R1003.2, R1005.2, R1006.2, R1020.2
HW_PERMIT: C1009.1, R1020.1, U1001.3
LOOP_A: R1019.2, U1001.1
LOOP_N: J1001.12, U1001.2
LOOP_P: J1001.11, R1019.1
MODE_IN: D1003.1 (A1), J1001.7, R1011.1, R1012.1
MODE_SWITCH: C1005.1, R1012.2
RESET_IN: D1005.1 (A1), J1001.9, R1015.1, R1016.1
SENS_5V: F1001.2, J1001.1
THROTTLE_A: C1001.1, R1001.2, R1002.1
THROTTLE_B: C1002.1, R1004.2, R1005.1
THR_A_IN: J1001.3, R1001.1, R1003.1
THR_B_IN: J1001.4, R1004.1, R1006.1

Notes on the sheet:
HW_PERMIT is high only while the vehicle safety loop (e-stop + dead-man) is energised and the watchdog is not asserting.
Brake switch: normally closed preferred (fails safe); the firmware polarity is configurable.
