SWORT-Aerospace/sem-motor-controller/hardware/kicad/11_can_phy.kicad_sch

## KiCad design hardware/kicad/11_can_phy.kicad_sch (2026-10-15)

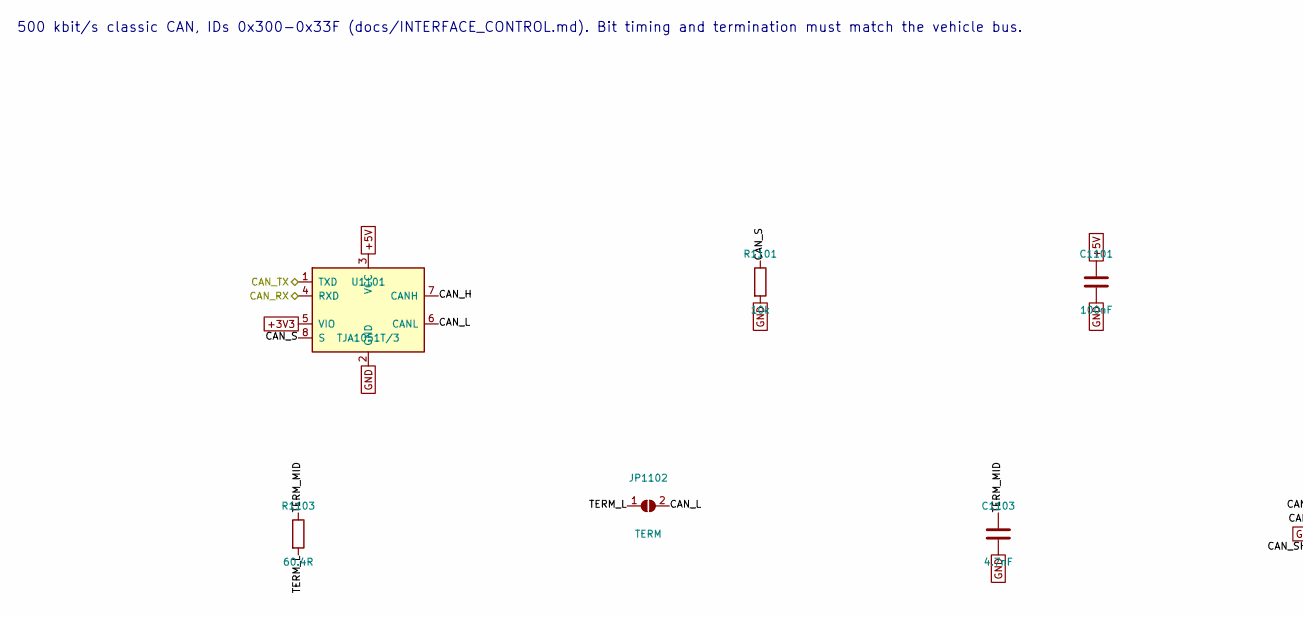
[picture p36: schematic 11_can_phy.kicad_sch, part in row 1, column 1]

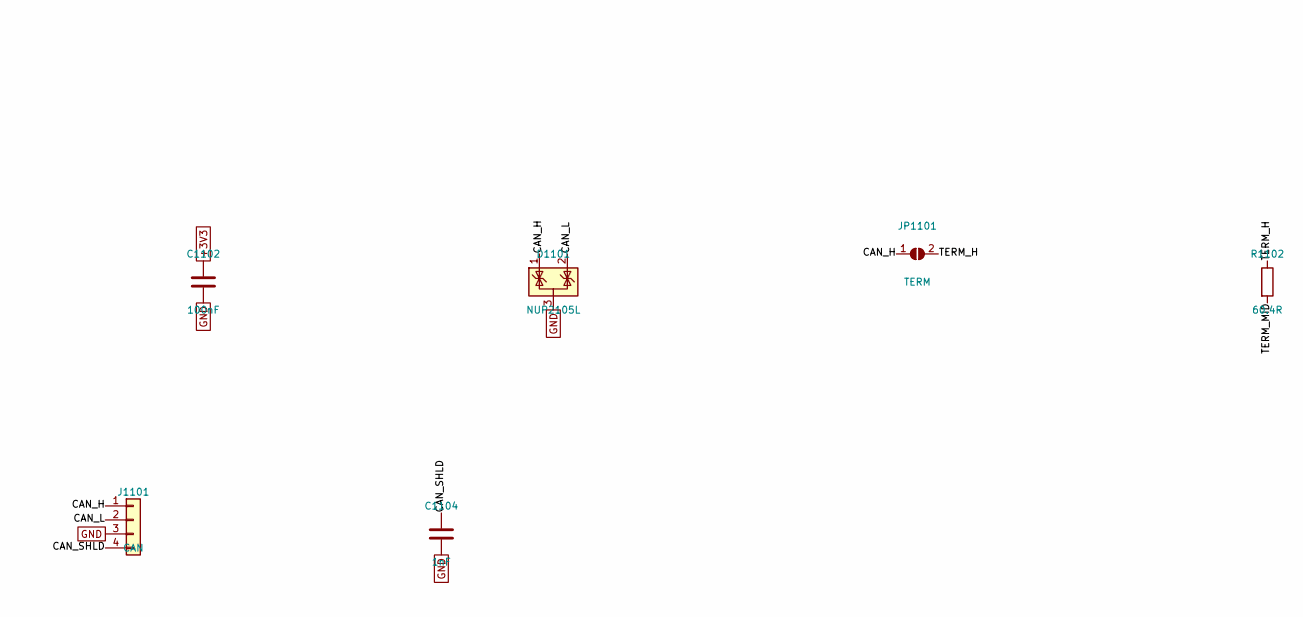
[picture p37: schematic 11_can_phy.kicad_sch, part in row 1, column 2]

Parts:
C1101, C1102: 100nF
C1103: 4.7nF; Rating_basis split termination
C1104: 1nF; Rating_basis shield termination per harness
D1101: NUP2105L
J1101: CAN; Rating_basis vehicle CAN harness connector, pinout a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
JP1101: TERM; Rating_basis close only if this node is a bus end (h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
JP1102: TERM
R1101: 10k; Rating_basis normal (not silent) mode
R1102, R1103: 60.4R
U1101: TJA1051T/3; MPN TJA1051T/3/1J

Connections:
+3V3: C1102.1, U1101.5 (VIO)
+5V: C1101.1, U1101.3 (VCC)
CAN_H: D1101.1 (K), J1101.1, JP1101.1 (A), U1101.7 (CANH)
CAN_L: D1101.2 (K), J1101.2, JP1102.2 (B), U1101.6 (CANL)
CAN_RX: U1101.4 (RXD)
CAN_S: R1101.1, U1101.8 (S)
CAN_SHLD: C1104.1, J1101.4
CAN_TX: U1101.1 (TXD)
GND: C1101.2, C1102.2, C1103.2, C1104.2, D1101.3 (A), J1101.3, R1101.2, U1101.2 (GND)
TERM_H: JP1101.2 (B), R1102.1
TERM_L: JP1102.1 (A), R1103.2
TERM_MID: C1103.1, R1102.2, R1103.1

Notes on the sheet:
500 kbit/s classic CAN, IDs 0x300-0x33F (docs/INTERFACE_CONTROL.md). Bit timing and termination must match the vehicle bus.
