SWORT-Aerospace/sem-motor-controller/hardware/kicad/12_aux_rails.kicad_sch

## KiCad design hardware/kicad/12_aux_rails.kicad_sch (2026-10-15)

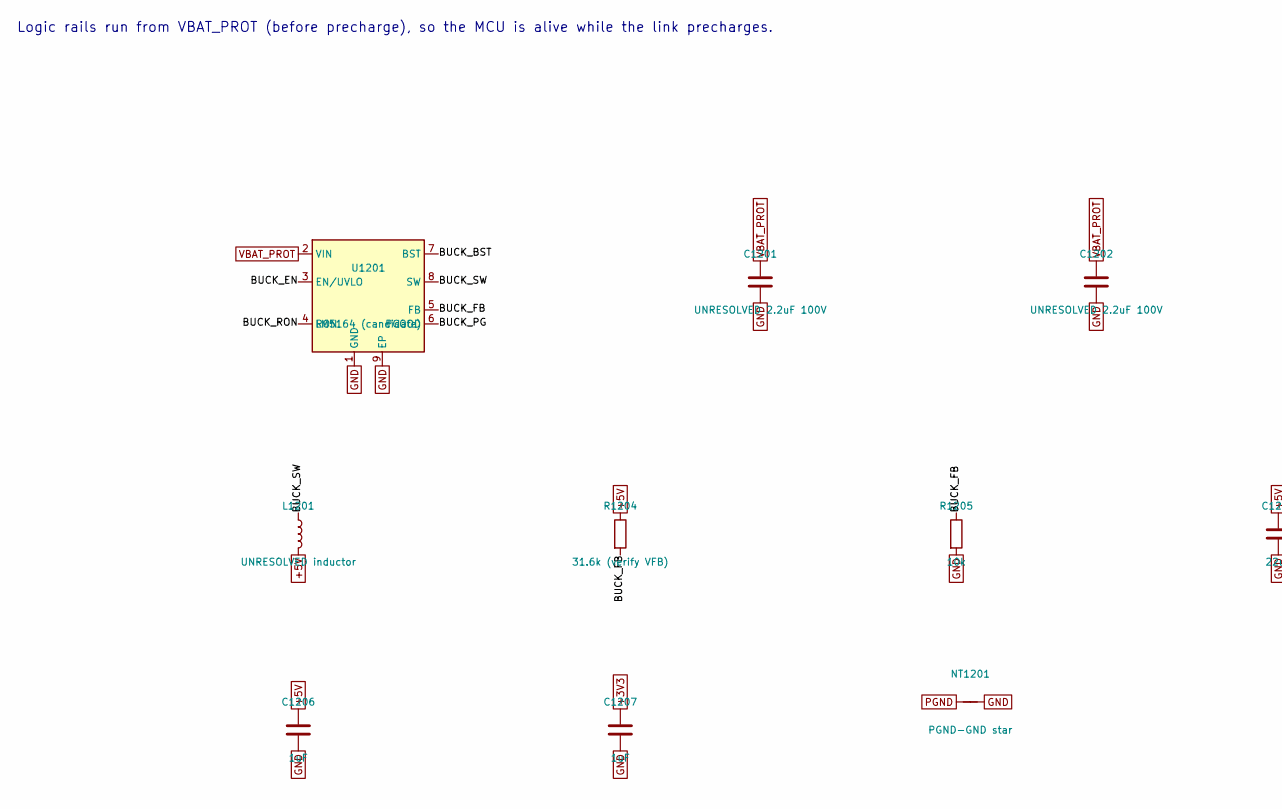
[picture p38: schematic 12_aux_rails.kicad_sch, part in row 1, column 1]

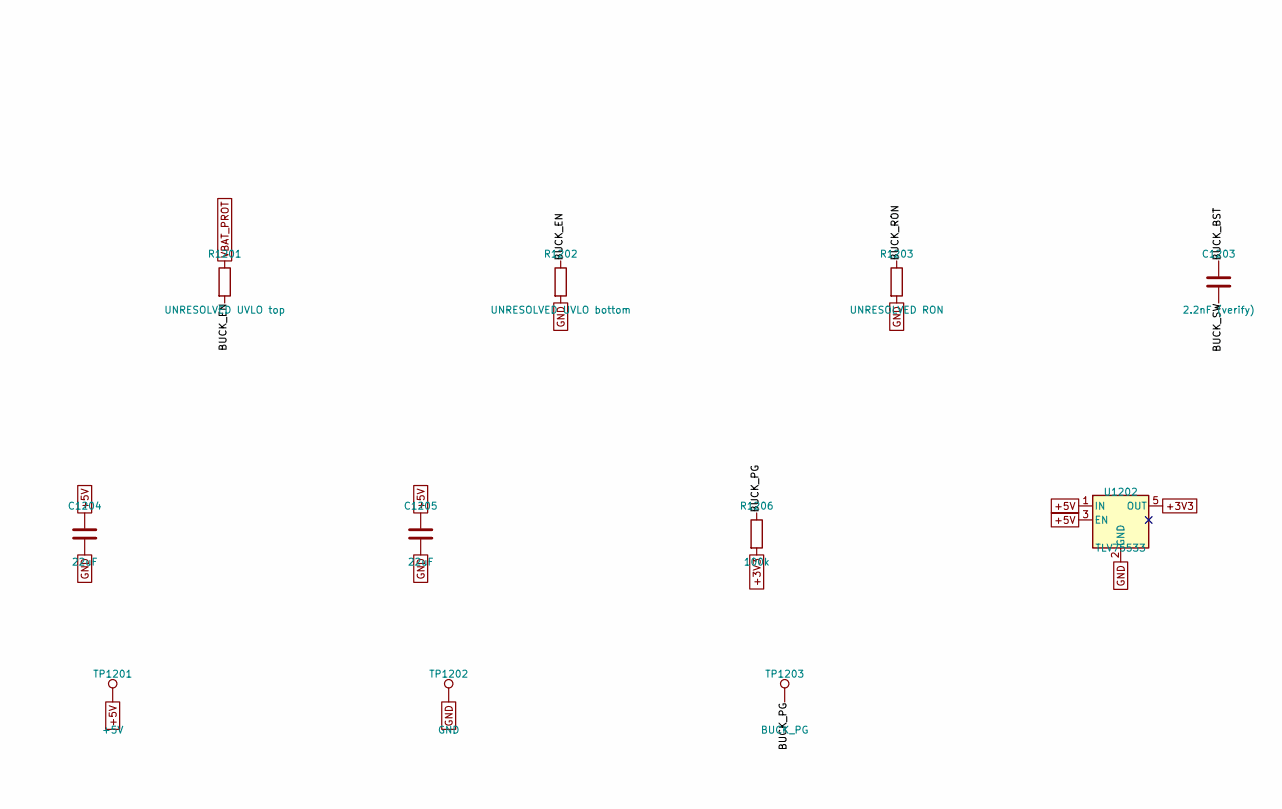
[picture p39: schematic 12_aux_rails.kicad_sch, part in row 1, column 2]

Parts:
C1201: UNRESOLVED 2.2uF 100V; Rating_basis >= 1.25 x V_bat,max
C1202: UNRESOLVED 2.2uF 100V
C1203: 2.2nF (verify)
C1204, C1205: 22uF
C1206, C1207: 1uF
L1201: UNRESOLVED inductor; Rating_basis per DS design procedure for the V_IN ra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
NT1201: PGND-GND star
R1201: UNRESOLVED UVLO top; Rating_basis from V_bat,min
R1202: UNRESOLVED UVLO bottom
R1203: UNRESOLVED RON; Rating_basis on-time vs V_IN range (battery unknown)
R1204: 31.6k (verify VFB)
R1205: 10k
R1206: 100k
TP1201: +5V
TP1202: GND
TP1203: BUCK_PG
U1201: LM5164 (candidate); MPN LM5164DDAR
U1202: TLV75533; MPN TLV75533PDBVR

Connections:
+3V3: C1207.1, R1206.2, U1202.5 (OUT)
+5V: C1204.1, C1205.1, C1206.1, L1201.2, R1204.1, TP1201.1, U1202.1 (IN), U1202.3 (EN)
BUCK_BST: C1203.1, U1201.7 (BST)
BUCK_EN: R1201.2, R1202.1, U1201.3 (EN/UVLO)
BUCK_FB: R1204.2, R1205.1, U1201.5 (FB)
BUCK_PG: R1206.1, TP1203.1, U1201.6 (PGOOD)
BUCK_RON: R1203.1, U1201.4 (RON)
BUCK_SW: C1203.2, L1201.1, U1201.8 (SW)
GND: C1201.2, C1202.2, C1204.2, C1205.2, C1206.2, C1207.2, NT1201.2, R1202.2, R1203.2, R1205.2, TP1202.1, U1201.1 (GND), U1201.9 (EP), U1202.2 (GND)
PGND: NT1201.1
VBAT_PROT: C1201.1, C1202.1, R1201.1, U1201.2 (VIN)

Notes on the sheet:
Logic rails run from VBAT_PROT (before precharge), so the MCU is alive while the link precharges.
