SWORT-Aerospace/sem-motor-controller/(commit log)

2026-10-14 sem-motor-controller: firmware core, CAN contract, host co-simulation
    Portable C11 controller core (config validation, state machine, command
    arbitration, freshness, protection, FOC primitives), generated C/Python CAN
    codecs with golden vectors, host simulation/replay tooling and tests.
    Host simulation only; no hardware validation.
    Claude-Session: https://claude.ai/code/session_01GHmHZxA3w1n62SULRNT3dB
2026-10-14 sem-motor-controller: energy models, DP optimiser, electrical calcs, BOM, CSIA shadow adapter
    Vehicle longitudinal model with coast-down identifiability check, battery
    power maps, spatial dynamic programming with grid convergence and bounded
    pace correction, parameterised inverter calculations with sensitivity study,
    conditional BOM, STM32G474 pin-resource check, and a shadow-mode CSIA
    vehicle adapter (pinned dependency, not vendored). All synthetic.
    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
2026-10-14 sem-motor-controller: architecture freeze v0.1, ADRs, audit, requirements, ICD, validation plan, handoff
    Architecture freeze with frozen boundaries and state-machine transition
    table, ten decision records, source audit with pinned SHAs and licenses,
    requirements with verification mapping, open parameters, rules map (all
    rules unverified: official sites unreachable), interface control document,
    hardware validation and energy-statistics plan, efficiency research with an
    honestly empty evidence matrix, schematic sheet plan, review checklist,
    generated CAN reference, CI workflow and handoff.
    Claude-Session: https://claude.ai/code/session_0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
2026-10-14 sem-motor-controller: four-layer control contract (hard ceilings clamp, bounded envelope ramp)
    - Arbiter: L0 hardware shutdown, L1 inhibits, L2 local hard ceilings
    clamped on the update they are computed (final clamp), L3 supervisory
    envelope ramping at >= slew_down_fast, L4 comfort slew.
    - Core: envelope = min(newest committed limits set, referenced set);
    same-limits_seq refresh no longer evicts the previous set.
    - Validator rule 38 ENVELOPE_RAMP_DEADLINE (C + Python, parity test).
    - 12 contract regression tests (arbiter + CAN/plant); corrected the one
    v0.1 expectation that encoded the defect (now stricter).
    - Host harness semmc_contract_report with an independent oracle;
    before/a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
2026-10-15 sem-motor-controller: explicit actuator model in optimiser; CSIA evaluation harness frozen
    Optimiser (v0.2):
    - DP actions COAST / PROPEL / DRIVER_BRAKE; braking exported as driver
    guidance (never coast), with brake force and dissipated energy.
    - No implicit braking anywhere: overspeed is infeasible in the DP and a
    recorded violation in the simulator; driver model with reaction,
    release and decel-tracking error; brake override zeroes torque.
    - Torque-only policy (propulsion + coast) with exact coast envelope and
    infeasibility diagnosis; flat track variant.
    - Acceleration bound limits torque (energy consistent); v0.1 clip audited.
    - Power map charges motor friction power (omitted in v0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
2026-10-15 sem-motor-controller: v0.2 optimisation results; CSIA held-out evaluation, ablation, post-hoc
    - Optimisation rerun on converged grid (5 m vs 2.5 m: 0.13 %); validity
    includes the 1000 s finish limit; torque-only infeasible on track A
    with physical diagnosis, compared on a flat variant; driver-guidance and
    model-error robustness; v0.1 savings withdrawn in EFFICIENCY_RESEARCH.
    - CSIA: pre-registered held-out evaluation (94 scenarios, 5.8 h) of B1,
    V0-V3v ablation, frozen adapter, TrustCore threshold, B1+CSIA;
    post-hoc debounce analysis kept separate; results and conclusions in
    docs/csia/EVALUATION_RESULTS.md; freeze-enforcing test.
    - Pin allocation: three phase currents on three AD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
2026-10-15 sem-motor-controller: hardware package draft (KiCad), timing, protection, budgets, priced BOM
    - Hierarchical KiCad 7 schematic DRAFT generated from design data (12
    sheets, 206 parts, 135 nets); kicad-cli netlist connectivity equals the
    intended connectivity (0 problems). Rating-dependent parts UNRESOLVED;
    project-library pinouts (DRV8353S, INA228) flagged UNVERIFIED. Review PDF.
    - Pin allocation: PRECHG_EN added; LQFP100 baseline (LQFP64 fails).
    - Timing budget: deadtime encoding, simultaneous 3-ADC sampling, sampling
    window; found that full linear modulation leaves one sampleable phase at
    60 deg -> new calibrated parameters inverter.voltage_limit_fraction and
    current_sample_sett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
2026-10-15 sem-motor-controller: CAN/CHUDS integration specifics, rules reconciliation, input sheet
    - CHUDS evidence (urban-concept@c422c0f): CAN FD 500k/2M at 80%/80%,
    classic frames dropped as ForeignFrame, 0x300-0x7FF reserved for future
    classes, accept-all MCP filters, Emergency STOP semantics; no wiring docs.
    - FDCAN must run in FD mode with matching data-phase timing: bit-timing
    calculator shows 8 MHz cannot reach the 80% data sample point -> crystal
    changed to 40 MHz in the schematic draft; platform requirements updated.
    - VCU-side raw SocketCAN bridge proposal (classic semmc frames on the FD
    bus) with unit tests (no AF_CAN in this container: socket path untested).
    - Rules reconciliati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
2026-10-15 sem-motor-controller: checkpoint v0.2 report; README/HANDOFF status
    Adds docs/CHECKPOINT_v0.2.md (commits, tests run and results, control,
    optimiser and CSIA findings, schematic/BOM maturity, evidence-classed
    cost range, input sheet pointer, bench-demo path, grouped blocking
    questions, repository extraction) and the changed-file list since v0.1.
    README status table now reads: control contract corrected; host
    implementation verified; functional hardware architecture v0.2 draft;
    NOT hardware-frozen, NOT fabrication-ready, NOT vehicle-validated,
    budget NOT shown feasible. HANDOFF.md (v0.1) is kept as a record with
    a pointer to v0.2 and a list of the figures it supersedes.
    Verified before commi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
2026-10-15 sem-motor-controller v0.3: vehicle-interface provenance, transport-neutral core, clock trees, schematic checks
    Provenance: the Cornell repositories are reference projects. Every place
    that treated CHUDS / CAN FD / its VCU / 40 MHz as our vehicle is relabelled
    or corrected (docs/PROVENANCE_AUDIT.md); the v0.2 checkpoint is preserved
    with an errata banner.
    Firmware: the core is transport-neutral (mc_core_on_msg_rx /
    mc_core_msg_tx_poll / mc_core_on_link_state). CAN is one binding
    (src/transport/mc_can_binding.c) whose 64-identifier block base is the new
    calibration parameter supervision.can_id_base (id 164, rule 40, null in the
    unconfigured config). ADR-0012. Tests: block relocation with a fu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
2026-11-07 Rewrite README as plain, professional documentation (#8)
    * Rewrite README as plain, professional documentation
    Restructure the README around a short project description, a
    "What's in it" list, a sentence-case status table (area, state,
    reference), the repository layout, grouped reproduce commands and
    documentation links. Replace the all-caps status labels and the
    "truthful labels" heading; every limitation from the previous table
    is kept. Only README.md changes; all relative links were checked.
    Claude-Session: https://claude.ai/code/session_01VT4bdPBaMVtUbsQuNP9GjU
    * README: mark the design objective as proposed, as the requirements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
